aaronblankenburg/timon-box/doc/assembly/fig/overview.jpg

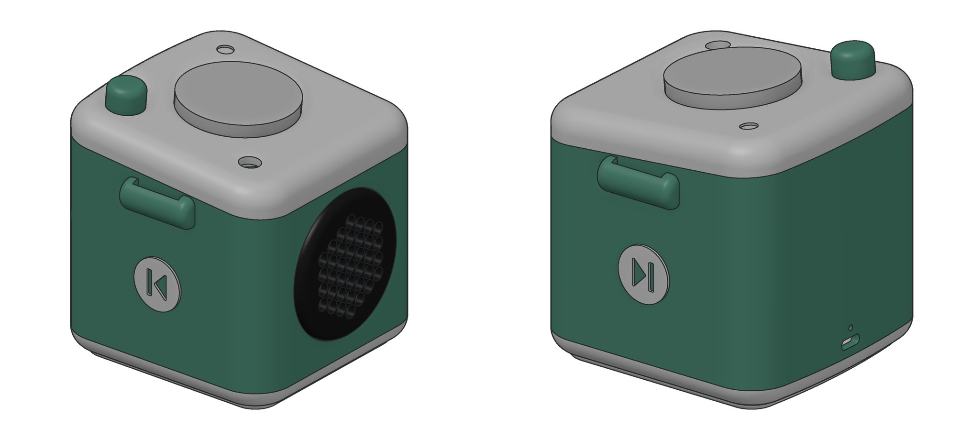
doc/assembly/fig/overview.jpg
