aaronblankenburg/timon-box/doc/assembly/fig/overview_a.jpg

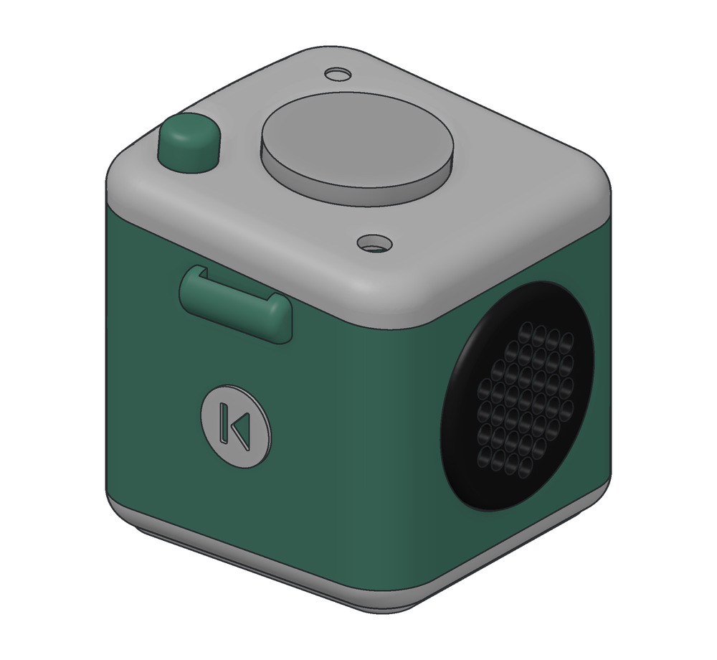
doc/assembly/fig/overview_a.jpg
