aaronblankenburg/timon-box/doc/assembly/fig/overview_b.jpg

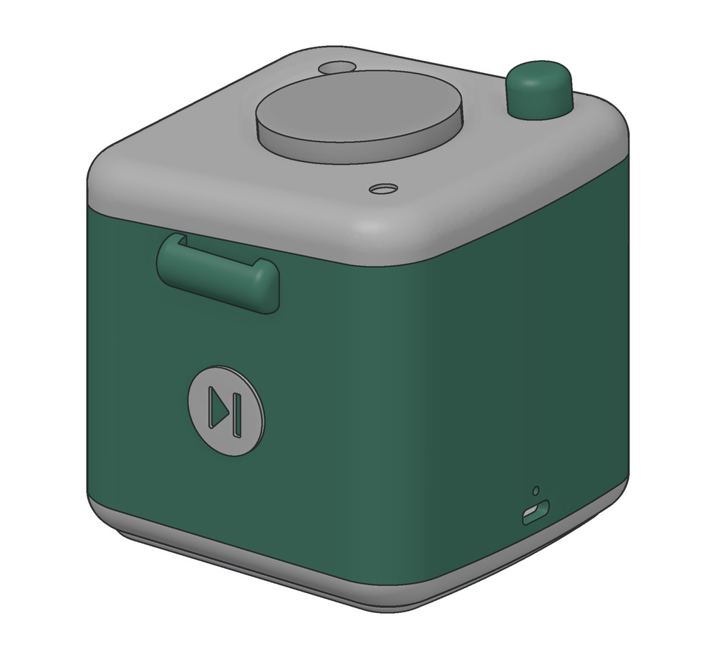
doc/assembly/fig/overview_b.jpg
