aaronblankenburg/timon-box/doc/assembly/fig/thingiverse/07_electronics.jpg

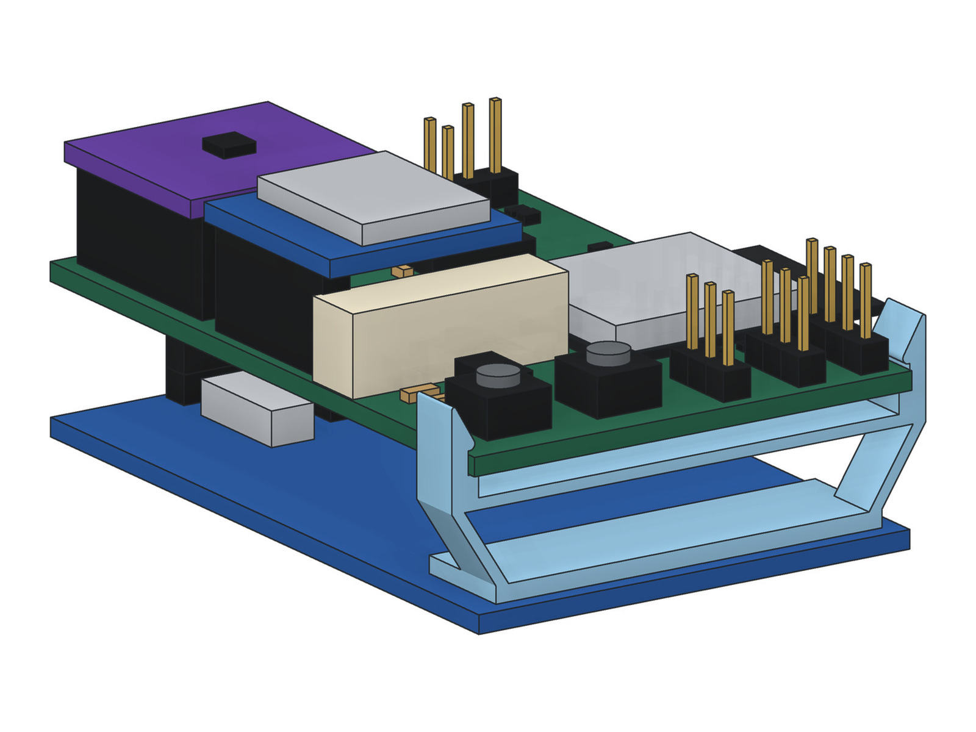
doc/assembly/fig/thingiverse/07_electronics.jpg
