aaronblankenburg/timon-box/models/pcb_spacer.step

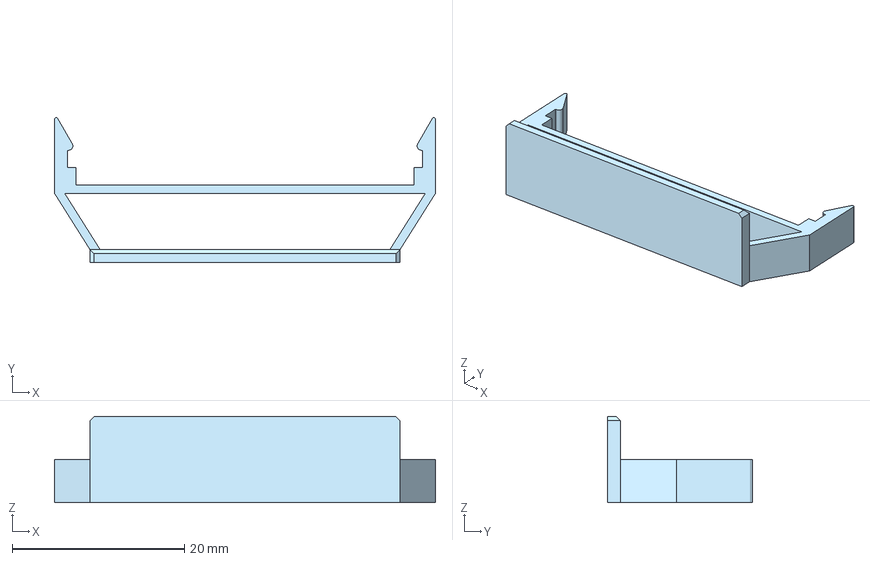
[picture p16: CAD file, 2026-10-31]
models/pcb_spacer.step
44.2 x 16.8 x 10.0 mm
