aaronblankenburg/timon-box/models/plates/timon-box_plate-3_grill-spacer.3mf

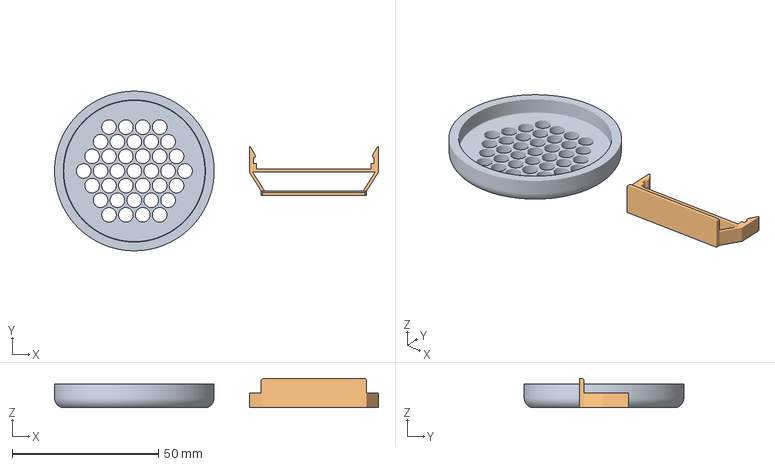
[picture p17: CAD file, 2026-11-01]
models/plates/timon-box_plate-3_grill-spacer.3mf
110.8 x 54.6 x 10.0 mm
timon-box_speaker-grill
timon-box_pcb-spacer
