aaronblankenburg/timon-box/models/stl/timon-box_back.stl

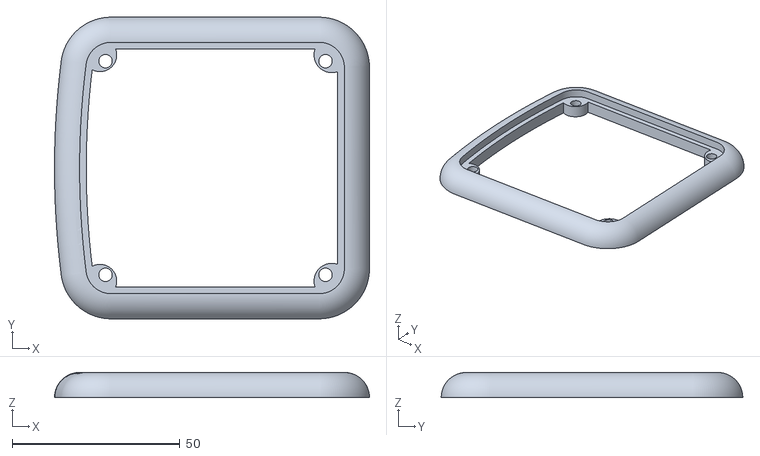
[picture p18: CAD file, 2026-11-01]
models/stl/timon-box_back.stl
94.0 x 90.0 x 7.50
