aaronblankenburg/timon-box/models/box.step

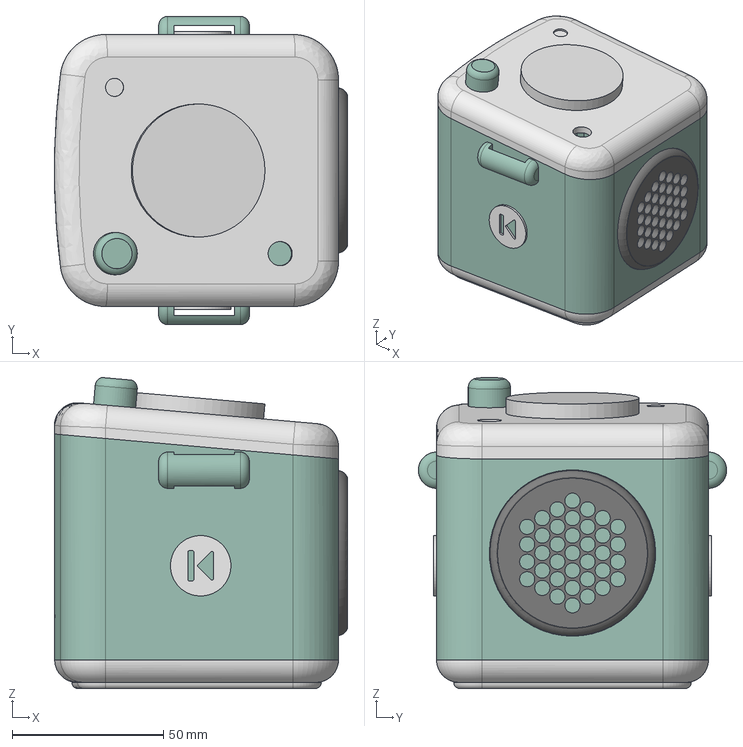
[picture p19: CAD file, 2026-10-30]
models/box.step
97.0 x 102.0 x 102.9 mm
