aaronblankenburg/timon-box/models/plates/timon-box_plate-4_bumper-tpu.3mf

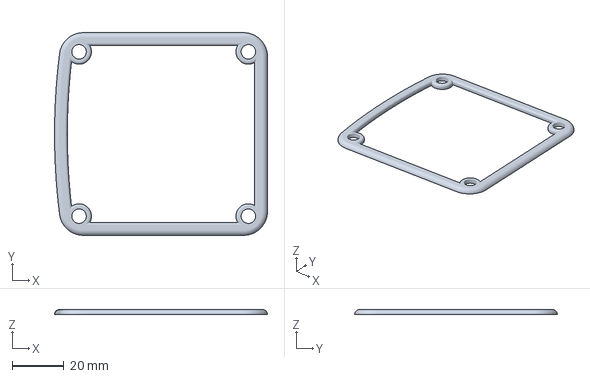
[picture p20: CAD file, 2026-11-01]
models/plates/timon-box_plate-4_bumper-tpu.3mf
82.6 x 78.6 x 2.00 mm
