aaronblankenburg/timon-box/models/plates/timon-box_bambu-studio.3mf

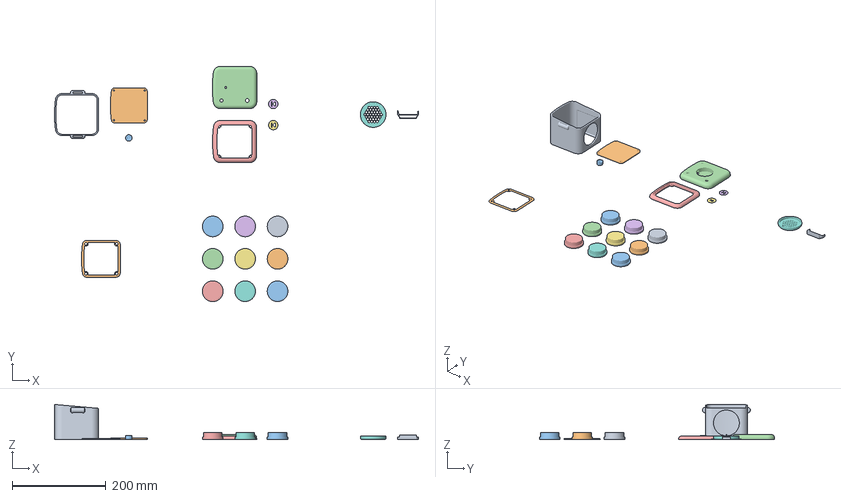
[picture p21: CAD file, 2026-11-01]
models/plates/timon-box_bambu-studio.3mf
775.1 x 500.7 x 74.7 mm
timon-box_frame_1
timon-box_door_1
timon-box_volume-knob_1
timon-box_front_1
timon-box_back_1
timon-box_prev-button_1
timon-box_next-button_1
timon-box_speaker-grill_1
timon-box_pcb-spacer_1
timon-box_bumper-tpu_1
timon-box_token_2
timon-box_token_3
timon-box_token_6
timon-box_token_5
timon-box_token_1
timon-box_token_4
timon-box_token_7
timon-box_token_8
timon-box_token_9
