aaronblankenburg/timon-box/models/stl/timon-box_door.stl

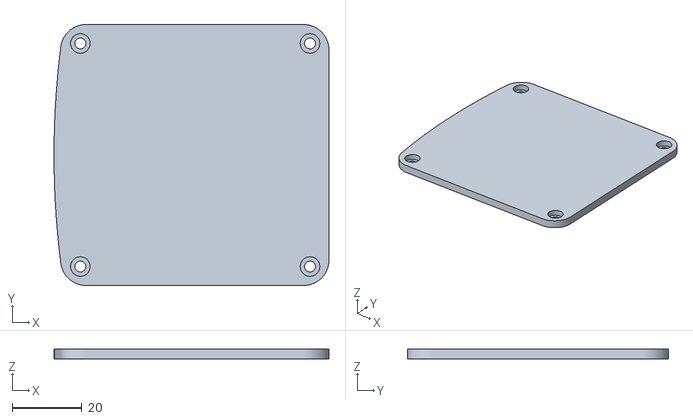
[picture p22: CAD file, 2026-11-01]
models/stl/timon-box_door.stl
78.6 x 74.6 x 2.90
