aaronblankenburg/timon-box/models/plates/timon-box_plate-2_lid-bottom-buttons.3mf

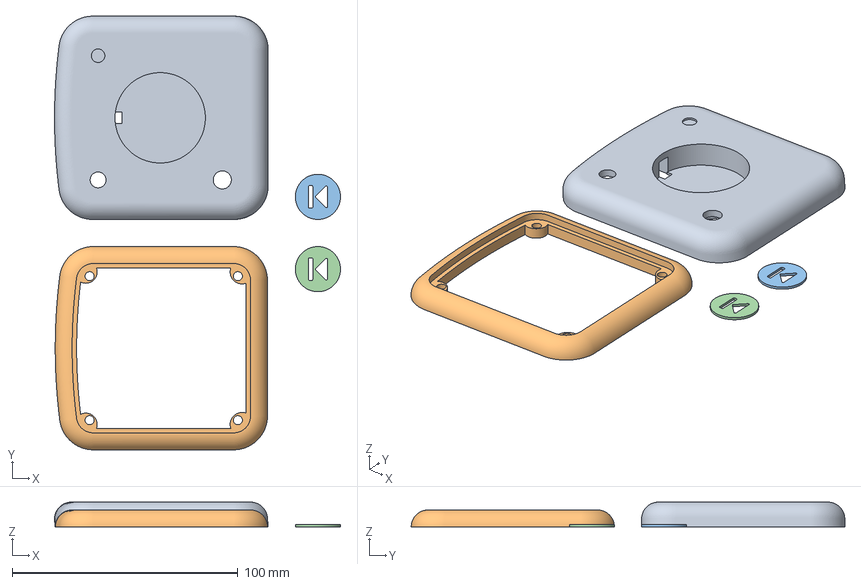
[picture p23: CAD file, 2026-11-01]
models/plates/timon-box_plate-2_lid-bottom-buttons.3mf
126.6 x 192.0 x 11.0 mm
timon-box_front
timon-box_back
timon-box_prev-button
timon-box_next-button
