aaronblankenburg/timon-box/models/stl/timon-box_next-button.stl

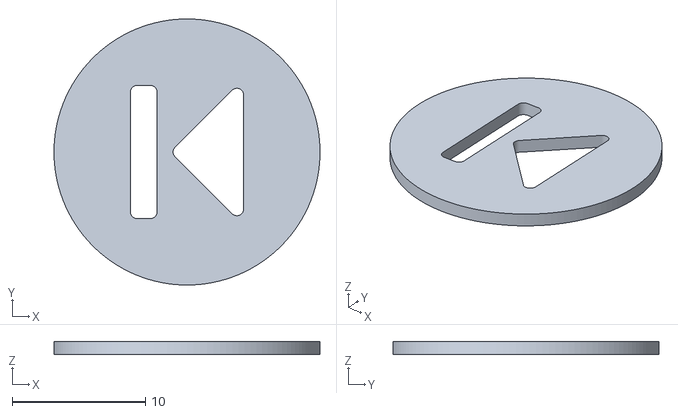
[picture p24: CAD file, 2026-11-01]
models/stl/timon-box_next-button.stl
20.0 x 20.0 x 1.00
