aaronblankenburg/timon-box/models/plates/timon-box_plate-5_9-tokens.3mf

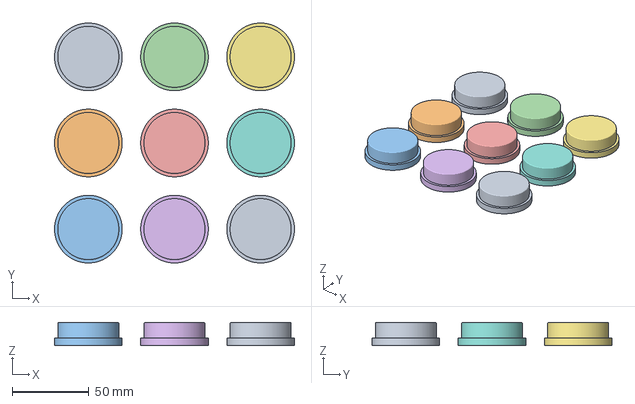
[picture p25: CAD file, 2026-11-01]
models/plates/timon-box_plate-5_9-tokens.3mf
156.0 x 156.0 x 15.0 mm
