aaronblankenburg/timon-box/models/stl/timon-box_volume-knob.stl

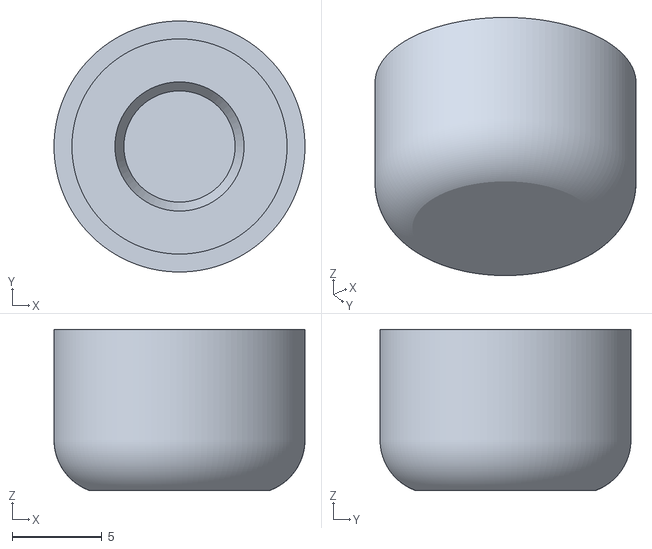
[picture p26: CAD file, 2026-11-01]
models/stl/timon-box_volume-knob.stl
14.0 x 14.0 x 9.00
