aaronblankenburg/timon-box/models/plates/timon-box_plate-1_frame-door-knob.3mf

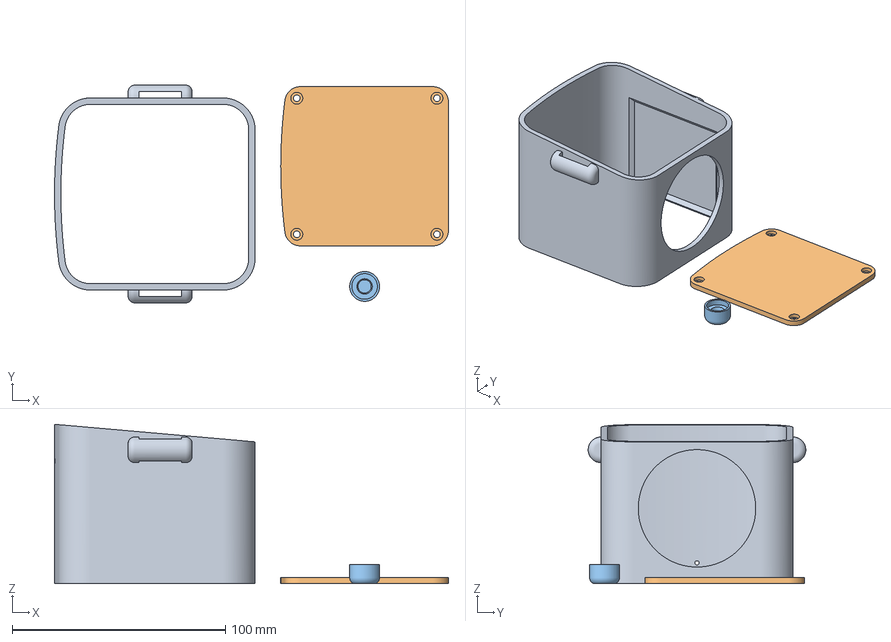
[picture p27: CAD file, 2026-11-01]
models/plates/timon-box_plate-1_frame-door-knob.3mf
184.6 x 102.0 x 74.7 mm
timon-box_frame
timon-box_door
timon-box_volume-knob
