aaronblankenburg/timon-box/models/stl/timon-box_token.stl

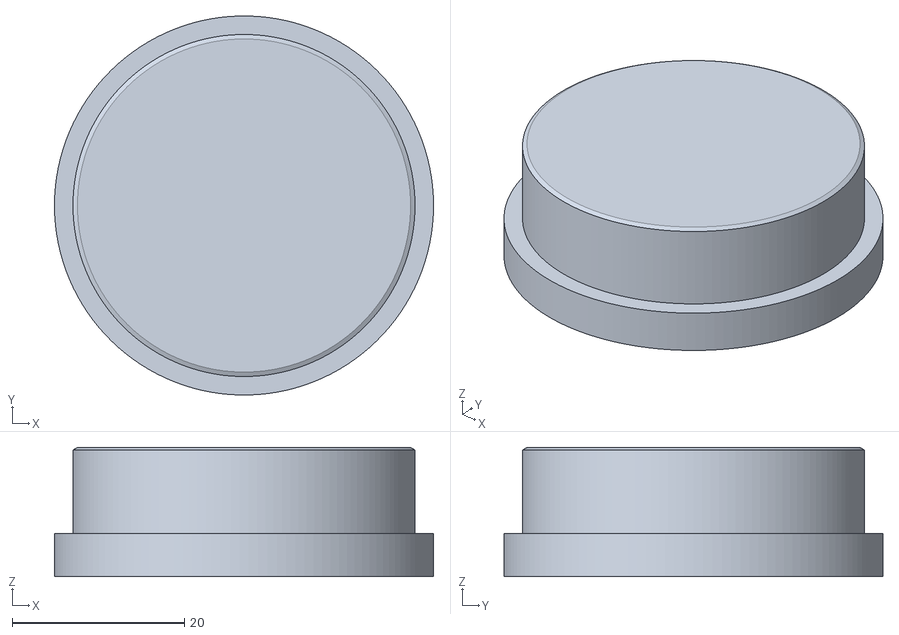
[picture p28: CAD file, 2026-11-01]
models/stl/timon-box_token.stl
44.0 x 44.0 x 15.0
