aaronblankenburg/timon-box/models/stl/timon-box_speaker-grill.stl

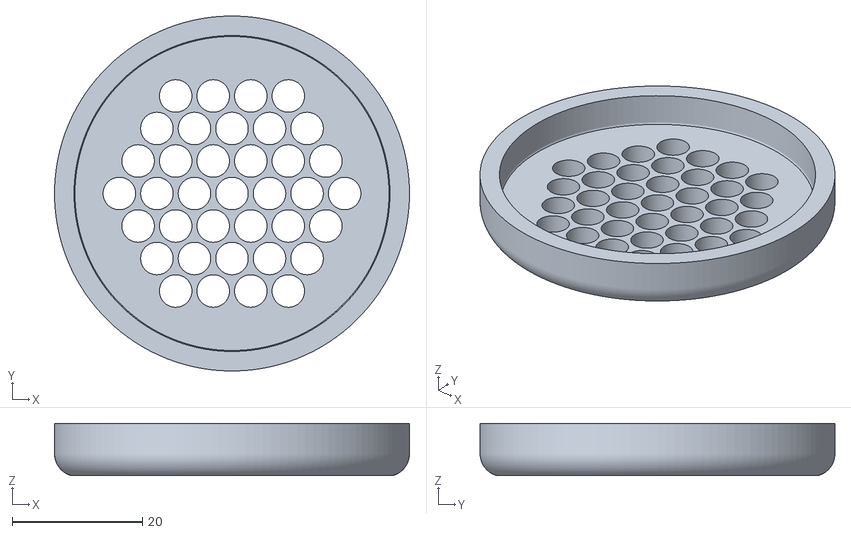
[picture p29: CAD file, 2026-11-01]
models/stl/timon-box_speaker-grill.stl
54.6 x 54.6 x 8.00
