aaronblankenburg/timon-box/models/stl/timon-box_frame.stl

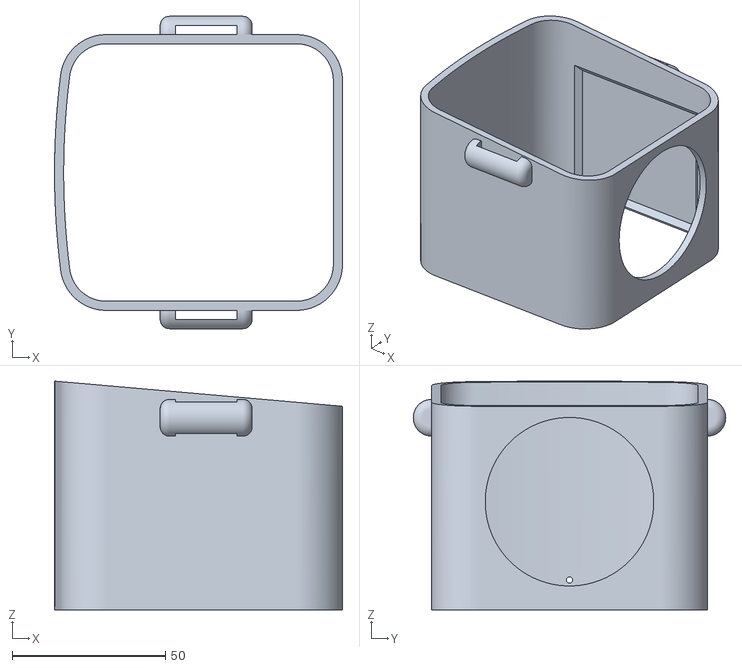
[picture p30: CAD file, 2026-11-01]
models/stl/timon-box_frame.stl
94.0 x 102.0 x 74.7
