aaronblankenburg/timon-box/models/stl/timon-box_front.stl

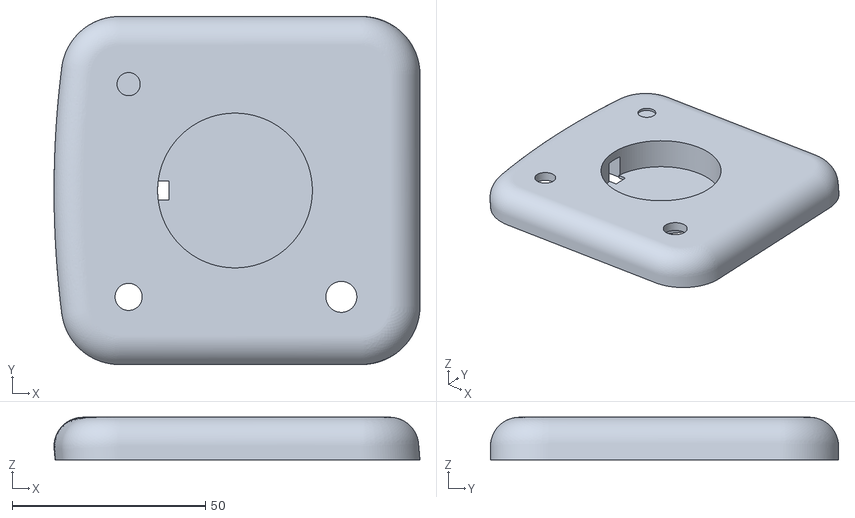
[picture p31: CAD file, 2026-11-01]
models/stl/timon-box_front.stl
94.6 x 90.0 x 11.0
