aaronblankenburg/timon-box/(list of files, cad)

Other CAD files:
models/stl/timon-box_bumper-tpu.stl
models/stl/timon-box_prev-button.stl
models/stl/timon-box_pcb-spacer.stl
