aaronblankenburg/timon-box/doc/assembly.pdf

HARDWARE-DOKU · BAUANLEITUNG

# Timon Box

## Elektronik, Druck und Zusammenbau

Platinen bestücken,
verkabeln, Gehäuse drucken und alles Schritt für Schritt zusammenbauen.


github.com/aaronblankenburg/timon-box Modell: models/box.step
Platinen: hardware/ (KiCad 8) Hintergründe: doc/hardware.md
Stand: Oktober 2026
Lizenz: CC BY-NC-SA 4.0
© 2026 Aaron Blankenburg

Inhalt

# 1 Überblick

Das Gehäuse besteht aus zehn Druckteilen. Rahmen, Boden und Deckel werden zu einer Schale verklebt. Unten bleibt eine Bodenklappe, die mit vier M3-Schrauben in Einschmelzgewinden hält. Durch sie kommt man nach dem Zusammenbau wieder an die Elektronik.

Vorn ist die Lautsprecherseite. Von vorn gesehen liegt die Taste „zurück“ links und „vor“ rechts, passend zu J2 und J3 (Kapitel 5.4). Der Deckel ist um 5° nach vorn geneigt, die Rückseite mit der USB-C-Buchse ist leicht gewölbt.

Lautstärke
Token-Mulde
RC522 darunter
LED
Lasche
für den Tragegurt

Lautsprecher
Taste „zurück“
Piezo innen

Kopfhörerbuchse
noch verschlossen

Taste „vor“
Rückseite
leicht gewölbt
Ladeanzeige
Lichtleiter zur
Lade-LED
USB-C
Laden und Flashen
Bumper (TPU)

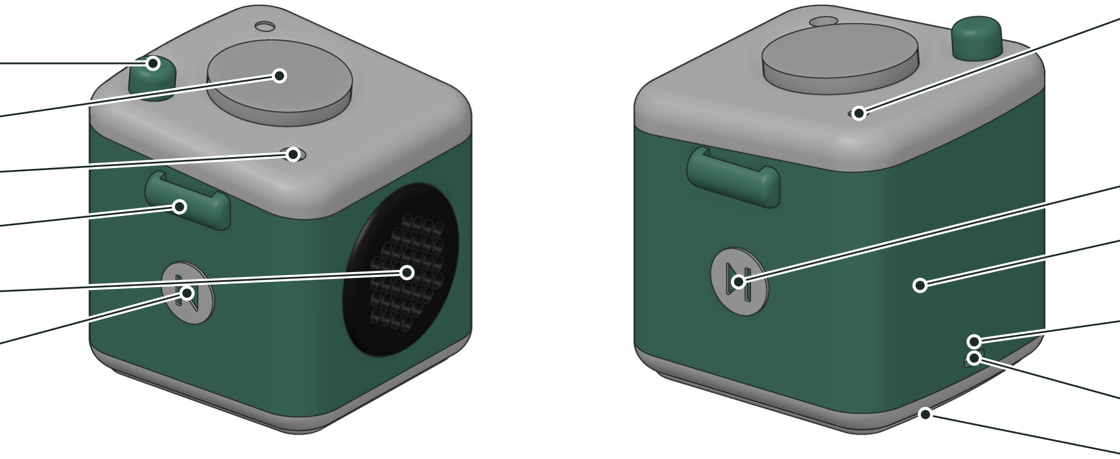
[picture p64: figure]

Abb. 1 Links von vorn, rechts von hinten.

Maß | Wert
Grundfläche | 94 × 90 mm, mit Laschen 102 mm breit
Höhe mit Bumper | hinten 94,5 mm, vorn 87 mm
Darüber | Token 5 mm, Drehknopf 9 mm über der Deckeloberfläche

## Auf einen Blick

DRUCK
PETG oder PLA, Bumper
TPU, 0,2 mm Schichthöhe

VERBINDUNGEN
Sekundenkleber,
2K-Kleber, UV-Lack,
Heißkleber, Klebeband

SCHRAUBEN
4 × M3 × 5 in
Einschmelzgewinden M3

AKKUS
2 × 18650, parallel
geschaltet

Hinweis: Firmware, Platinen, Modell und diese Anleitung liegen im Repo github.com/aaronblankenburg/timon-box. Kapitel 5 beschreibt den Aufbau der Elektronik, Kapitel 6 den Zusammenbau. Hintergründe zur Schaltung stehen in doc/hardware.md, die Pinbelegung der Firmware in doc/architecture.md, das Abstimmen der Klopfsensoren in doc/development.md.

Timon Box · Bauanleitung | Überblick
Stand Oktober 2026 · © Aaron Blankenburg · Lizenz CC BY-NC-SA 4.0 | Seite 2 von 30

# 2 Druckteile

Die Teilenamen sind die aus dem STEP-Modell models/box.step. Dort liegen alle Teile in Einbaulage. Der Abstandshalter für die Elektronik liegt als eigene Datei in models/pcb_spacer.step.

Teil | Funktion | Material | Befestigung
front | Deckel mit Token-Mulde, LED, Poti, Kopfhörerbuchse und Tasche für den Mikroschalter | PETG/PLA | Sekundenkleber auf frame
frame | Rahmen: Seitenwände mit Laschen für den Tragegurt, Lautsprecheröffnung, USB-C-Ausschnitt. An den Tasten ist die Wand innen auf 1 mm gedünnt | PETG/PLA | –
back | Boden: Rahmen um die Klappe mit vier Gewindeeinsätzen | PETG/PLA | Sekundenkleber an frame
door | Bodenklappe | PETG/PLA | 4 × M3 × 5 in back
bumper | Fuß unter der Klappe | TPU | Sekundenkleber an door
speaker grill | Lautsprechergitter, mit Stoff bezogen | PETG/PLA | eingesetzt, Sekundenkleber
prev button | Taste „zurück“, Ø 20 × 1 mm | PETG/PLA | Sekundenkleber, außen auf frame
next button | Taste „vor“, Ø 20 × 1 mm | PETG/PLA | Sekundenkleber, außen auf frame
volume | Drehknopf | PETG/PLA | auf die Poti-Achse gesteckt
token | Token mit eingedrucktem NFC-Tag, einer je Album | PETG/PLA | –
pcb_spacer | Abstandshalter zwischen Hauptplatine und RC522, eigene Datei models/pcb_spacer.step | PETG/PLA | eingeclipst

volume
Drehknopf

prev button
Taste „zurück“

door
Bodenklappe

token

front
Deckel

next button
Taste „vor“

speaker grill
Lautsprechergitter
frame
Rahmen

back
Boden

bumper
Fuß, TPU

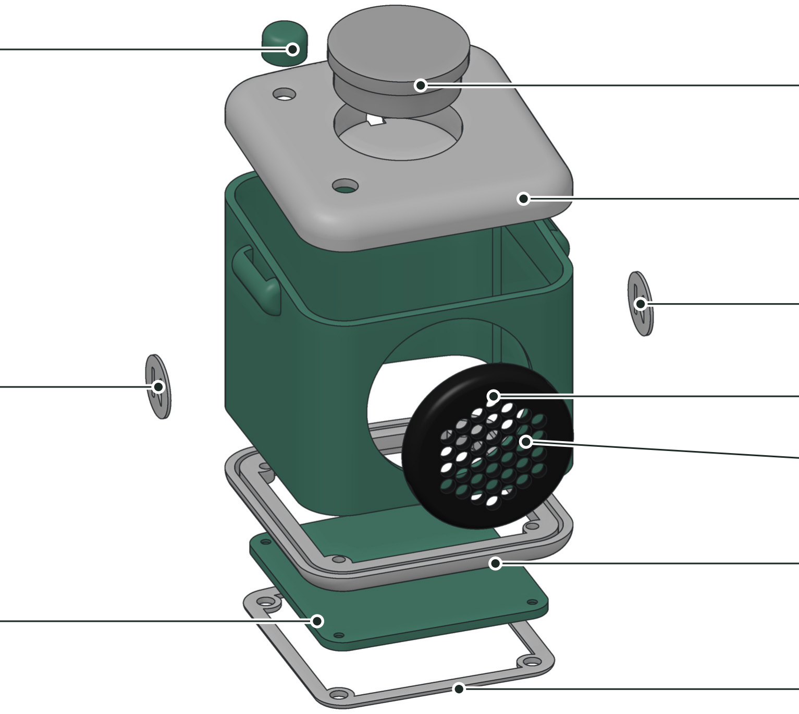
[picture p65: figure]

Abb. 2 Explosionszeichnung. Unten die Klappe mit Bumper, seitlich die Tasten, vorn das Lautsprechergitter.

Timon Box · Bauanleitung | Druckteile
Stand Oktober 2026 · © Aaron Blankenburg · Lizenz CC BY-NC-SA 4.0 | Seite 3 von 30

# 3 Drucken

Alle Teile außer dem Bumper aus PETG oder PLA, den Bumper aus TPU. PETG verträgt Wärme besser, etwa im Auto oder auf der Fensterbank.

Am schnellsten geht es mit den fertigen Druckbetten in models/plates/: eine 3MF-Datei pro Farbe, die Teile schon angeordnet, für Betten ab 220 × 220 mm. In PrusaSlicer öffnet man sie als Projekt (Datei › Projekt öffnen), dann sind Schichthöhe, Wände, Füllung, Stützen und die Pause für die Tokens schon eingestellt. Für Bambu Studio liegt dort ein Projekt mit allen fünf Betten, ebenfalls fertig eingestellt. Andere Slicer übernehmen nur die Anordnung. Einzelne Teile liegen als STL in models/stl/, benannt wie in der Tabelle und schon so gedreht, wie sie aufs Bett kommen.

Einstellungen: 0,2 mm Schichthöhe, 3 Wände, 15–20 % Füllung. Die NFC-Tasche im Token ist auf 0,2 mm Schichthöhe ausgelegt.

Teil | Aufs Druckbett | Stützen | Hinweis
frame | Unterkante | im Lautsprecherloch und unter den Laschen | Das Gitter hat nur 0,2 mm Spiel: Loch entgraten
front | Unterkante, Oberseite nach oben | innen unter der Decke, nur vom Druckbett (Baumstützen) | Taschen für Mikroschalter und Buchse freimachen
back | Seite zum Rahmen (kopfüber) | keine
door | Innenseite | keine | Senkungen zeigen nach oben
bumper | Klebeseite | keine | TPU, langsam drucken
speaker grill | Außenseite | keine
prev button, next button | Sichtseite | keine | 1 mm dünn
volume | Oberseite | keine
token | Oberseite (Bildseite) | keine | Pause vor der letzten Schicht für den NFC-Tag, siehe unten
pcb_spacer | flache Seite | keine | Eigene Datei, siehe Kapitel 5.2

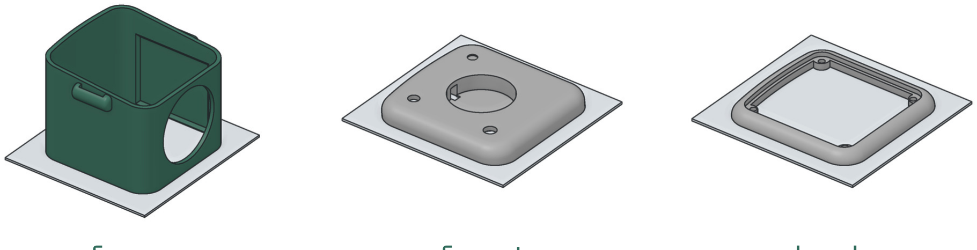
[picture p66: figure]

frame
Unterkante

front
Unterkante

back
kopfüber

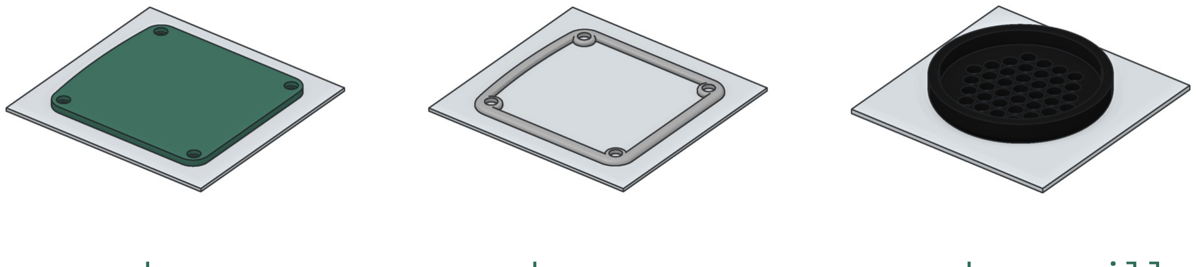
[picture p67: figure]

door
Innenseite

bumper
Klebeseite, TPU

speaker grill
Außenseite

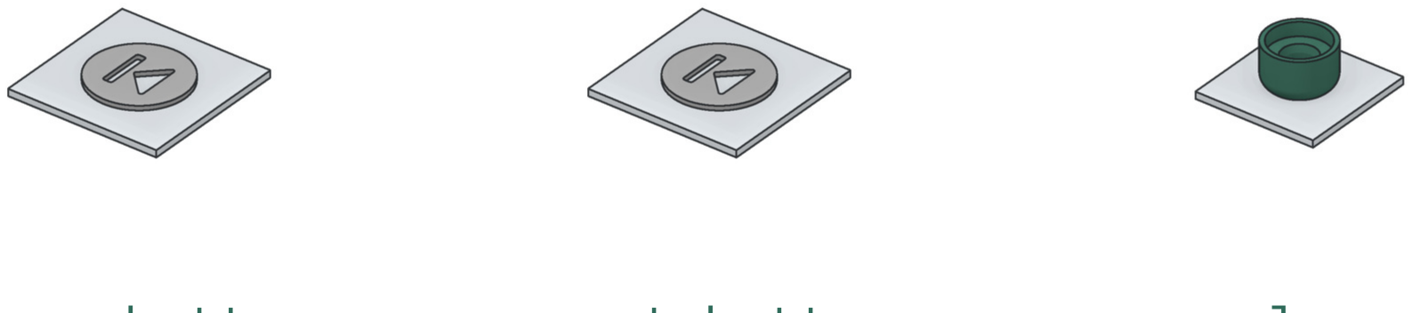
[picture p68: figure]

prev button
Sichtseite

next button
Sichtseite

volume
Oberseite

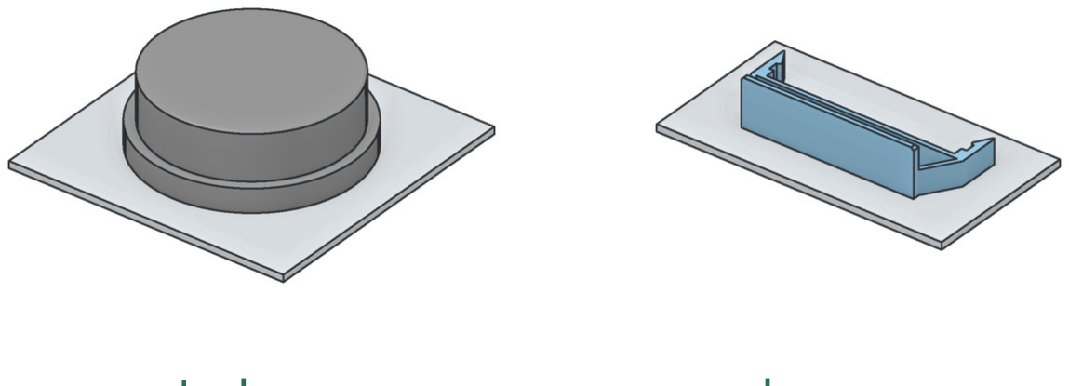
[picture p69: figure]

token
Oberseite

pcb_spacer
flache Seite

Abb. 3 Druckausrichtung, die graue Fläche ist das Druckbett.

Tipp: Den Deckel mit der Oberseite nach oben drucken. Andersherum lägen die gerundeten Kanten (R 7,5) direkt auf dem Bett und würden unsauber. So bleiben Oberseite und Rundungen glatt, die Stützen sitzen innen, wo man sie nicht sieht. Die Bohrung der Kopfhörerbuchse ist oben mit einer 0,2-mm-Schicht verschlossen und bleibt zu, solange keine Buchse eingebaut ist.

Timon Box · Bauanleitung | Drucken
Stand Oktober 2026 · © Aaron Blankenburg · Lizenz CC BY-NC-SA 4.0 | Seite 4 von 30

## Token mit NFC-Tag

Der Token ist 15 mm hoch und innen hohl. 0,2 mm über der Unterseite liegt eine Tasche (Ø 26 × 0,4 mm) für einen runden NFC-Klebetag: 25 mm, NTAG, höchstens 0,4 mm dick.

Körper Ø 39,7 mm
passt in die Mulde Ø 40

Rand
liegt im Gehäuse auf
dem Deckel
Oberseite Ø 44 mm
liegt auf dem Bett

Fase
NFC-Tasche Ø 26 ×
0,4 mm
0,2 mm unter der
Unterseite
Hohlraum

Druckbett

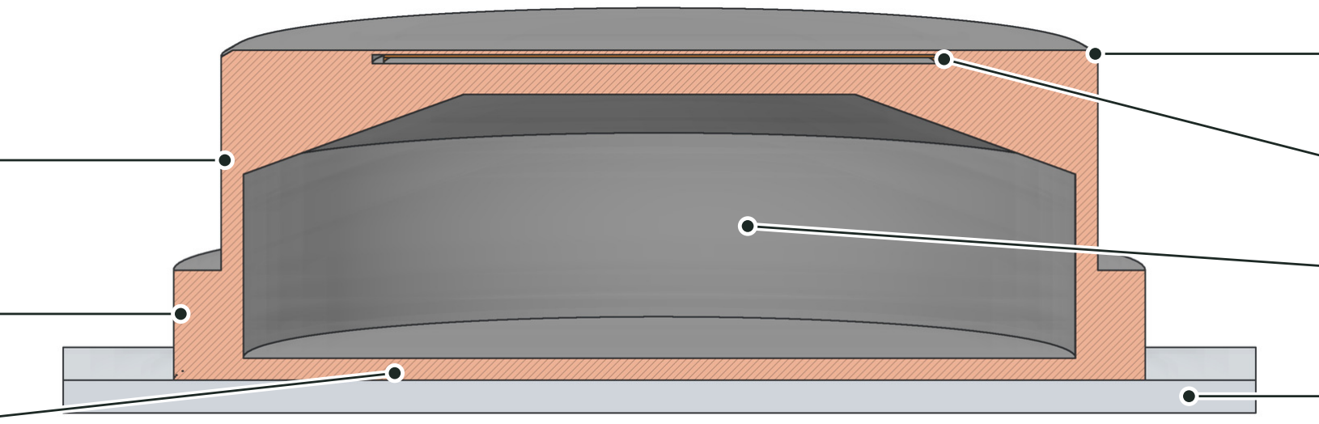
[picture p70: figure]

Abb. 4 Token im Schnitt, so wie er gedruckt wird.

- Den Token mit der Oberseite (Ø 44 mm) aufs Bett legen. Die Bildfläche wird so glatt, und der breite Rand haftet gut.
- Im Slicer eine Pause vor der letzten Schicht einfügen, bei 0,2 mm Schichthöhe vor Z = 15,0 mm. Dann ist die NFC-Tasche oben offen.
- In der Pause den NFC-Tag mit der Klebeseite nach unten in die Tasche legen und andrücken. Weiterdrucken, die letzte Schicht schließt die Tasche. Der Tag liegt dann 0,2 mm unter der Unterseite, direkt über dem RC522.
- Warnt der Slicer vor langen Brücken, ist das die Decke über dem Hohlraum im Token. Damit ist zu rechnen.
- Das Bild aus dem Token-Bogen (tools/token-sheet.html) grob ausschneiden, zum Beispiel mit doppelseitigem Klebeband auf die Oberseite (Ø 44 mm) kleben und ringsum an der Kante abschneiden.

Druckbett

Z 0–14,4 Token, Oberseite auf dem Bett

NFC-Tag | Z 14,4–14,6 Tasche Z 14,6–14,8 Tasche

Z 14,8–15,0 letzte Schicht, schließt die Tasche

Pause: Tag einlegen

Hinweis: Sondertokens für Bluetooth und Management werden genauso gedruckt. Ihre UIDs kommen in die platformio.ini, siehe Kapitel 5.5.

Timon Box · Bauanleitung | Drucken
Stand Oktober 2026 · © Aaron Blankenburg · Lizenz CC BY-NC-SA 4.0 | Seite 5 von 30

# 4 Material und Werkzeug

## Zukaufteile fürs Gehäuse

Teil | Anzahl | Anmerkung
Gewindeeinsatz M3 | 4 | Für Bohrung Ø 4,0 mm, 4 mm lang. Bis 5,7 mm geht, ragt dann innen 1,2 mm heraus

Zylinderkopfschraube M3 × 5, ISO

4762 | 4 | Kopf Ø 5,5 mm versinkt in der Senkung Ø 5,6 mm und im Bumper. Nicht länger als 5 mm: In zwei Ecken steht direkt über dem Einsatz ein Akku
18650-Zelle | 2 | Einfache Zellen ohne Schutzschaltung (65 mm) mit Lötfahnen, gleicher Typ und gleiche Spannung. Parallel geschaltet
Stoff | 1 Stück, 8 × 8 cm | Dünn und dehnbar, zum Beispiel eine Socke
NFC-Klebetag, rund, 25 mm | je Token | NTAG, höchstens 0,4 mm dick
Rolladengurt, ca. 15 mm breit | ca. 30 cm | Tragegurt durch die Laschen, aus dem Baumarkt
Kabelbinder, schmal | 1 | Um Hauptplatine, Abstandshalter und RC522
Transparentes Filament, 1,75 mm | ein paar cm | Lichtleiter von der Lade-LED nach außen, darf gebogen verlaufen

## Kleber und Kleinkram

Material | wofür
Sekundenkleber | Gehäuseschale, Tasten, Lautsprechergitter, Bumper
2-Komponenten-Kleber (Epoxid) | Lautsprecher, Ladeschaltung, Step-up
UV-Lack mit UV-Lampe | LED, USB-C-Buchse, Mikroschalter
Heißkleber | Akkus
Dünnes doppelseitiges Klebeband | Piezos, RC522, Bilder auf den Token
Kapton-Band, Schrumpfschlauch | Akkukontakte und Lötstellen isolieren
Nadel und reißfestes Garn oder Nähmaschine | Tragegurt
Schleifpapier, Grundierung, Lack | optional, für die Oberfläche

## Elektronik im Gehäuse

Die vollständige Teileliste steht in Kapitel 5.1. Diese Teile müssen zum Gehäuse passen:

Teil | Ort | Passt, wenn …
Lautsprecher, 3 W | innen am Gitter | Ø 50–57 mm liegt mit dem Rand auf dem Ring (Ø 48,6–54,6 mm); kleinere sitzen im Ring direkt am Gitter
Piezo-Scheibe, ca. 35 mm | innen an den Seitenwänden | gedünnte Fläche 56 × 50 mm
PL9823, 8 mm | Deckel vorn links | Bohrung Ø 8 mm
Poti 10 kΩ | Deckel hinten links | Gewinde M7 (Bohrung Ø 7 mm), Achse 6 mm rund. Gewindehülse und Mutter müssen in die 3 mm tiefe Aussparung im Knopf passen
RC522 | unter der Token-Mulde | Muldenboden 1 mm
Mikroschalter | Tasche neben der Mulde | Hebel reicht durch den Schlitz in die Mulde
USB-C-Platine | Rückwand unten | Ausschnitt 9,2 × 3,5 mm
Timon Box · Bauanleitung | Material und Werkzeug
Stand Oktober 2026 · © Aaron Blankenburg · Lizenz CC BY-NC-SA 4.0 | Seite 6 von 30

Teil | Ort | Passt, wenn …
Power Latch mit TP4056 | Wandinnenseite, nahe der USB-C-Buchse | Lichtleiter vom Loch Ø 2 mm bis an die Lade-LED
Step-up 5 V | freie Stelle an der Wandinnenseite

nicht auf den gedünnten Tastenflächen

Kopfhörerbuchse 3,5 mm | Deckel hinten rechts, optional | Bohrung Ø 6 mm, Tasche 12 × 7 × 2 mm

## Werkzeug

Lötkolben (für die Einsätze eine Einschmelzspitze oder eine alte Spitze), Innensechskant 2,5 mm, UV-Lampe, Heißklebepistole, Multimeter, Säge oder Seitenschneider für die Poti-Achse, Cutter, Schleifpapier. Für die Elektronik dazu: Lötkolben mit feiner Spitze, Lötzinn, Flussmittel, Entlötlitze, Pinzette, Abisolierzange und ein USB-C-Kabel zum Flashen.

# 5 Elektronik

Die Elektronik besteht aus zwei Platinen und ein paar lose verdrahteten Teilen. Die Bestückungspläne sind direkt aus den KiCad-Dateien unter hardware/ gezeichnet, die Schaltpläne stehen im Anhang.

- Hauptplatine (40,9 × 60,5 mm): ESP32, USB-seriell-Wandler CH340C, 3,3-V-Regler und drei Module auf Buchsenleisten: I²S-Verstärker MAX98357A und SD-Karte oben, RFID-Leser RC522 unten.
- Power Latch V2 (31,3 × 18,3 mm): Lademodul TP4056, Umschaltung zwischen USB und Akku und die Selbsthaltung. Ein Mikroschalter schaltet die Box ein, wenn ein Token aufgelegt wird. Danach hält der ESP32 die Box selbst an. Anders lässt sie sich nicht einschalten, auch nicht über USB.
- Lose verdrahtet: 18650-Zellen, USB-C-Buchse, Boost-Wandler auf 5 V, zwei 2N7000, Mikroschalter, zwei Piezos, Poti, LED und Lautsprecher.
Ein 7-poliges Kabel verbindet die Hauptplatine mit der Stromseite. Über dieses Kabel laufen auch die USB-Datenleitungen. Die USB-C-Buchse am Gehäuse lädt also den Akku und dient zugleich zum Flashen.

## 5.1 Teileliste

Teil | Anzahl | Anmerkung
ESP32-WROOM-32, -32D oder -32E | 1 | Ohne PSRAM. Ein WROVER geht nicht, dort belegt der PSRAM GPIO 16
und 17, die SD-Karte braucht sie
MAX98357A-Modul | 1 | I²S-Verstärker. 7 Pins: LRC, BCLK, DIN, GAIN, SD, GND, VIN
microSD-Modul für 3,3 V | 1 | 6 Pins: 3V3, CS, MOSI, CLK, MISO, GND. Die Platine wird gekürzt (Schritt
E5)
RC522-Modul | 1 | RFID mit 13,56 MHz. 8 Pins, sitzt unter der Hauptplatine

TP4056-Lademodul mit
Schutzschaltung
1 | Wird auf die Rückseite der Power Latch gelötet
Boost-Modul mit festen 5 V | 1 | Manche Module stellt man erst mit Lötbrücken auf 5 V
18650-Zelle | 1–2 | Einfache Li-Ion-Zellen, 65 mm lang. Im gedruckten Gehäuse zwei, parallel. Die Schutzschaltung sitzt auf dem TP4056-Modul
USB-C-Buchse auf kleiner Platine | 1 | Mit 5,1 kΩ an CC1 und CC2, sonst liefern USB-C-Netzteile keine 5 V. D+ und D− müssen herausgeführt sein
2N7000 (TO-92) | 2 | Umbau an der Power Latch (Schritt E8)
Mikroschalter 12,8 × 5,8 mm | 1 | Wechsler mit C, NO und NC. Der Token drückt ihn
Piezo-Scheibe, etwa 35 mm | 2 | Klopfsensoren für Vor und Zurück
Poti 10 kΩ linear | 1 | Lautstärke
Timon Box · Bauanleitung | Elektronik
Stand Oktober 2026 · © Aaron Blankenburg · Lizenz CC BY-NC-SA 4.0 | Seite 7 von 30

Teil | Anzahl | Anmerkung
PL9823, 8 mm | 1 | Bedrahtete RGB-LED mit eingebautem Controller, Farbreihenfolge RGB
Lautsprecher, 3 W | 1 | Klein, 4 oder 8 Ω
JST-XH-Buchse 7-polig, stehend, mit Stecker | 1 | 2,5 mm Raster, für das Kabel zur Stromseite
Buchsen- und Stiftleisten, 2,54 mm | 7-polig für den Verstärker, 6-polig für die SD-Karte, 8-polig für das RC522
microSD-Karte | 1 | FAT32
NFC-Klebetags, rund, 25 mm | je Token | 13,56 MHz, NXP NTAG mit 7-Byte-UID. Sie werden beim Druck in den
Token eingelegt (Kapitel 3)

## 5.2 Hauptplatine

Bauteil | Wert | Bauform | Aufgabe
U1 | ESP32-WROOM-32(D/E) | Modul
U2 | AMS1117-3.3 | SOT-223 | 3,3 V aus den 5 V vom Kabel
U3 | CH340C | SOIC-16 | USB-seriell, ohne Quarz
Q1, Q2 | 2N7002 | SOT-23 | Auto-Reset: DTR und RTS steuern EN und IO0
D1, D2 | BZT52C3V3 | SOD-323 | Zenerdioden, begrenzen die Piezo-Spannung auf 3,3 V
R1, R2 | 100 kΩ | 0805 | Last parallel zu den Piezos
R3 | 10 kΩ | 0805 | Pull-up an EN
R4, R5 | 10 kΩ | 0805 | Pull-ups für I²C (Reserve)
C1, C8 | 100 nF | 0805 | Abblockkondensatoren CH340C und ESP32
C2 | 1 µF | 0805 | Mit R3 die Startverzögerung an EN
C3 | 10 µF | 0805 | Eingang AMS1117
C4, C7 | 22 µF | 1206 | 3,3 V
C5, C6 | – | 0805 | Nicht bestücken
SW1, SW2 | Taster 6 × 6 mm | PTS645 | RST und BOOT
J4 | JST XH, 7-polig, stehend | | Kabel zur Stromseite, siehe Schritt E3
J1, J5 | 3-polig | | Poti und LED, Stiftleiste oder Kabel direkt
J2, J3 | 2-polig | | Piezos, Stiftleiste oder Kabel direkt
J6 | 4-polig | | I²C, Reserve für Erweiterungen. Bleibt frei
MAX1 | Buchsenleiste 7-polig | | MAX98357A-Modul
U4 | Buchsenleiste 6-polig | | SD-Modul
P1 | Buchsenleiste 8-polig, Rückseite | | RC522-Modul
Timon Box · Bauanleitung | Elektronik
Stand Oktober 2026 · © Aaron Blankenburg · Lizenz CC BY-NC-SA 4.0 | Seite 8 von 30

## Timon-Box 1.0

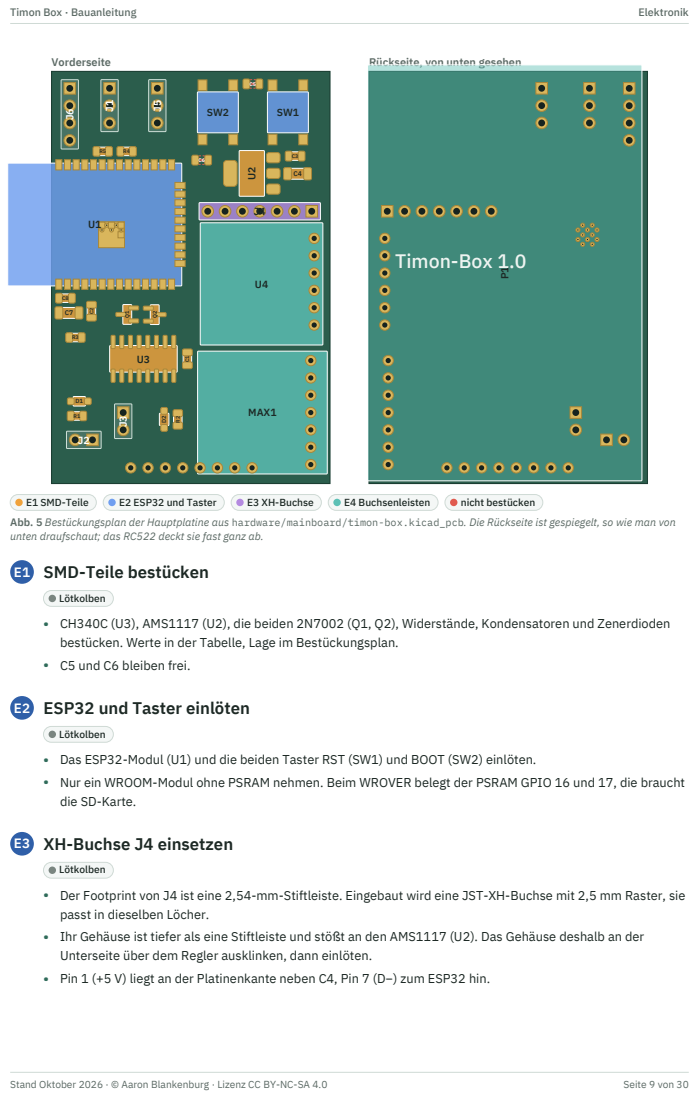
[picture p71: page 9]

Abb. 5 Bestückungsplan der Hauptplatine aus hardware/mainboard/timon-box.kicad_pcb. Die Rückseite ist gespiegelt, so wie man von
unten draufschaut; das RC522 deckt sie fast ganz ab.

Lötkolben
• CH340C (U3), AMS1117 (U2), die beiden 2N7002 (Q1, Q2), Widerstände, Kondensatoren und Zenerdioden
bestücken. Werte in der Tabelle, Lage im Bestückungsplan.
• C5 und C6 bleiben frei.

• Das ESP32-Modul (U1) und die beiden Taster RST (SW1) und BOOT (SW2) einlöten.
• Nur ein WROOM-Modul ohne PSRAM nehmen. Beim WROVER belegt der PSRAM GPIO 16 und 17, die braucht
die SD-Karte.

• Der Footprint von J4 ist eine 2,54-mm-Stiftleiste. Eingebaut wird eine JST-XH-Buchse mit 2,5 mm Raster, sie
passt in dieselben Löcher.
• Ihr Gehäuse ist tiefer als eine Stiftleiste und stößt an den AMS1117 (U2). Das Gehäuse deshalb an der
Unterseite über dem Regler ausklinken, dann einlöten.
• Pin 1 (+5 V) liegt an der Platinenkante neben C4, Pin 7 (D−) zum ESP32 hin.

### E4 Buchsenleisten einlöten

Lötkolben

- Oben die Buchsenleisten für den Verstärker (MAX1, 7-polig) und das SD-Modul (U4, 6-polig) einlöten, unten die für das RC522 (P1, 8-polig).

### E5 SD-Modul kürzen

- Die Platine des SD-Moduls ragt über die XH-Buchse. Die Kante zur Buchse hin absägen oder abschleifen, bis das Modul neben der Buchse steckt (Foto unten).

### E6 Module einstecken

Lötkolben

- Verstärker und SD-Modul oben einstecken.
- Am RC522 die Stiftleiste so einlöten, dass es unter der Hauptplatine sitzt.
- Genau gegenüber der Stiftleiste sichert der gedruckte Abstandshalter (pcb_spacer) die frei hängende Hauptplatine, damit sie nicht nur an der Stiftleiste hängt. Sie rastet mit ihren Längskanten zwischen seinen Armen ein, sein Fuß steht auf dem RC522. Im Gehäuse kommt noch ein Kabelbinder darum (Kapitel 6, Schritt 11).
- Im Gehäuse klebt das RC522 mit der flachen Rückseite unter der Token-Mulde (Kapitel 6, Schritt 9).

Hinweis: Am MAX98357A liegt GAIN auf GND, das sind 12 dB. SD bleibt offen. Die Firmware schickt ohnehin mono, der Kanal ist also egal.

Arme mit Rastnasen
halten die Hauptplatine
Hauptplatine

pcb_spacer
Abstandshalter

RC522

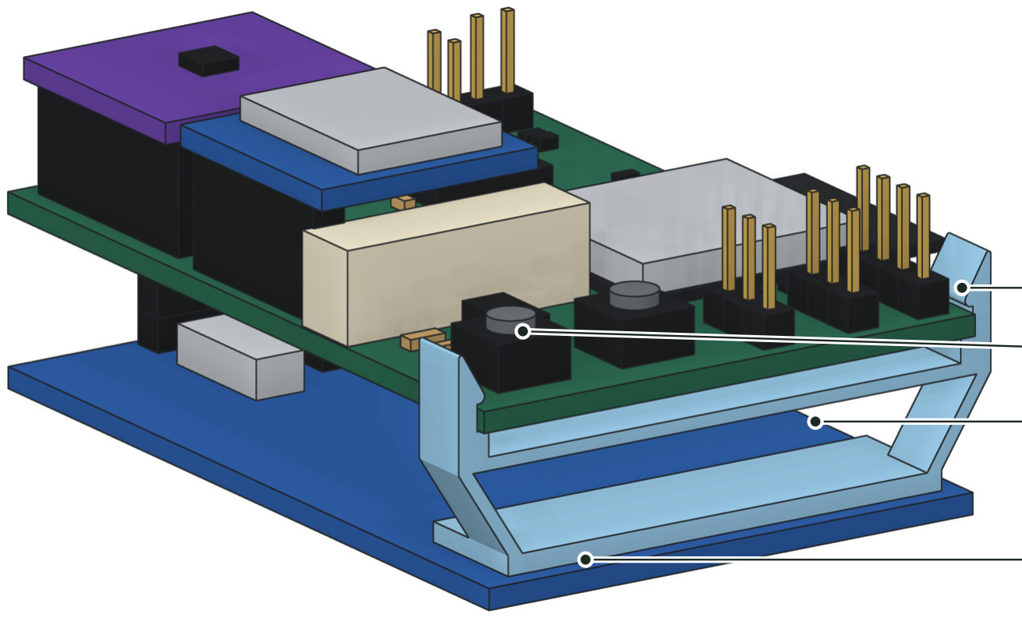
[picture p72: figure]

Abb. 6 Der Abstandshalter genau gegenüber der Stiftleiste, zwischen Hauptplatine und RC522. Die Stiftleiste sitzt am anderen Ende, hinten im Bild.

Timon Box · Bauanleitung | Elektronik
Stand Oktober 2026 · © Aaron Blankenburg · Lizenz CC BY-NC-SA 4.0 | Seite 10 von 30


Von oben: Verstärker (lila), SD-Modul, darunter die XH-Buchse J4, rechts der ESP32.


Von unten: das RC522.


Das gekürzte SD-Modul (oben eingekreist) und die ausgeklinkte XH-Buchse über dem AMS1117 (unten eingekreist).


Von der Seite: Verstärker und SD-Modul auf Buchsenleisten, das RC522 unter der Hauptplatine.

Timon Box · Bauanleitung | Elektronik
Stand Oktober 2026 · © Aaron Blankenburg · Lizenz CC BY-NC-SA 4.0 | Seite 11 von 30

## 5.3 Stromseite

Bauteil | Wert | Bauform | Aufgabe
Q1 | AO4606 | SOIC-8 | N- und P-Kanal in einem Gehäuse: P schaltet Vcc, N hält ihn
Q2 | BSS138 | SOT-23 | TrigOut, Open Drain zum ESP32
Q3 | BSS138 | SOT-23 | Einschaltimpuls
Q4 | AO3401A | SOT-23 | Akku-Zweig der Umschaltung USB/Akku
D1 | BAT85 | SOD-323 | Klemmt den Einschaltimpuls nach unten
D2 | BAT85 | DO-35, bedrahtet | USB-Zweig der Umschaltung
R1, R4–R7 | 10 kΩ | 0805 | R4/R5: Spannungsteiler für Sense
R2 | 1 MΩ | 0805 | Pull-down an Hold
R3 | 100 kΩ | 0805 | Entlädt C1
C1 | 10 µF | 0805 | Einschaltimpuls
C2 | 1 µF | 0805 | Gate des P-Kanals
J4 | TP4056-Modul | | Auf der Rückseite aufgelötet
J1 | – | | Hier werden die sieben Kabel direkt eingelötet

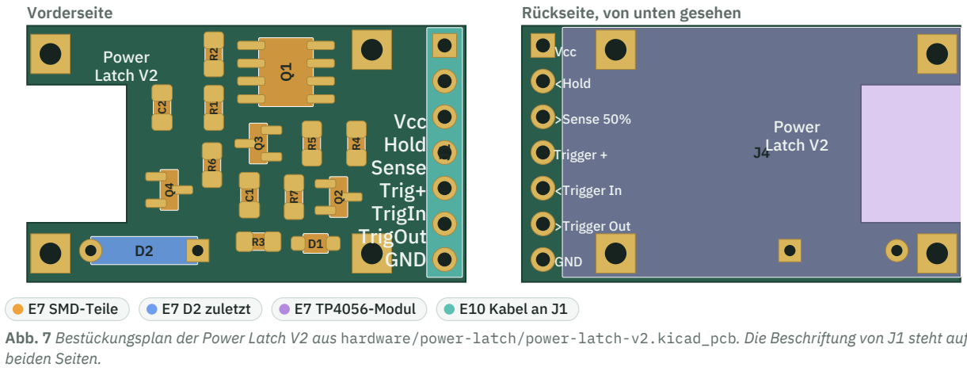
[picture p73: figure]
Vorderseite; GND; TrigOut; TrigIn; Trig+; Sense; Hold; Vcc; Latch V2; Power; Rückseite, von unten gesehen; >Sense 50%; <Hold; <Trigger In; Trigger +; >Trigger Out; E7 SMD-Teile; E7 D2 zuletzt; E7 TP4056-Modul; E10 Kabel an J1; beiden Seiten.

Abb. 7 Bestückungsplan der Power Latch V2 aus hardware/power-latch/power-latch-v2.kicad_pcb. Die Beschriftung von J1 steht auf

So schaltet die Power Latch

- USB oder Akku: Die 5 V vom USB kommen über D2 zur Last, der Akku über Q4. Steckt USB, sperrt Q4. Die Box läuft dann vom USB, und das TP4056 lädt den Akku.
- Einschalten: Ein Token drückt den Mikroschalter, der verbindet Trig+ mit TrigIn. Über C1 schaltet Q3 für etwa eine Sekunde durch, genug, damit der ESP32 startet und HOLD setzt.
- Halten: Liegt Hold hoch, hält der N-Kanal von Q1 die Box an. Sonst zieht R2 Hold auf GND.
- Token-Meldung: Solange der Schalter geschlossen ist, zieht Q2 TrigOut auf GND. Der ESP32 liest das an GPIO 32.
- Akkuspannung: R4 und R5 teilen Vcc durch 2 und geben das auf Sense. Der ESP32 misst es an GPIO 39.

### E7 Power Latch bestücken

Lötkolben

- Die SMD-Teile bestücken, die bedrahtete Diode D2 zuletzt.
- Dann das TP4056-Modul auf die Rückseite auflöten (J4). Seine vier Eckpads IN+, IN−, OUT+ und OUT− sitzen direkt auf dem Footprint.
Timon Box · Bauanleitung | Elektronik
Stand Oktober 2026 · © Aaron Blankenburg · Lizenz CC BY-NC-SA 4.0 | Seite 12 von 30

### E8 Zwei 2N7000 nachrüsten

Lötkolben

- Hold der Latch hängt nicht direkt am ESP32. Zwei 2N7000 liegen parallel: Drain an Vcc, Source an Hold.
- Gate des einen („ESP“) an HOLD vom ESP32, Kabel Pin 3 (blau). Gate des anderen („USB“) an D− der USB-C-Buchse.
- Die beiden bilden ein logisches Oder: Hold liegt hoch, wenn der ESP32 HOLD setzt oder an D− Spannung liegt. Einschalten kann keiner der beiden, denn ist die Box aus, liegt an Vcc keine Spannung.

### E9 Boost-Modul prüfen

- Das Boost-Modul vor dem Anschließen allein und ohne Last messen: Es muss 5 V liefern. Manche Module stellt man erst mit Lötbrücken auf 5 V.

### E10 Stromseite verdrahten

Lötkolben

- USB-C-Buchse, Mikroschalter, Boost-Modul, die beiden 2N7000 und die sieben Adern des XH-Kabels nach den Tabellen in 5.4 anlöten. Die Kabel lang genug für den Einbau lassen.
- Der NC-Kontakt des Mikroschalters bleibt frei. Die Akkus kommen erst beim Einbau dazu (Kapitel 6, Schritt 11).


Power Latch V2 mit dem TP4056-Modul auf der Rückseite, rechts die USB-C-Buchse, unten die 18650-Zelle.


Einer der beiden 2N7000 auf den Pads Hold und Vcc der Latch.


Stromseite mit Mikroschalter und Kabel zur Hauptplatine.

Timon Box · Bauanleitung | Elektronik
Stand Oktober 2026 · © Aaron Blankenburg · Lizenz CC BY-NC-SA 4.0 | Seite 13 von 30

## 5.4 Verkabelung

Jede Zeile nennt beide Enden. Das vollständige Verdrahtungsdiagramm der Stromseite steht im Anhang.

Kabel zwischen Hauptplatine und Stromseite

Auf der Hauptplatine steckt das Kabel in J4, auf der Stromseite gehen die Adern einzeln an verschiedene Teile. Pin 1 (+5 V) liegt an der Platinenkante neben C4, Pin 7 (D−) zum ESP32 hin.

Pin J4 | Signal | Ader | ESP32 | Stromseite
1 | +5V | rot | – | Boost OUT+
2 | GND | schwarz | – | Boost OUT−
3 | HOLD | blau | GPIO 33 | Gate des 2N7000 „ESP“
4 | SENSE | gelb | GPIO 39 | Latch J1 Pin 3, Sense 50%
5 | SW_TOKEN | orange | GPIO 32 | Latch J1 Pin 6, Trigger Out
6 | D+ | grün | CH340C | USB-C D+
7 | D− | weiß | CH340C | USB-C D− und Gate des 2N7000 „USB“

Power Latch, Anschluss J1

Pin | Beschriftung | an
1 | Vcc | Boost IN+ und Drain beider 2N7000
2 | Hold | Source beider 2N7000
3 | Sense 50% | Kabel Pin 4 (gelb)
4 | Trigger + | Mikroschalter C
5 | Trigger In | Mikroschalter NO
6 | Trigger Out | Kabel Pin 5 (orange)
7 | GND | Boost IN−


Der NC-Kontakt des Mikroschalters bleibt frei. | Der XH-Stecker mit den Aderfarben, links Pin 1.

Akku, Laden und USB-C

von | an
USB-C VBUS, GND | TP4056 IN+, IN−. Auf der Latch sind das die Pads 5v + und GND
18650 Plus, Minus (beide Zellen parallel) | TP4056 B+, B−
TP4056 OUT+, OUT− | Latch Bat+, Bat−. Das Modul ist dort aufgelötet
USB-C D+, D− | Kabel Pin 6 und 7, D− zusätzlich an das Gate des 2N7000 „USB“

Bedienteile an der Hauptplatine

Anschluss | Pins | GPIO | an
J1 „Volume“ | +3V3, SIG, GND | 36 | Poti: Enden an +3V3 und GND, Schleifer an SIG
J2 „R Btn“ | BTN, GND | 34 | Piezo an der linken Wand, von vorn gesehen: zurück
J3 „L Btn“ | BTN, GND | 35 | Piezo an der rechten Wand: vor
J5 „NeoPixel“ | +5V, DATA, GND | 2 | PL9823: VDD, DIN, GND. DOUT bleibt frei
J6 „I2C“ | +3V3, GND, SDA, SCL | 14, 13 | Reserve, frei
MAX98357A | +, − | Lautsprecher
Timon Box · Bauanleitung | Elektronik
Stand Oktober 2026 · © Aaron Blankenburg · Lizenz CC BY-NC-SA 4.0 | Seite 14 von 30

Hinweis: Die Beschriftung von J2 und J3 auf der Platine ist seitenverkehrt, in der Firmware ebenso. Wer den Piezo von J2 an die linke Wand klebt, bekommt links zurück und rechts vor.

Tipp: Die Piezos sind rückwärts gepolt: die Messingseite (meist die schwarze Ader) an BTN, die Keramikseite (meist rot) an GND. Löst ein Piezo erst beim Loslassen aus, seine Adern tauschen. Wird die Box beim Drehen nach links lauter statt leiser, die beiden äußeren Drähte am Poti tauschen.

## 5.5 Inbetriebnahme

Firmware, Platinen und diese Anleitung liegen im Repo github.com/aaronblankenburg/timon-box. Gebaut und geflasht wird mit PlatformIO, in VS Code mit der PlatformIO-Erweiterung oder mit pio auf der Kommandozeile. Am besten einmal vor dem Einbau mit offen liegender Elektronik in Betrieb nehmen und noch einmal im Gehäuse (Kapitel 6, Schritt 12).

Werte pro Box in der platformio.ini

Alles, was sich von Box zu Box unterscheidet, steht in einer eigenen Env in der platformio.ini:

[env:meinebox]
build_flags =
${env.build_flags}
-D BOX_NAME=\"Meine-Box\"
-D BOX_COLOR=\"#2f6b5a\"
-D BLUETOOTH_TAG=\"04c6d4b26e6780\"
-D MANAGEMENT_SERVER_TAG=\"042041122a6781\" -D BATTERY_ADC_LOW=1994
-D BATTERY_MV_LOW=3685
-D BATTERY_ADC_HIGH=2390
-D BATTERY_MV_HIGH=4322
-D RKS_THRESHOLD=10000
-D LKS_THRESHOLD=10000
-D KNOCK_ON_LEVEL=100
-D KNOCK_MIN_PRESS_MS=25
-D KNOCK_MAX_GAP_US=700

Im Code stehen nur Ersatzwerte. Für eine neue Box eine bestehende Env kopieren, umbenennen und die Werte anpassen. Die Werte von Timon sind ein guter Anfang.

Zeichenketten stehen in maskierten Anführungszeichen, wie bei BOX_NAME. Nach jeder Änderung neu flashen.

Wert | Bedeutung | So findet man ihn heraus
BOX_NAME | Name im WLAN, bei Bluetooth und in der Web-UI | frei wählen
BOX_COLOR | Farbe des Symbols im Browser-Tab | frei wählen
BLUETOOTH_TAG MANAGEMENT_SERVER_TAG | UIDs der beiden Sondertokens | Token auflegen, die Konsole meldet tag: <uid> (Schritt 4)
BATTERY_ADC_LOW BATTERY_MV_LOW BATTERY_ADC_HIGH BATTERY_MV_HIGH | Zwei Messpunkte für die Akkuanzeige: ADC-Wert und Spannung in mV | battery: oder die Management-Seite zeigt den ADC-Wert, ein Multimeter die Spannung (Schritt 6)

RKS_THRESHOLD
LKS_THRESHOLD
KNOCK_…
Klopfsensoren | knockdebug:1 und knockdebug:2, siehe
doc/development.md (Schritt 5)

Serielle Konsole

USB-C-Buchse an den Rechner stecken, die Box mit einem Token einschalten und pio device monitor -b 115200 starten, oder den Serial Monitor in VS Code. Befehle mit Doppelpunkt eintippen, etwa battery:, dann Enter.

Schritt für Schritt

1 SD-Karte: FAT32. Ins Wurzelverzeichnis gehören tap.mp3 (Klick beim Klopfen) und alert.mp3 (Warnton bei schwachem Akku), beide aus sdcard/. Den Aufbau der Karte beschreibt architecture.md, Abschnitt 4.

Timon Box · Bauanleitung | Elektronik
Stand Oktober 2026 · © Aaron Blankenburg · Lizenz CC BY-NC-SA 4.0 | Seite 15 von 30

2 Eigene Env: In der platformio.ini eine bestehende Env wie [env:timon] kopieren und umbenennen, BOX_NAME und BOX_COLOR anpassen. Die übrigen Werte folgen in den nächsten Schritten.
3 Flashen: Die Box mit dem Mikroschalter einschalten, über USB geht sie nicht an. Dann die USB-C-Buchse an den
Rechner stecken und ~/.platformio/penv/bin/pio run -e <box> -t upload --upload-port /dev/ttyUSBn
ausführen.
4 Sondertokens: Ein Token für den Bluetooth-Modus und einer für den Management-Modus. Jeden auflegen, die Konsole meldet tag: <uid>. Die UIDs als BLUETOOTH_TAG und MANAGEMENT_SERVER_TAG in die Env eintragen und neu flashen. Jede andere UID ist ein Album.
5 Klopfsensoren abstimmen: knockdebug:1 zeigt pro Sekunde Pegel und Flächen, knockdebug:2 zusätzlich den Verlauf des nächsten Drucks. Die Schwellen in der Env so setzen, dass ein Druck sicher auslöst und laute Musik nicht (doc/development.md). Neu flashen.
6 Akkuanzeige kalibrieren: ESP32-ADCs streuen. Die Box rechnet den ADC-Wert über zwei Messpunkte in Millivolt um. Jeder Punkt ist ein ADC-Wert und die Spannung, die ein Multimeter im selben Moment zwischen Vcc und GND an J1 der Latch misst. Am USB zeigt battery: den ADC-Wert, er und die Spannung kommen in BATTERY_ADC_HIGH und BATTERY_MV_HIGH. Im Akkubetrieb ohne USB, am besten mit halb leerem Akku, den Management-Token auflegen: Die Management-Seite zeigt unter „Battery“ den ADC-Wert, er und die Spannung kommen in BATTERY_ADC_LOW und BATTERY_MV_LOW. Neu flashen. battery: zeigt danach Spannung und Prozent, die Spannung sollte zum Multimeter passen.

Hinweis: Steckt USB, misst die Box die USB-Spannung statt des Akkus, die Akkuanzeige steht dann auf voll. Am USB-Netzteil bleibt die Box außerdem an, auch wenn die Firmware HOLD abschaltet.

Timon Box · Bauanleitung | Elektronik
Stand Oktober 2026 · © Aaron Blankenburg · Lizenz CC BY-NC-SA 4.0 | Seite 16 von 30

# 6 Zusammenbau

Erst werden die Teile vorbereitet, dann Rahmen und Boden verklebt und alles eingebaut, was an den Wänden sitzt. Der Deckel wird separat bestückt und erst zum Schluss aufgeklebt. Bis dahin kommt man von oben an alles, danach nur noch durch die Bodenklappe.

Farben in den Schritten: | Sekundenkleber | 2K-Kleber | UV-Lack | Heißkleber | Doppelseitiges Klebeband

## 6.1 Vorbereiten

Gewindeeinsatz M3
4 Stück

Bohrung Ø 4,0 mm
4,5 mm tief, durchgehend

Auflage der Klappe


Abb. 8 back von unten, die Einsätze kommen von der Seite der Klappe.

### 1 Teile vorbereiten

Schleifen und Lack (optional)

- Stützen entfernen, Löcher entgraten. Gitter, Token und Klappe probehalber einsetzen: Das Gitter muss ohne Kraft in die Öffnung passen.
- Wer lackieren will, schleift und lackiert back, frame, front und die Tasten jetzt. Die Klebeflächen dabei abkleben und blank lassen, Sekundenkleber hält auf blankem Kunststoff besser als auf Lack.

### 2 Gewindeeinsätze einschmelzen

Lötkolben

- Die vier M3-Einsätze von unten in die Bohrungen in back setzen, also von der Seite, an der später die Klappe anliegt.
- Mit dem Lötkolben gerade einschmelzen, bis sie bündig mit der Auflagefläche sind. Den Lötkolben etwa auf Drucktemperatur des Materials stellen.
Timon Box · Bauanleitung | Zusammenbau
Stand Oktober 2026 · © Aaron Blankenburg · Lizenz CC BY-NC-SA 4.0 | Seite 17 von 30

## 6.2 Unterteil

prev button
links

front
erst in Schritt 12
Klebekante oben
für den Deckel
next button
rechts

frame

Klebefläche back

back
Einsätze nach unten


Abb. 9 Klebeflächen orange. Die Tasten kleben außen auf der Seitenwand.

### 3 Tasten aufkleben

Sekundenkleber

- prev button auf die linke, next button auf die rechte Seitenwand kleben, von vorn gesehen. Beide sitzen mittig unter der Lasche, die Mitte 31 mm über der Unterkante des Rahmens.
- Das Symbol waagerecht ausrichten. Kleber sparsam auftragen, er darf nicht aus den Aussparungen des Symbols quellen.

### 4 Boden an den Rahmen kleben

Sekundenkleber

- back mit den Einsätzen nach unten an die Unterkante von frame setzen. Die gewölbte Seite gehört nach hinten, zur USB-C-Buchse.
- Auf einer ebenen Fläche verkleben und die Kanten bündig ausrichten. Den Deckel noch nicht aufkleben.
Timon Box · Bauanleitung | Zusammenbau
Stand Oktober 2026 · © Aaron Blankenburg · Lizenz CC BY-NC-SA 4.0 | Seite 18 von 30

## 6.3 Wände

Piezo
Messingseite zur Wand
Lautsprecher
2K-Kleber auf dem Ring
Wand 1 mm
Klebeband

Gitter mit Stoff
Sekundenkleber

USB-C-Platine
UV-Lack


Abb. 10 Rahmen im Schnitt: was innen an den Wänden sitzt.

### 5 Lautsprechergitter mit Stoff beziehen

Sekundenkleber

- Ein Stück dünnen Stoff, etwa eine Socke, straff über die Außenseite des Gitters ziehen.
- Das Gitter von außen in die Öffnung drücken. Der Stoff wird im Spalt zwischen Rand (Ø 54,6 mm) und Öffnung (Ø 55 mm) eingeklemmt.
- Von innen mit Sekundenkleber fixieren und den überstehenden Stoff innen abschneiden.

Tipp: Kleber nur innen auftragen. Sekundenkleber zieht in Stoff ein, wird hart und hinterlässt helle Flecken.

### 6 Lautsprecher einkleben

2K-Kleber

- Die Kabel vorher anlöten, lang genug bis zur Hauptplatine unter dem Deckel.
- Den Lautsprecher von innen mit 2K-Kleber auf das Gitter kleben. Mit 50–57 mm Durchmesser liegt er mit seinem Rand auf dem Ring an der Innenseite des Gitters, ein kleinerer sitzt im Ring direkt am Gitter.
- Kleber nur auf den Rand, nicht auf die Membran. Aushärten lassen.

### 7 Piezos ankleben

Doppelseitiges Klebeband

- Je eine Piezo-Scheibe mit dünnem doppelseitigem Klebeband von innen auf die gedünnte Wand hinter prev button und next button kleben, mittig hinter der Taste, Messingseite zur Wand.
- Die Kabel beschriften: links ist „zurück“ (J2), rechts „vor“ (J3), siehe Kapitel 5.4.

Tipp: Dünnes, festes Klebeband überträgt den Druck besser als dickes Schaumklebeband. Die Schwellen werden in Schritt 12 abgestimmt.

Timon Box · Bauanleitung | Zusammenbau
Stand Oktober 2026 · © Aaron Blankenburg · Lizenz CC BY-NC-SA 4.0 | Seite 19 von 30

### 8 USB-C-Buchse einkleben

UV-Lack

- Die Kabel vorher anlöten: VBUS und GND zum TP4056, D+ und D− zum Kabel zur Hauptplatine (Kapitel 5.4).
- Die Platine von innen in den Ausschnitt unten in der Rückwand setzen, die Buchse bündig mit der Außenseite.
- Ein USB-C-Kabel einstecken, damit die Buchse gerade sitzt. Dann mit UV-Lack von innen fixieren und aushärten. Kein Lack in die Buchse.

## 6.4 Deckel

Poti Ø 7 mm
Mutter von außen

Mikroschalter
Hebel durch den Schlitz
UV-Lack

Kopfhörerbuchse
Tasche 12 × 7 mm
Bohrung bleibt zu

LED Ø 8 mm
UV-Lack

Klebekante
zum Rahmen

RC522 hier aufkleben
Muldenboden 1 mm

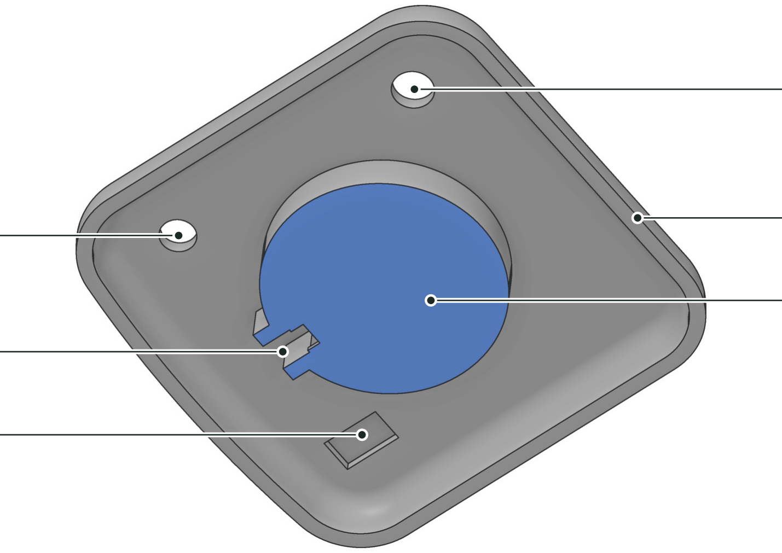
[picture p74: figure]

Abb. 11 front von innen. Blau: Fläche für das RC522.

### 9 Deckel bestücken

UV-Lack Doppelseitiges Klebeband

- LED: Die PL9823 von innen bis zum Kragen in die 8-mm-Bohrung vorn links stecken und mit UV-Lack fixieren.
- Poti: Von innen durch die 7-mm-Bohrung hinten links stecken, außen Scheibe und Mutter. Den Verdrehschutz-Nocken am Poti abbrechen, falls vorhanden; der Deckel hat dafür kein Loch. Die Achse so kürzen, dass sie 8,5 mm über die Deckeloberfläche ragt, dann sitzt der Knopf mit 0,5 mm Luft. Den Knopf volume aufstecken.
- Mikroschalter: In die Tasche an der Rückseite der Token-Mulde setzen, sodass der Hebel durch den Schlitz in die Mulde ragt. Prüfen, dass ein aufgelegter Token ihn hörbar drückt, dann mit UV-Lack fixieren und aushärten. Lack nur ans Gehäuse des Schalters, nicht an Hebel und Stößel.
- RC522: Mit dünnem doppelseitigem Klebeband von innen unter die Token-Mulde kleben, flache Rückseite nach oben, Antenne mittig unter der Mulde. Die Stiftleiste zeigt nach unten, dort steckt später die Hauptplatine.
- Kopfhörerbuchse: Bleibt vorerst leer, die Bohrung hinten rechts bleibt verschlossen. Für eine spätere Buchse ist innen eine Tasche; dann die 0,2-mm-Schicht mit 6 mm aufbohren.
Timon Box · Bauanleitung | Zusammenbau
Stand Oktober 2026 · © Aaron Blankenburg · Lizenz CC BY-NC-SA 4.0 | Seite 20 von 30

Stiftleiste
für die Hauptplatine
Poti
Mutter von außen

Mikroschalter
UV-Lack

LED
UV-Lack

RC522
flache Rückseite an der
Mulde


Abb. 12 Deckel nach Schritt 9. Die Hauptplatine kommt in Schritt 11 auf die Stiftleiste des RC522.

## 6.5 Elektronik und Akkus

AUSSEN INNEN

Ladeanzeige
Filament außen bündig

USB-C

Rückwand, 3 mm

2K-Kleber
hält auch, wenn es warm wird

TP4056 auf der Power Latch Modulseite zur Wand

Lade-LED

Filament 1,75 mm
darf gebogen verlaufen

Abb. 13 Schnitt durch die Rückwand an der USB-C-Buchse: Das Filament führt das Licht der Lade-LED nach außen und darf gebogen verlaufen.

### 10 Ladeschaltung und Step-up einkleben

2K-Kleber

- Die Ladeschaltung, also die Power Latch mit dem TP4056-Modul auf der Rückseite, mit 2K-Kleber innen an die Wand kleben, in die Nähe der USB-C-Buchse. Heißkleber reicht hier nicht: Der Laderegler wird beim Laden sehr warm, und der Heißkleber kann sich dann lösen.
- Schnell härtenden 2K-Kleber nehmen und die Platine halten, bis er anzieht. Kein Kleber auf die Lade-LED.
- Ein Stück transparentes Filament (1,75 mm) von außen durch das 2-mm-Loch über der USB-C-Buchse stecken und innen bis an die Lade-LED führen. Es darf länger sein und in einem sanften Bogen verlaufen, so ist man bei der Lage der Ladeschaltung frei. Außen bündig abschneiden. Hält es nicht von selbst, mit einem Tropfen UV-Lack sichern.
- Den Step-up-Konverter ebenfalls mit 2K-Kleber an eine freie Stelle der Wandinnenseite kleben, nicht auf die gedünnten Tastenflächen. Auch er wird unter Last warm.

Tipp: Beim Laden leuchtet das Filament neben der USB-C-Buchse in der Farbe der LED: je nach Modul rot beim Laden, blau oder grün, wenn der Akku voll ist.

Timon Box · Bauanleitung | Zusammenbau
Stand Oktober 2026 · © Aaron Blankenburg · Lizenz CC BY-NC-SA 4.0 | Seite 21 von 30

Plus, rot
zu B+ am TP4056
Kapton über der
Lötstelle

Tastenwand
kein Kleber

18650 vorn links
stehend, Pluspol oben

Step-up
2K-Kleber

Ladeschaltung
2K-Kleber

USB-C

18650 hinten rechts
diagonal gegenüber

Minus, schwarz
zu B− am TP4056


Abb. 14 Akkus stehend in zwei diagonal gegenüberliegenden Ecken, hier vorn links und hinten rechts. An der Rückwand Ladeschaltung und Step-up. Rahmen aufgeschnitten, Deckel noch nicht aufgeklebt.

### 11 Elektronik verdrahten und Akkus einkleben

Elektronik aus Kapitel 5 Heißkleber

- Die Hauptplatine von unten auf die Stiftleiste des RC522 stecken und am freien Ende den Abstandshalter einclipsen (Kapitel 5.2, Schritt E6).
- Zur Sicherheit einen Kabelbinder um Hauptplatine, Abstandshalter und RC522 legen, am Ende gegenüber der Stiftleiste. Dort ist zwischen RC522 und Deckel Platz, denn die Token-Mulde trägt das RC522 nur in der Mitte.
- Alles nach den Tabellen in Kapitel 5.4 verdrahten: Kabel zu J4, Lautsprecher an den MAX98357A, Piezos an J2 und J3, Poti an J1, LED an J5, Mikroschalter mit C an Trigger + und NO an Trigger In der Latch.
- Die beiden 18650-Zellen stehend in zwei diagonal gegenüberliegende Ecken setzen, Pluspol oben, zum Beispiel vorn links und hinten rechts. Hinten links sitzt direkt darüber das Poti.
- Die Zellen stehen auf dem Boden direkt über den Gewindeeinsätzen und reichen bis knapp unter den Deckel. Einfache Zellen ohne Schutzschaltung (65 mm) passen, die Schutzschaltung sitzt auf dem TP4056-Modul.
- Mit Heißkleber in den Spalten zwischen Zelle und Ecke fixieren. Kein Kleber auf die gedünnten Wandflächen der Tasten, er dämpft sonst die Piezos.
- Parallel schalten, Plus an Plus und Minus an Minus, und an B+ und B− des TP4056 anschließen. Alle Lötstellen mit Kapton-Band oder Schrumpfschlauch isolieren.

Achtung: Vor dem Zusammenschalten beide Zellen auf gleiche Spannung bringen (höchstens etwa 0,1 V Unterschied), sonst fließt ein hoher Ausgleichsstrom. Nur gleiche Zellen verwenden, Zellen mit Lötfahnen nehmen und nicht direkt an die Zelle löten. Nichts Blankes darf Schrauben, Einsätze oder andere Bauteile berühren.

Timon Box · Bauanleitung | Zusammenbau
Stand Oktober 2026 · © Aaron Blankenburg · Lizenz CC BY-NC-SA 4.0 | Seite 22 von 30

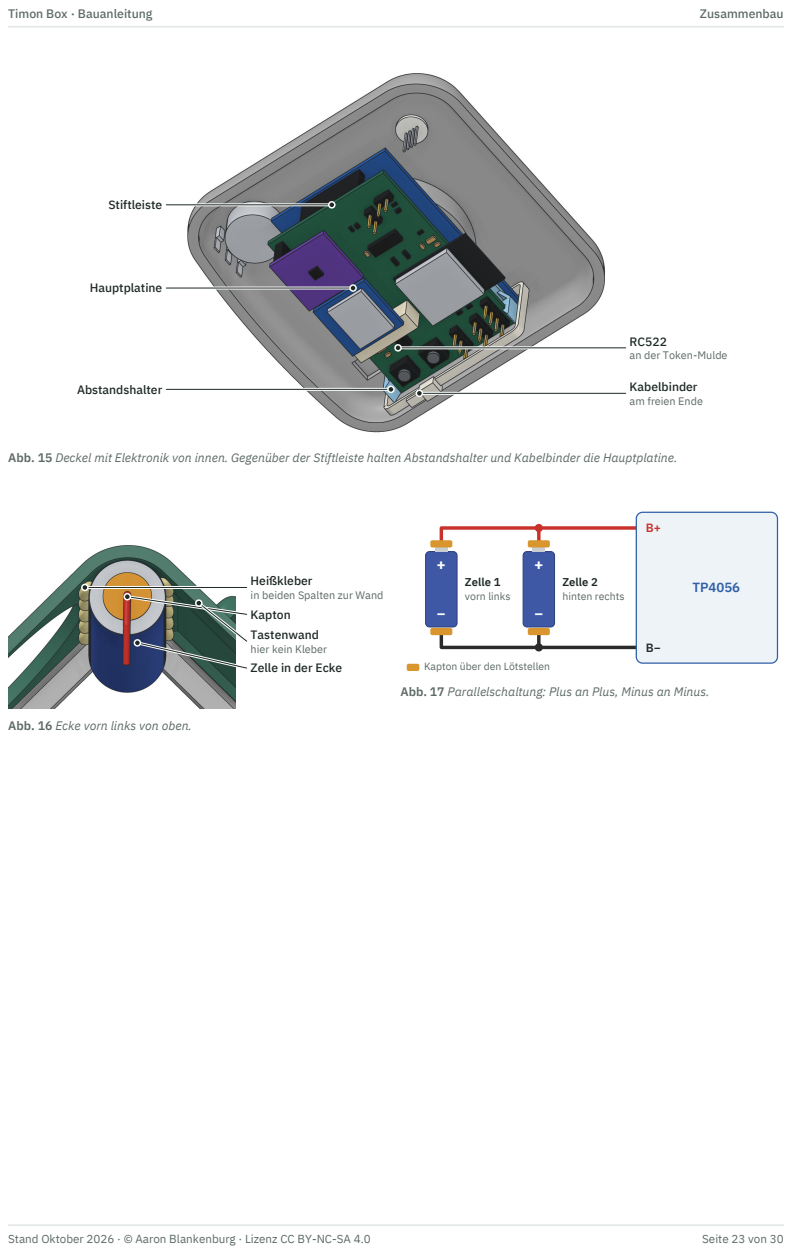
[picture p75: page 23]
Stiftleiste; Hauptplatine; Abstandshalter; Zelle 1 vorn links; Zelle 2 hinten rechts; Timon Box · Bauanleitung; Zusammenbau; Stand Oktober 2026 · © Aaron Blankenburg · Lizenz CC BY-NC-SA 4.0; Seite 23 von 30

an der Token-Mulde

Kabelbinder
am freien Ende

Abb. 15 Deckel mit Elektronik von innen. Gegenüber der Stiftleiste halten Abstandshalter und Kabelbinder die Hauptplatine.

Heißkleber
in beiden Spalten zur Wand
Kapton
Tastenwand
hier kein Kleber
Zelle in der Ecke

Kapton über den Lötstellen

Abb. 17 Parallelschaltung: Plus an Plus, Minus an Minus.

Abb. 16 Ecke vorn links von oben.

## 6.6 Abschluss

Verstärker und SD-Modul
RC522
unter der Token-Mulde

Step-up

Hauptplatine
steckt auf dem RC522

7-poliges Kabel
nach innen legen

Ladeschaltung

Akkus


Abb. 18 Vor dem Aufkleben: Der Deckel trägt RC522, Hauptplatine mit Modulen, LED, Poti und Mikroschalter. Das 7-polige Kabel verbindet ihn mit der Stromseite.

### 12 Testen, dann Deckel aufkleben

Sekundenkleber

- Vor dem Verkleben in Betrieb nehmen, wie in Kapitel 5.5 beschrieben: Token auflegen, Box startet, flashen, Lautstärke, LED und Akkuanzeige prüfen.
- Die Klopfsensoren mit knockdebug:1 und knockdebug:2 abstimmen (doc/development.md). Die Schwellen stehen pro Box in der platformio.ini, eine neue Box bekommt dort eine eigene Env.
- Die Kabel nach innen legen, auf der Klebekante darf nichts liegen. Den Deckel mit Sekundenkleber auf den Rahmen kleben, die gewölbte Seite nach hinten. Danach die Klopfsensoren kurz gegenprüfen.
Timon Box · Bauanleitung | Zusammenbau
Stand Oktober 2026 · © Aaron Blankenburg · Lizenz CC BY-NC-SA 4.0 | Seite 24 von 30

4 × M3 × 5
ISO 4762
bumper (TPU)
Klebefläche zur Klappe

back
mit Einschmelzgewinden

door
Bodenklappe


Abb. 19 Bodenklappe mit Bumper und Schrauben. Orange: Klebefläche.

### 13 Bodenklappe anschrauben

Sekundenkleber

- Den Bumper mit Sekundenkleber unter die Klappe kleben. Zum Ausrichten zwei Schrauben durch Bumper und Klappe stecken.
- Die Klappe mit vier Schrauben M3 × 5 anschrauben. Die Köpfe versinken im Bumper. Durch die Klappe kommt man wieder an die Elektronik.

Achtung: Keine längeren Schrauben als M3 × 5 verwenden. In zwei Ecken steht direkt über dem Einsatz ein Akku.

Timon Box · Bauanleitung | Zusammenbau
Stand Oktober 2026 · © Aaron Blankenburg · Lizenz CC BY-NC-SA 4.0 | Seite 25 von 30

Ende umgeschlagen
und vernäht
Lasche
Öffnung 20 × 3 mm

Rolladengurt
ca. 15 mm breit, ca. 30 cm


Abb. 20 Zum Tragen: ein Stück Rolladengurt durch beide Laschen.

### 14 Tragegurt anbringen

Nadel und Faden

- Etwa 30 cm Rolladengurt aus dem Baumarkt nehmen, ca. 15 mm breit.
- Je ein Ende durch eine Lasche führen, umschlagen und festnähen, zum Beispiel mit einem Kästchen mit Kreuz.
- Dann lässt sich die Box am Gurt tragen.

Tipp: Die Schnittkanten kurz mit dem Feuerzeug anschmelzen, dann franst der Gurt nicht aus.

Timon Box · Bauanleitung | Zusammenbau
Stand Oktober 2026 · © Aaron Blankenburg · Lizenz CC BY-NC-SA 4.0 | Seite 26 von 30

# 7 Maße und Schnittstellen

Alle Werte aus dem STEP-Modell, in Millimetern. Pfade beziehen sich auf das Repo github.com/aaronblankenburg/timon-box.

Stelle | Maß
Außen | 94 × 90 mm, mit Laschen 102 mm breit; Höhe mit Bumper hinten 94,5 mm, vorn 87 mm
Deckel | 5° nach vorn geneigt, 3 mm Deckplatte, 8 mm Rand
Wände | 3 mm, an den Tasten auf einer Fläche von 56 × 50 mm auf 1 mm gedünnt
Laschen | Öffnung 20 × 3 mm, für Gurte bis knapp 20 mm Breite
Token-Mulde | Ø 40 mm, 10 mm tief, Boden 1 mm
Token | Körper Ø 39,7 mm, Rand Ø 44 mm, 15 mm hoch; NFC-Tasche Ø 26 × 0,4 mm, 0,2 mm über der
Unterseite
LED | Bohrung Ø 8 mm
Poti und Knopf | Bohrung Ø 7 mm; Knopf Ø 14 × 9 mm, Achsloch Ø 6,2 mm (8 mm tief ab Unterkante), Aussparung Ø 12
× 3 mm
Kopfhörerbuchse | Bohrung Ø 6 mm, oben mit 0,2 mm verschlossen; Tasche 12 × 7 × 2 mm
USB-C | Ausschnitt 9,2 × 3,5 mm, Ecken R 1,5; Mitte 5 mm darüber ein Loch Ø 2 mm für den Lichtleiter
Lautsprecher | Öffnung Ø 55 mm; Gitter mit Rand Ø 54,6 mm, Auflagering Ø 48,6–54,6 mm, steht 3 mm vor
Tasten | Ø 20 × 1 mm, Mitte 31 mm über der Unterkante des Rahmens
Gewindeeinsätze | 4 Bohrungen Ø 4,0 mm, 4,5 mm tief, durchgehend
Klappe | 2,9 mm dick, Senkung Ø 5,6 × 2 mm, Durchgang Ø 3,1 mm
Bumper | 2 mm, TPU
Abstandshalter | 44,2 × 16,8 × 10 mm; zwischen den Armen 41,2 mm breit, Rastnasen auf 39,9 mm
Platinenstapel | etwa 11 mm zwischen Hauptplatine und RC522: Buchsenleiste 8,5 mm und Kunststoff der Stiftleiste
2,5 mm

## Dateien

Pfad | Inhalt
models/box.step | CAD-Modell, alle zehn Teile in Einbaulage
models/pcb_spacer.step | Abstandshalter zwischen Hauptplatine und RC522
models/plates/ | Fertige Druckbetten als 3MF, eins pro Farbe, und ein Bambu-Studio-Projekt mit allen
models/stl/ | Jedes Druckteil als STL, in Druckausrichtung
hardware/ | KiCad-Projekte, Schaltpläne und Gerber der Platinen, Verdrahtung der Stromseite
(WireViz)
doc/hardware.md | Elektronik: Teileliste, Platinen, Verkabelung, Inbetriebnahme
README.md | Überblick und Schnellstart
doc/usage.md | Bedienung
doc/development.md | Klopfsensoren abstimmen, Entwicklung
tools/token-sheet.html | Token-Bilder als Fotoabzug 10 × 15 cm
doc/assembly/ | Quellen dieser Anleitung: Text, Bilder aus dem Modell, Build-Skript
Timon Box · Bauanleitung | Maße und Schnittstellen
Stand Oktober 2026 · © Aaron Blankenburg · Lizenz CC BY-NC-SA 4.0 | Seite 27 von 30

# 8 Anhang

## Schaltplan Hauptplatine

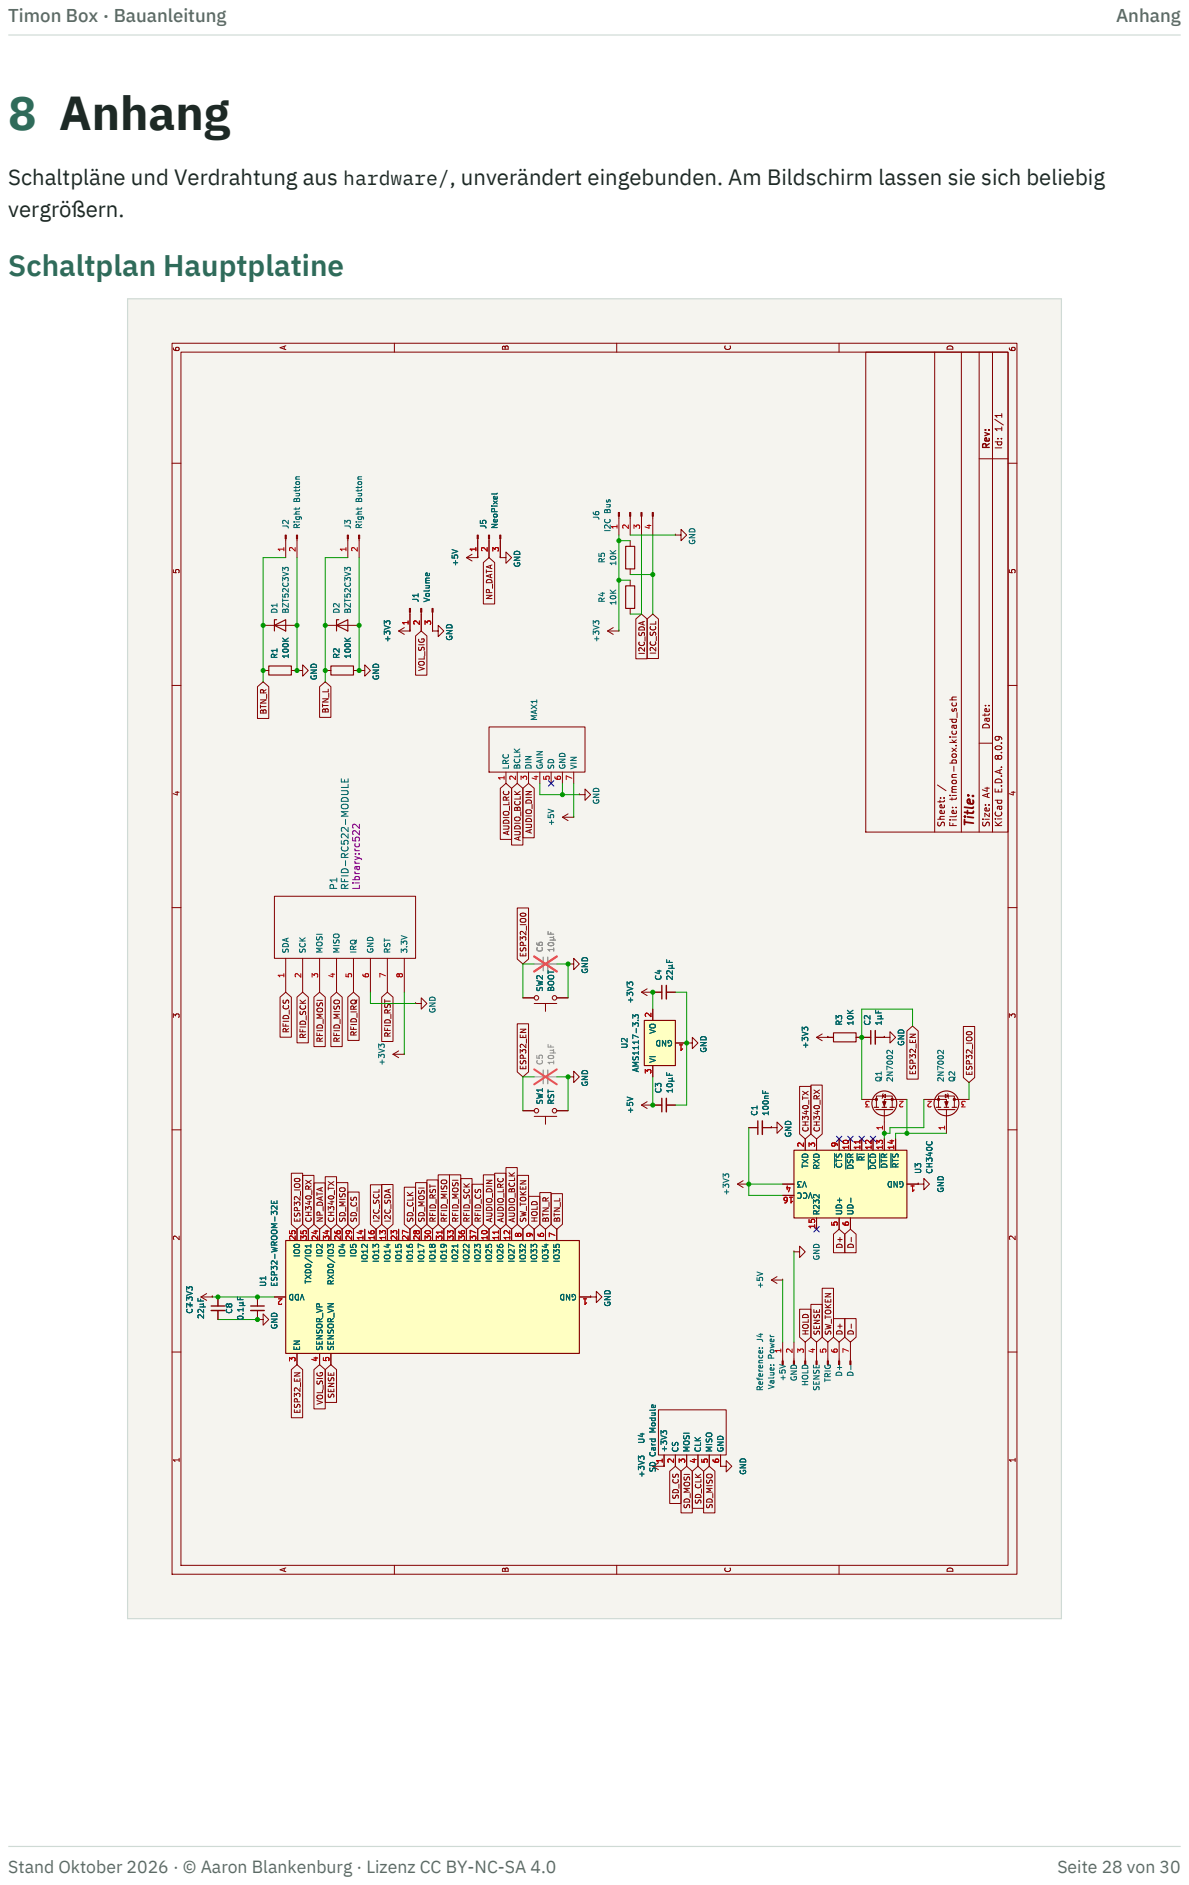
[picture p76: page 28]

Schaltpläne und Verdrahtung aus hardware/, unverändert eingebunden. Am Bildschirm lassen sie sich beliebig
vergrößern.

D Date: KiCad E.D.A. 8.0.9 Rev: Size: A4

J3Right Button D1BZT52C3V3 +3V3 +5V 1 GND 2 HOLD 3 SENSE 4 TRIG 5 D+ 6 D- 7 Reference: J4 Value: Power

SD_MOSI U4 SD Card Module +3V3 1 CS 2 MOSI 3 CLK 4 MISO 5 GND 6 +3V3 GND GND

LRC 1 BCLK 2 DIN 3 GAIN 4 SD 5 GND 6 VIN 7 MAX1 GND

SDA 1 SCK 2 MOSI 3 MISO 4

+3V3 1 CS 2 MOSI 3 CLK 4 MISO 5 GND 6 U4 SD Card Module GND GND

## Schaltplan Power Latch V2

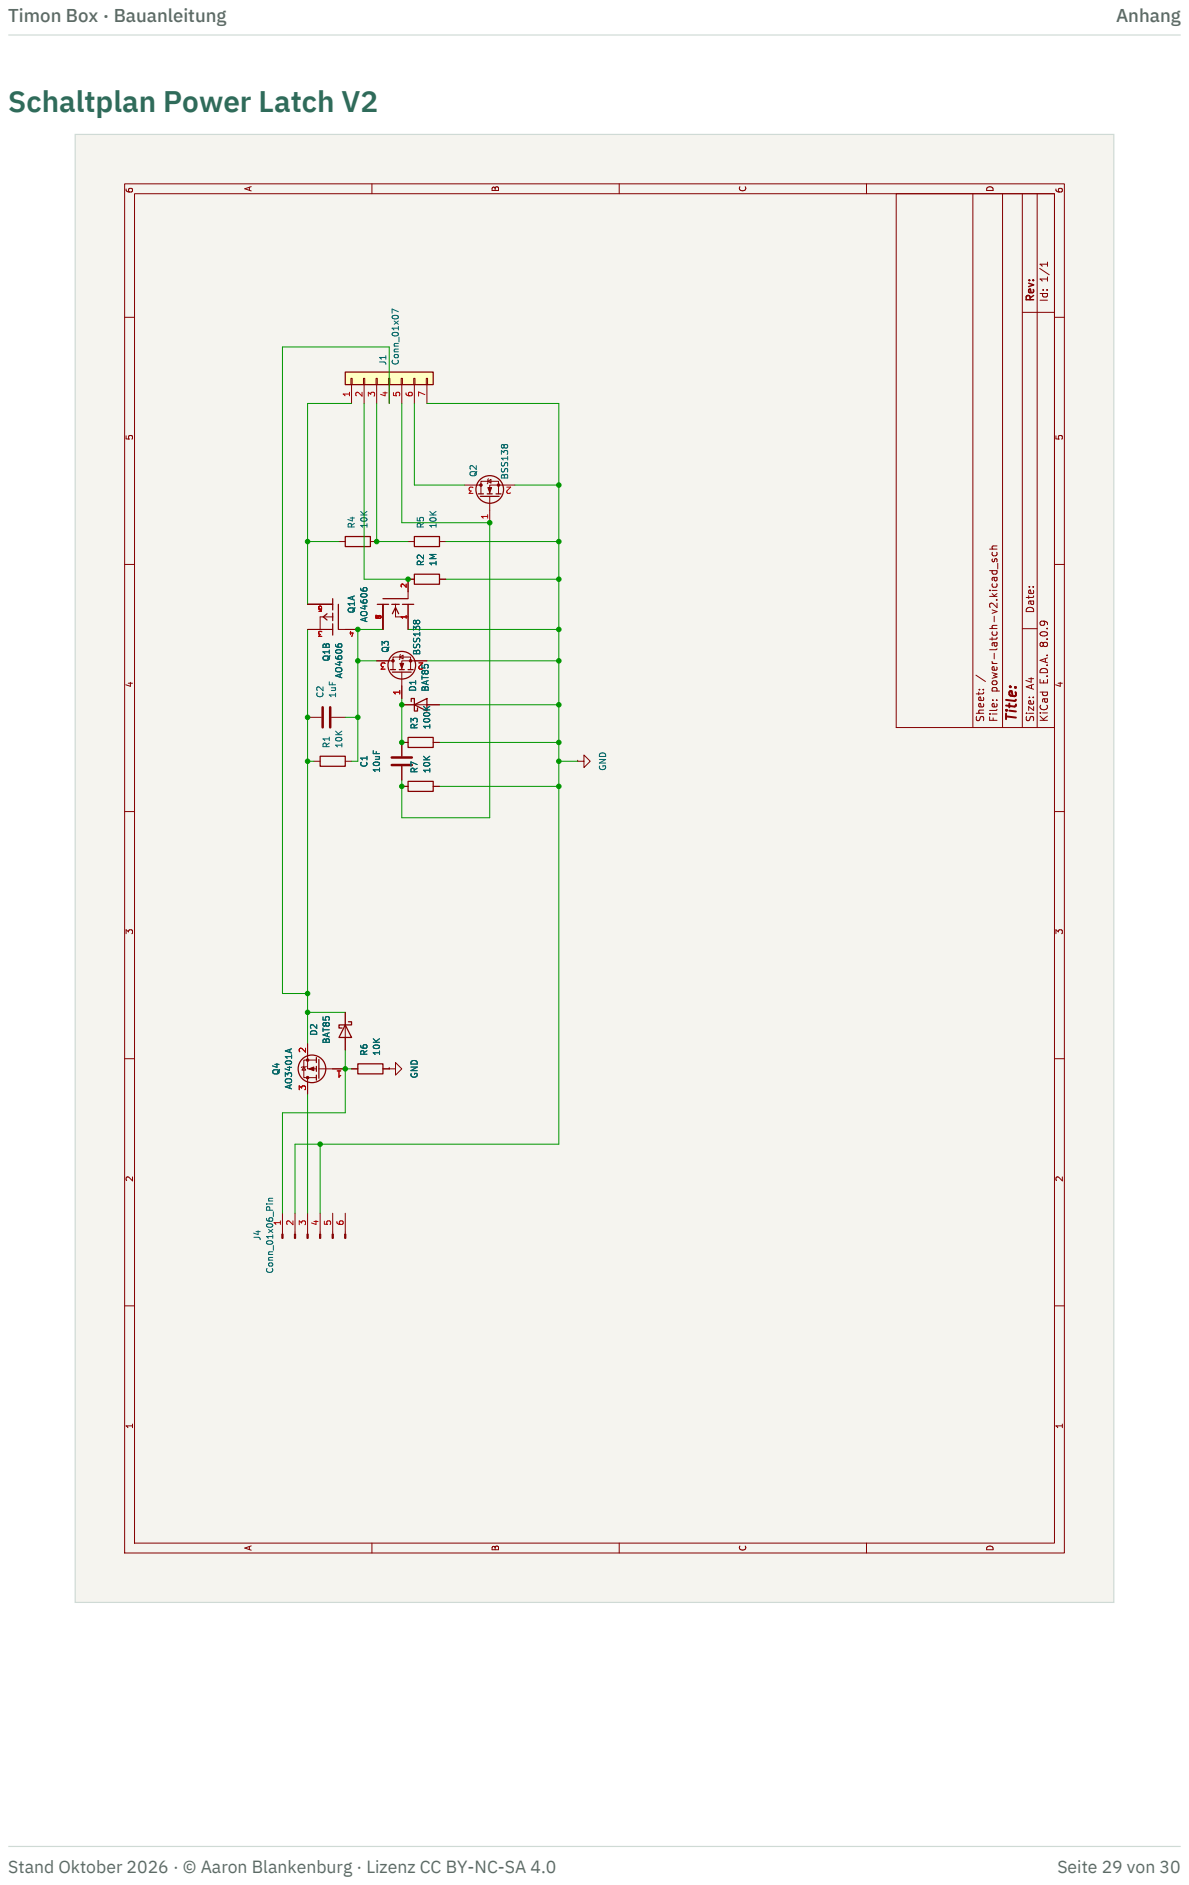
[picture p77: page 29]

D Date: KiCad E.D.A. 8.0.9 Rev: Size: A4

power-latch-v2.kicad_sch Sheet: / GND

## Verdrahtung der Stromseite

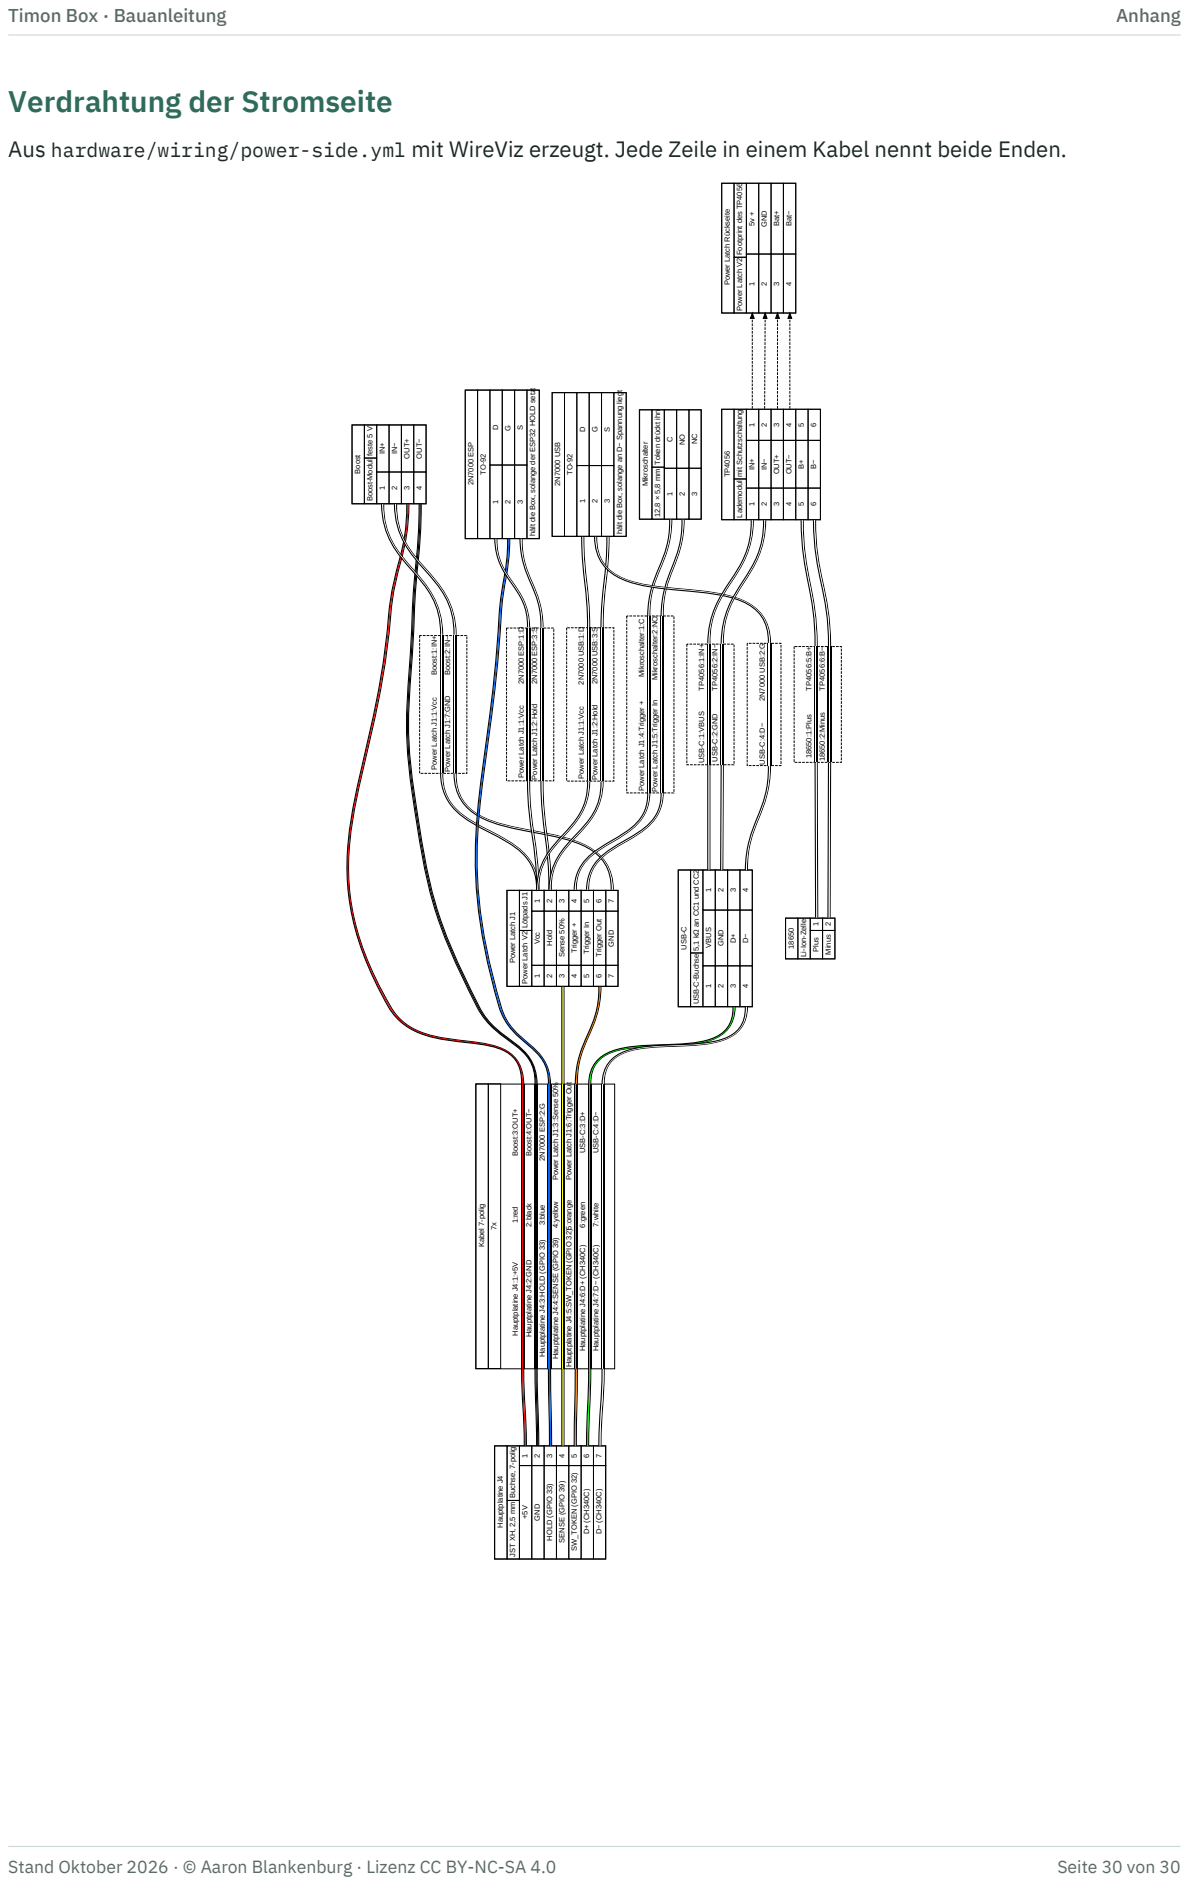
[picture p78: page 30]
Aus hardware/wiring/power-side.yml mit WireViz erzeugt. Jede Zeile in einem Kabel nennt beide Enden. Hauptplatine J4; JST XH, 2,5 mm Buchse, 7⁻polig; GND ²; HOLD ⁽GPIO ³³⁾ ³; SENSE ⁽GPIO ³⁹⁾ ⁴; SW_TOKEN ⁽GPIO ³²⁾ ⁵; D⁺ ⁽CH³⁴⁰C⁾ ⁶; D⁻ ⁽CH³⁴⁰C⁾ ⁷ Kabel 7⁻polig; Hauptplatine J4:1:+5V ¹:red Boost:3:OUT+; Hauptplatine J4:2:GND ²:black Boost:4:OUT−; Hauptplatine J4:3:HOLD ⁽GPIO ³³⁾ ³:blue 2N⁷⁰⁰⁰ ESP:2:G; Hauptplatine J4:4:SENSE ⁽GPIO ³⁹⁾ ⁴:yellow Power Latch J1:3:Sense 50%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

Power Latch V2 Footprint des TP4056

Power Latch Rückseite

hält die Box, solange der ESP32 HOLD setzt

hält die Box, solange an D− Spannung liegt

12,8 × 5,8 mm Token drückt ihn

Lademodul mit Schutzschaltung

Power Latch J1:1:Vcc 2N7000 ESP:1:D

Power Latch J1:2:Hold 2N7000 ESP:3:S

Power Latch J1:1:Vcc 2N7000 USB:1:D

Power Latch J1:2:Hold 2N7000 USB:3:S

Power Latch J1:4:Trigger + Mikroschalter:1:C

Power Latch J1:5:Trigger In Mikroschalter:2:NO

Power Latch J1:1:Vcc Boost:1:IN+

Power Latch J1:7:GND Boost:2:IN−

USB-C:1:VBUS TP4056:1:IN+

USB-C:2:GND TP4056:2:IN−

USB-C-Buchse 5,1 kΩ an CC1 und CC2

Power Latch V2 Lötpads J1

Li-Ion-Zelle
