aaronblankenburg/timon-box/doc/assembly/fig/akku_detail.jpg

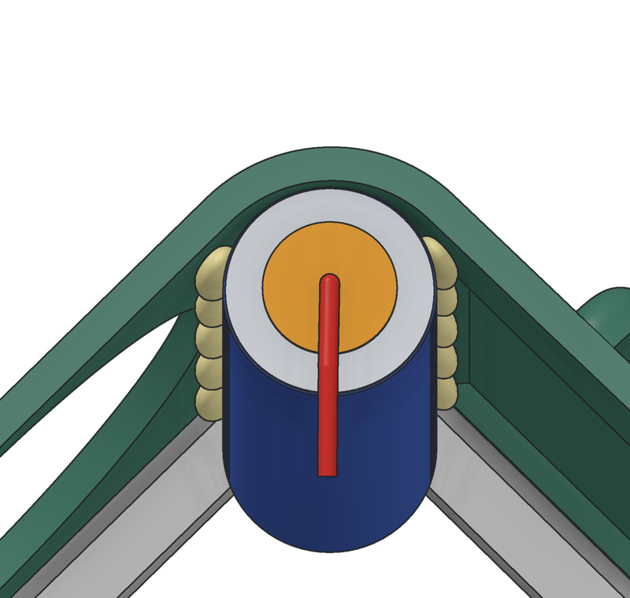
doc/assembly/fig/akku_detail.jpg
