aaronblankenburg/timon-box/doc/assembly/fig/door.jpg

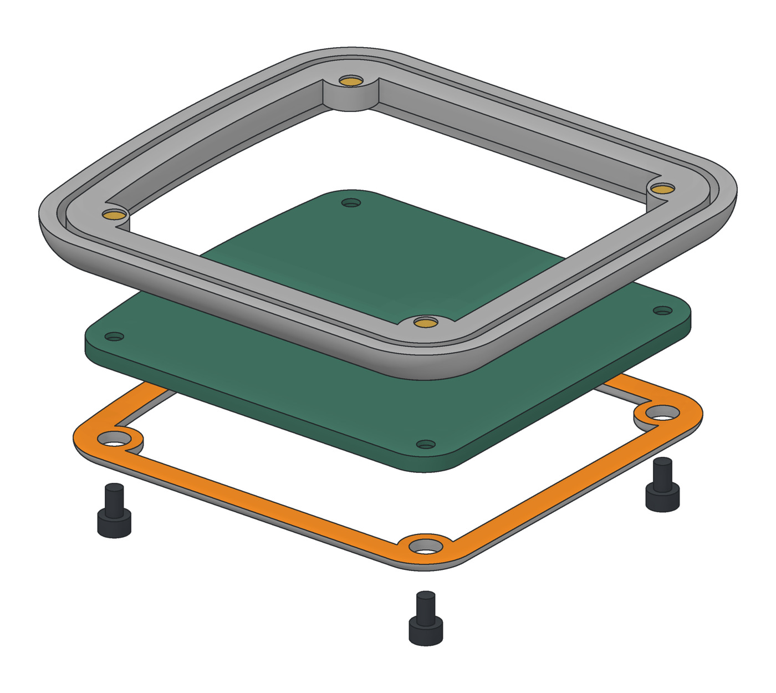
doc/assembly/fig/door.jpg
