aaronblankenburg/timon-box/doc/assembly/fig/hero.png

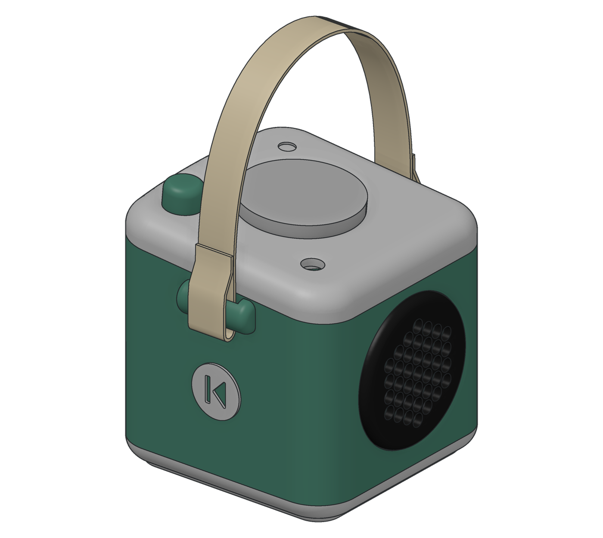
doc/assembly/fig/hero.png
