aaronblankenburg/timon-box/doc/assembly/fig/inside.jpg

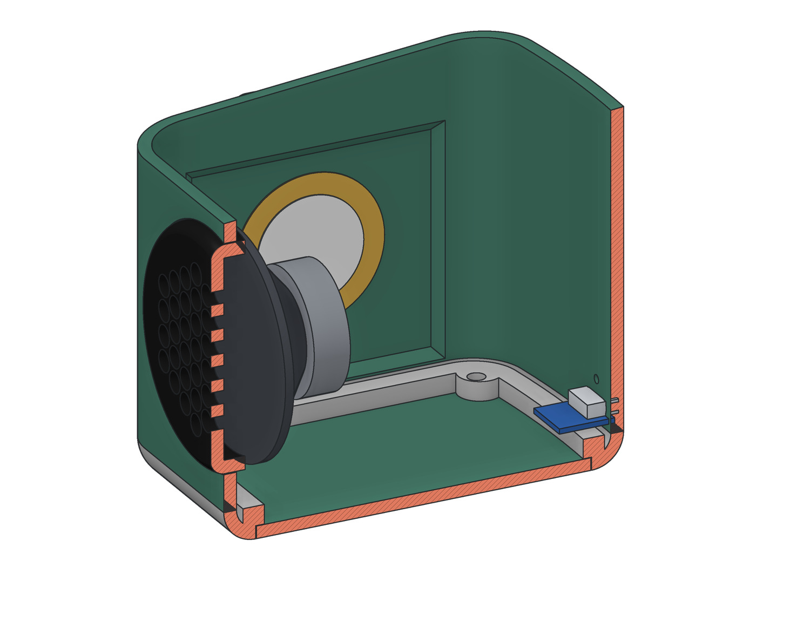
doc/assembly/fig/inside.jpg
