aaronblankenburg/timon-box/doc/assembly/fig/lid_stack.jpg

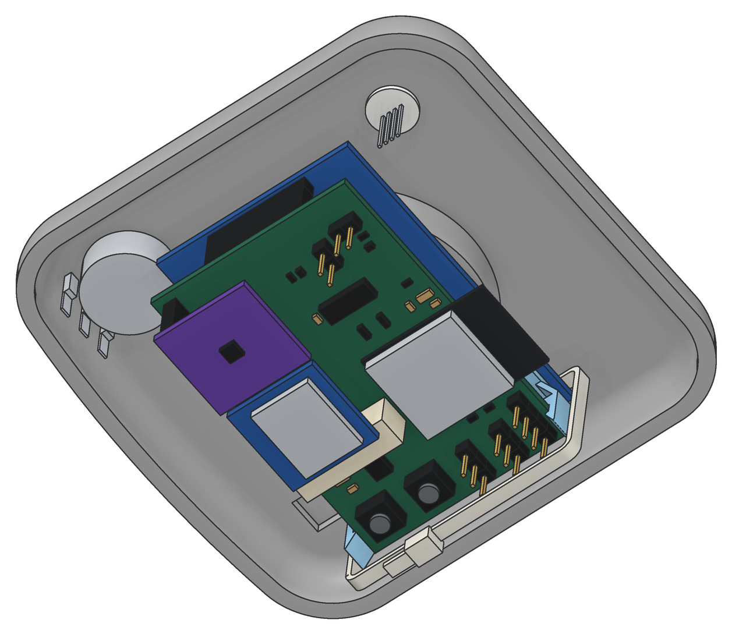
doc/assembly/fig/lid_stack.jpg
