aaronblankenburg/timon-box/doc/assembly/fig/shell.jpg

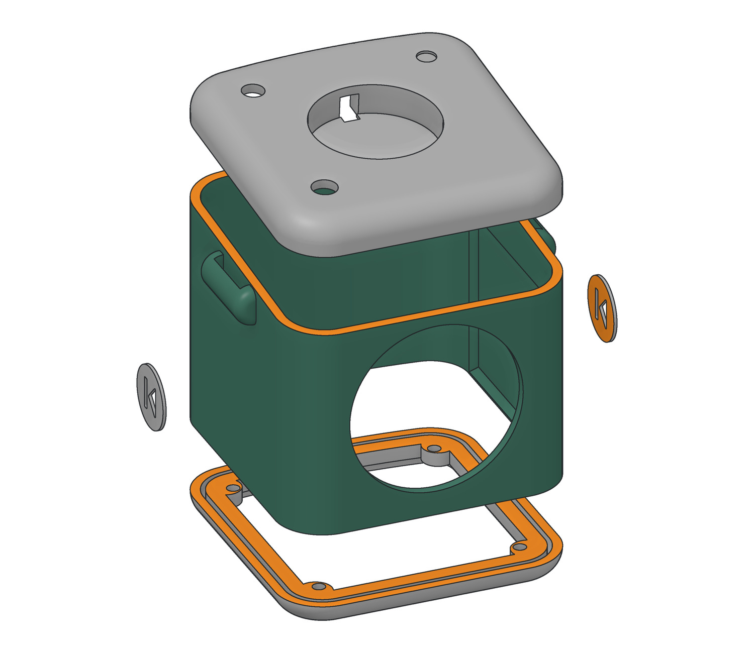
doc/assembly/fig/shell.jpg
