aaronblankenburg/timon-box/doc/assembly/fig/spacer_stack.jpg

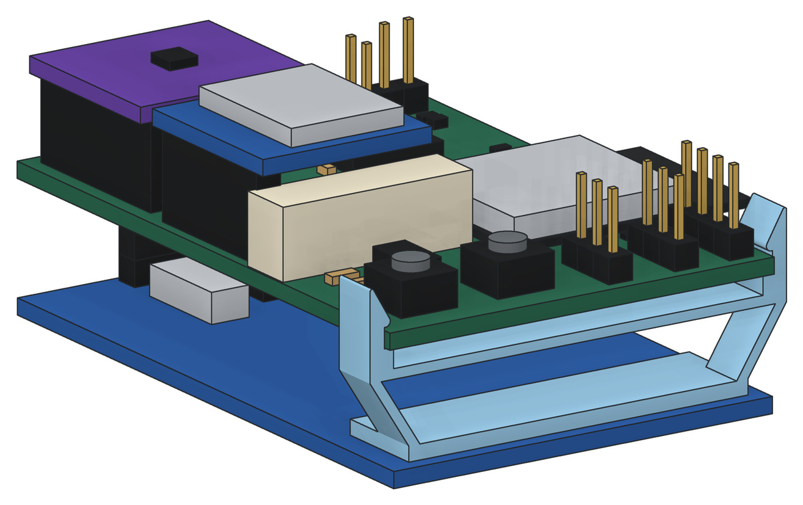
doc/assembly/fig/spacer_stack.jpg
