aaronblankenburg/timon-box/doc/assembly/fig/thingiverse/01_cover.jpg

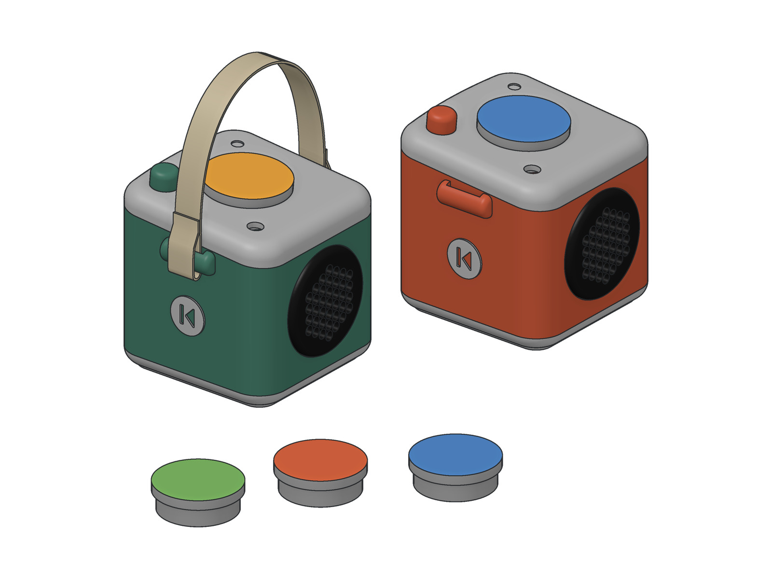
doc/assembly/fig/thingiverse/01_cover.jpg
