aaronblankenburg/timon-box/doc/assembly/fig/thingiverse/02_back.jpg

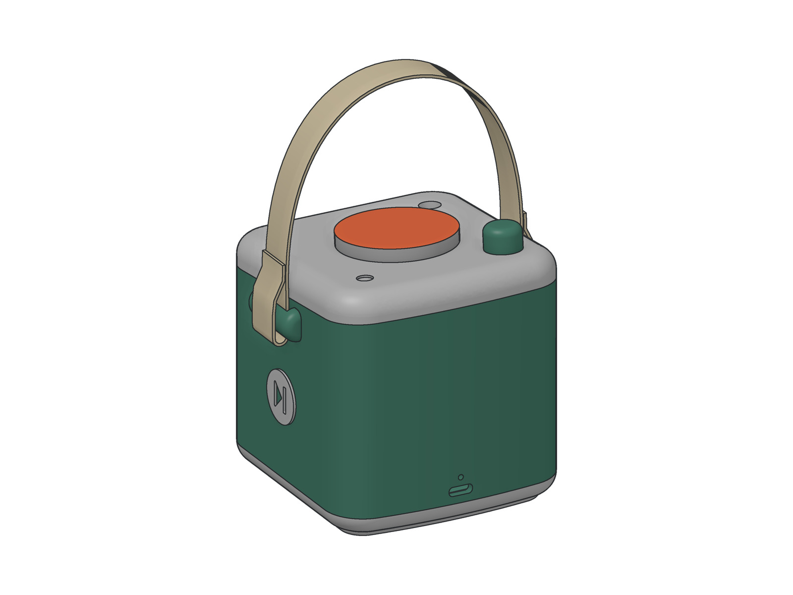
doc/assembly/fig/thingiverse/02_back.jpg
