aaronblankenburg/timon-box/doc/assembly/fig/thingiverse/03_exploded.jpg

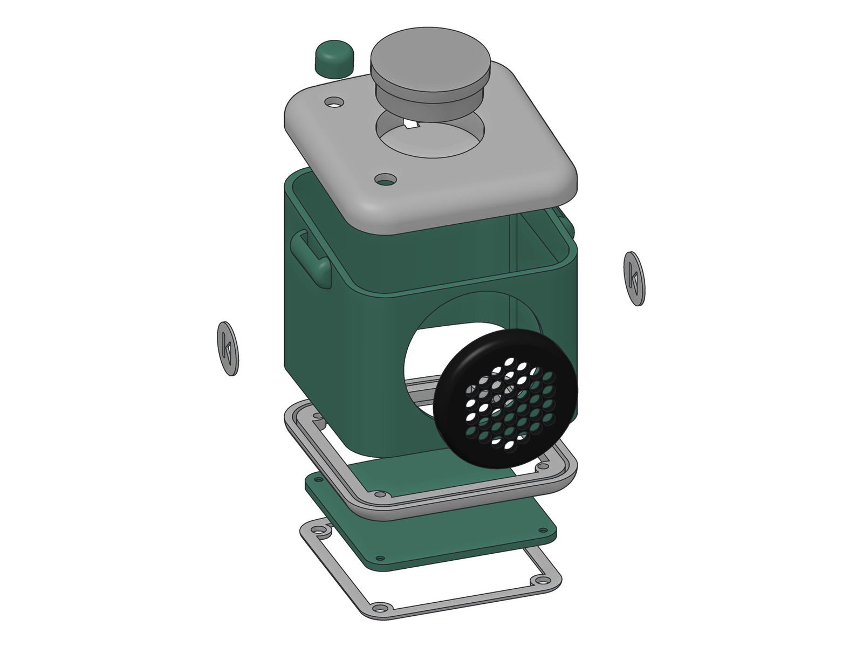
doc/assembly/fig/thingiverse/03_exploded.jpg
