aaronblankenburg/timon-box/doc/assembly/fig/thingiverse/04_plates.jpg

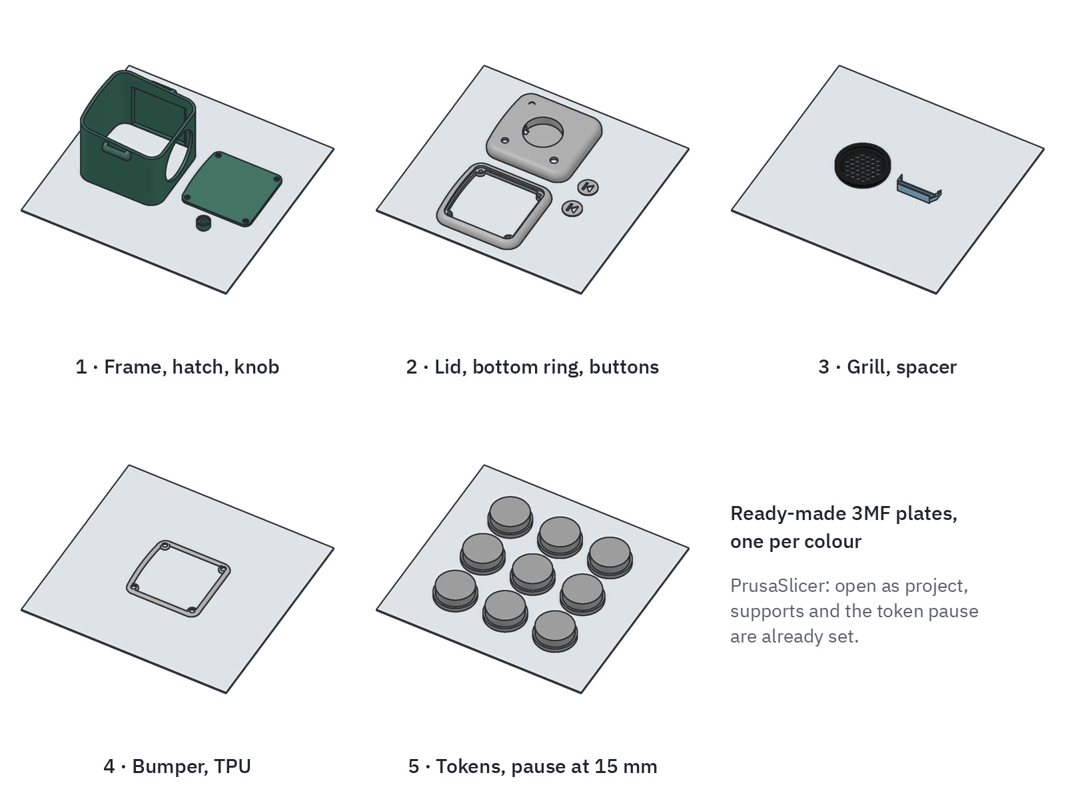
doc/assembly/fig/thingiverse/04_plates.jpg
