aaronblankenburg/timon-box/doc/assembly/fig/thingiverse/05_inside.jpg

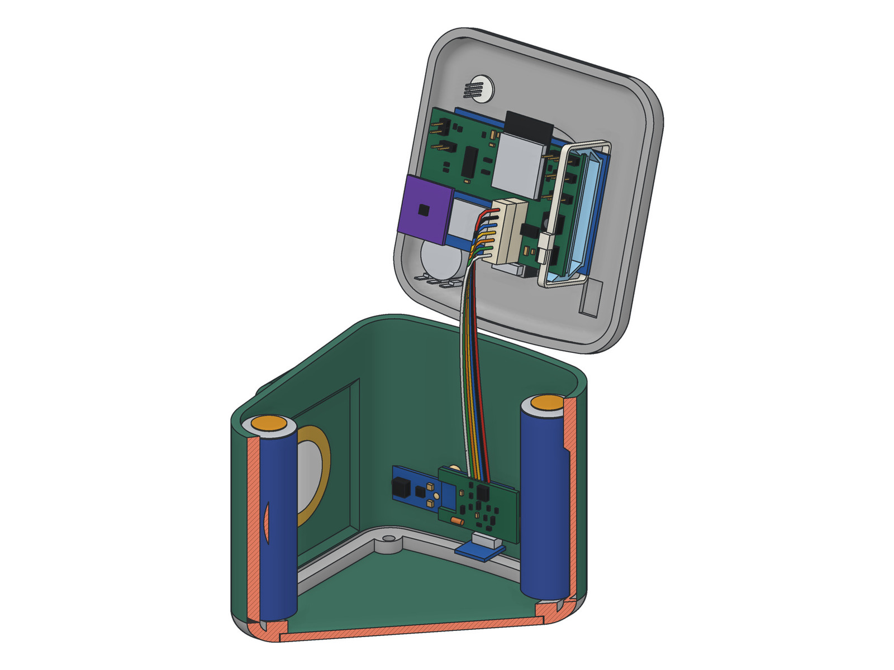
doc/assembly/fig/thingiverse/05_inside.jpg
