aaronblankenburg/timon-box/doc/assembly/fig/thingiverse/06_token.jpg

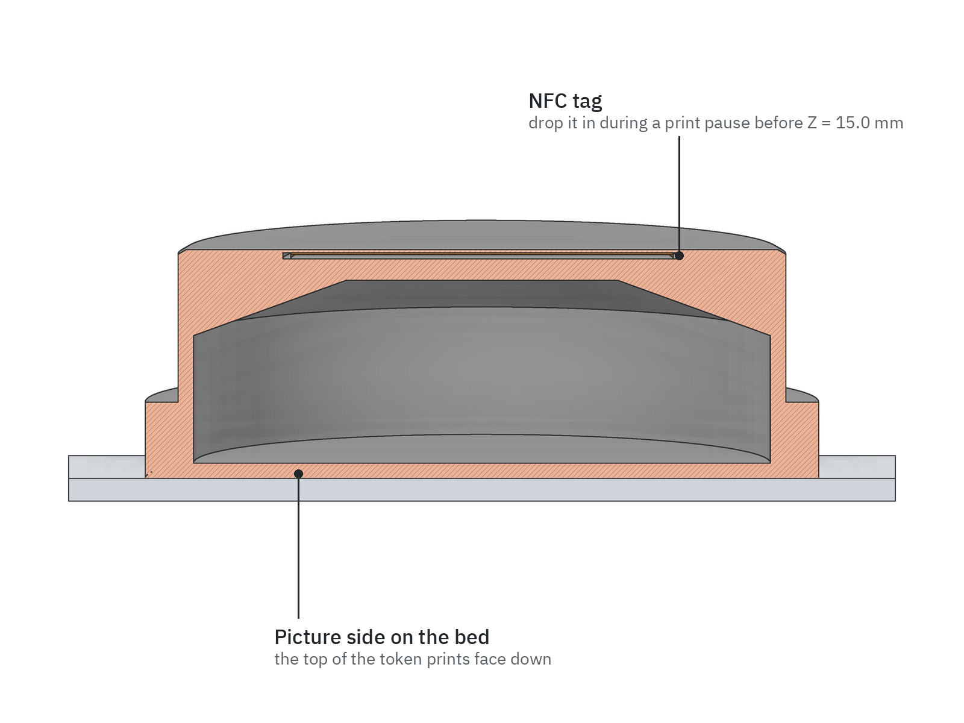
doc/assembly/fig/thingiverse/06_token.jpg
