aaronblankenburg/timon-box/doc/assembly/fig/tile_back.jpg

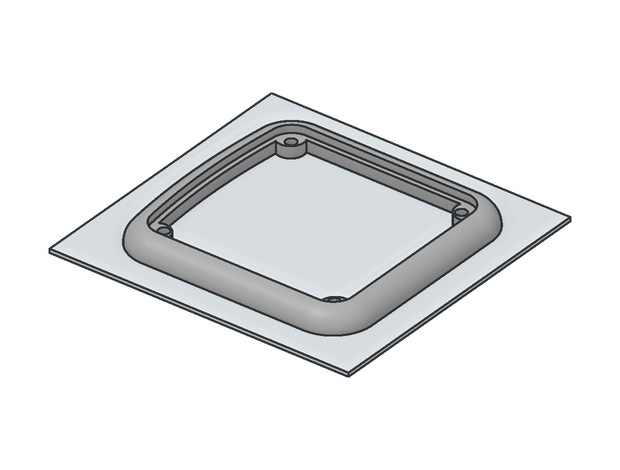
doc/assembly/fig/tile_back.jpg
