aaronblankenburg/timon-box/doc/assembly/fig/tile_door.jpg

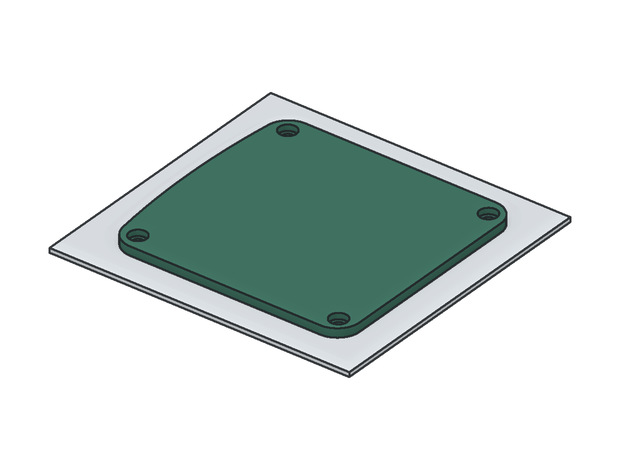
doc/assembly/fig/tile_door.jpg
