aaronblankenburg/timon-box/doc/assembly/fig/tile_frame.jpg

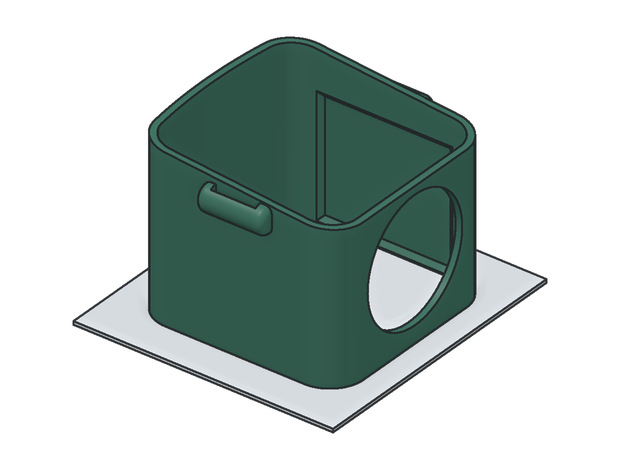
doc/assembly/fig/tile_frame.jpg
