aaronblankenburg/timon-box/doc/assembly/fig/tile_front.jpg

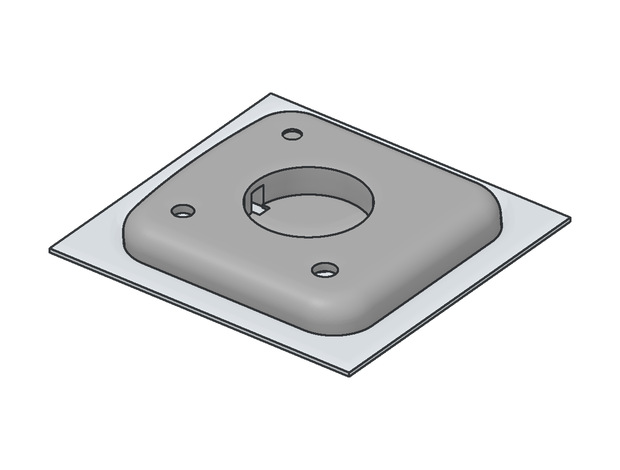
doc/assembly/fig/tile_front.jpg
