aaronblankenburg/timon-box/doc/assembly/fig/tile_next_button.jpg

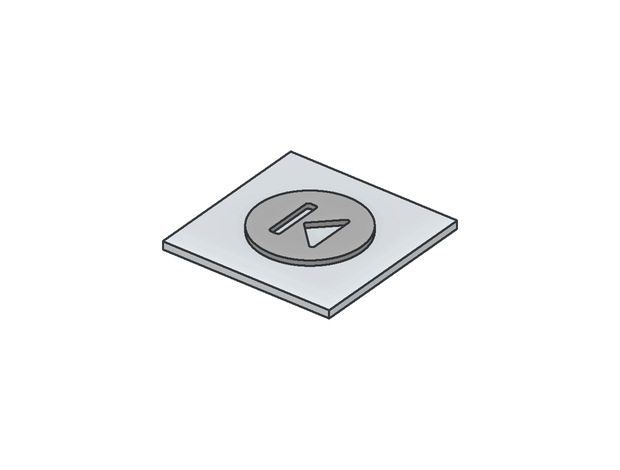
doc/assembly/fig/tile_next_button.jpg
