aaronblankenburg/timon-box/doc/assembly/fig/tile_pcb_spacer.jpg

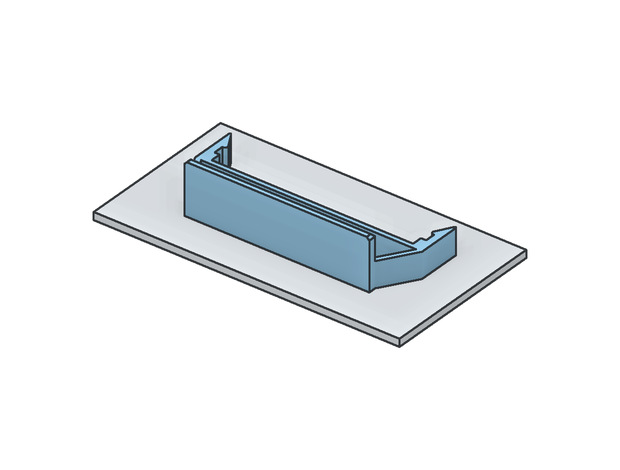
doc/assembly/fig/tile_pcb_spacer.jpg
