aaronblankenburg/timon-box/doc/assembly/fig/tile_token.jpg

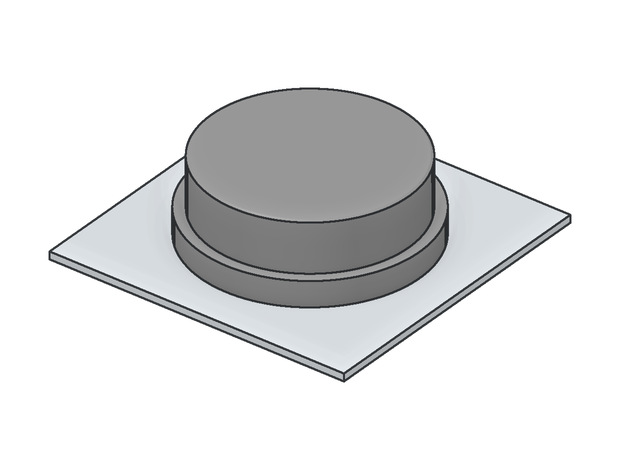
doc/assembly/fig/tile_token.jpg
