aaronblankenburg/timon-box/doc/assembly/fig/token_section.jpg

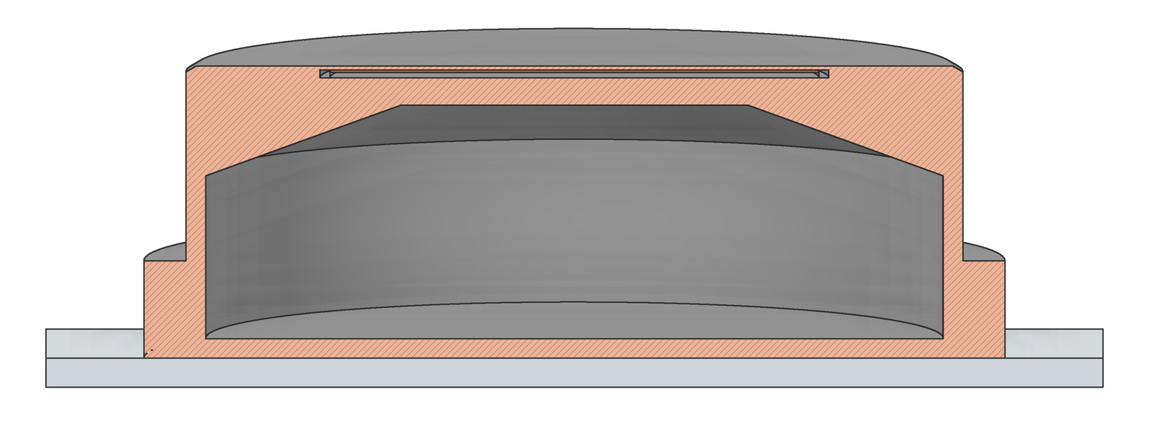
doc/assembly/fig/token_section.jpg
