aaronblankenburg/timon-box/hardware/mainboard/timon-box-schematic.pdf

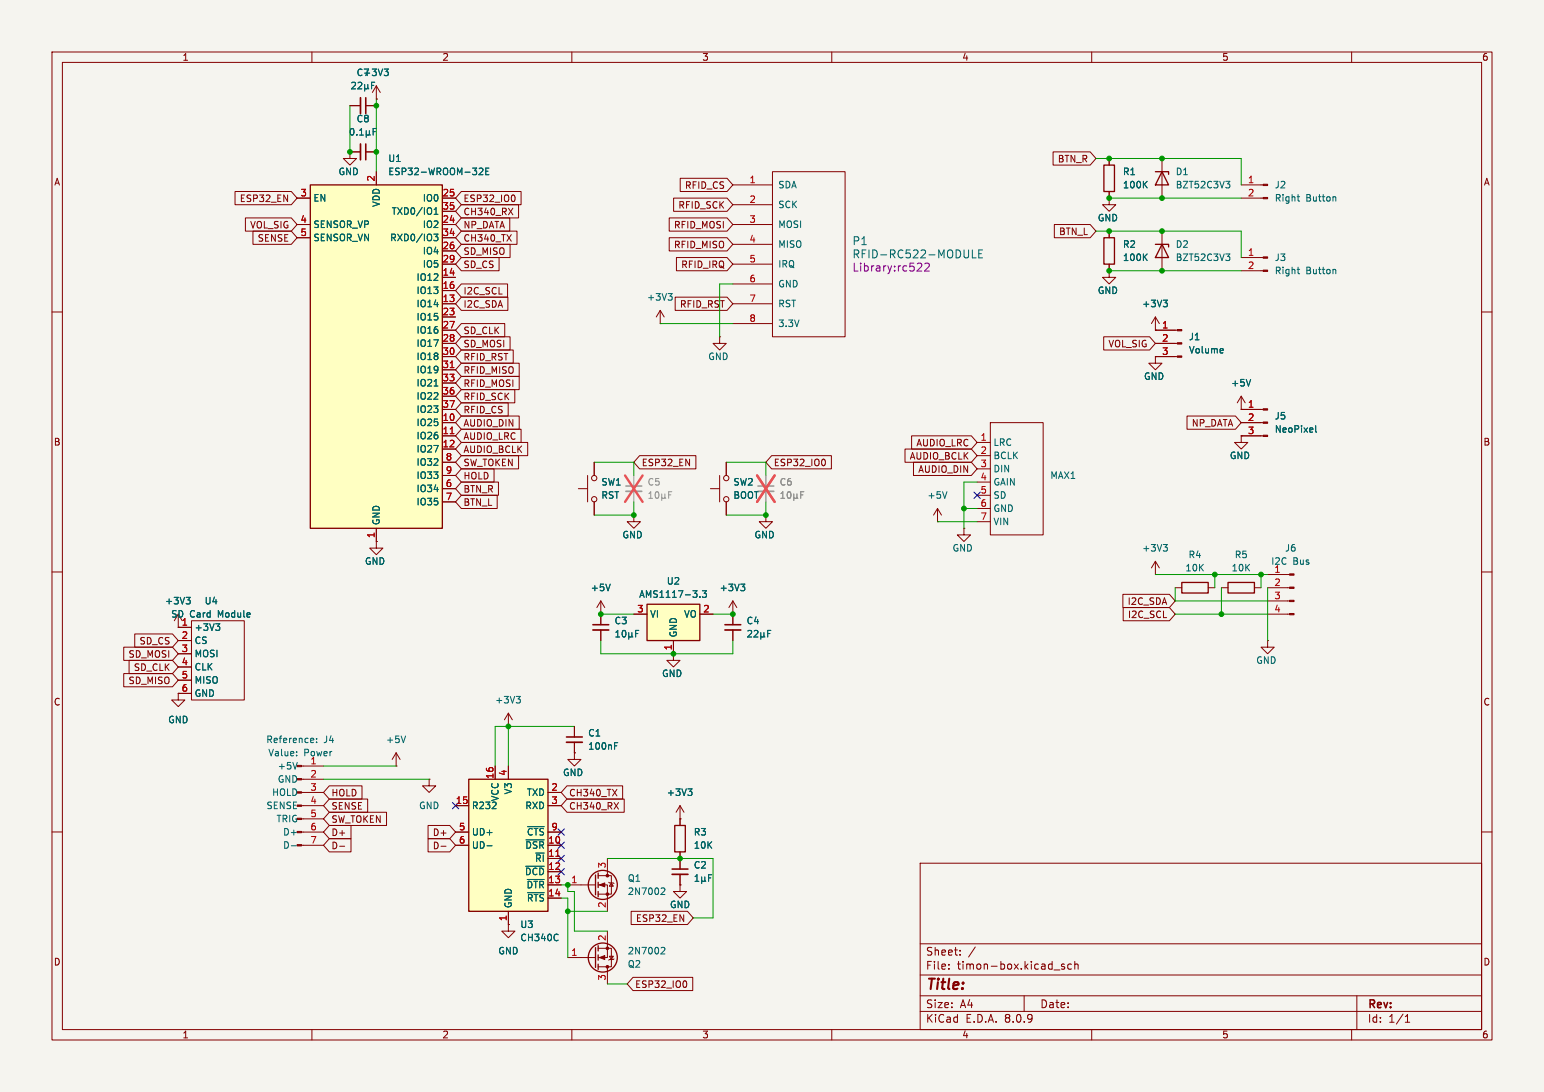
[picture p100: page 1]

4 UD+ 5 UD- 6 ~{CTS}9 GND GND

1 ~{DSR} 10 ~{RI} 11 ~{DCD} 12 ~{DTR} 13 ~{RTS} 14 R232 15 VCC 16 TXD 2 RXD 3 V3

Id: 1/1 Title: File: timon-box.kicad_sch Sheet: / R3
