aaronblankenburg/timon-box/hardware/power-latch/power-latch-v2-schematic.pdf

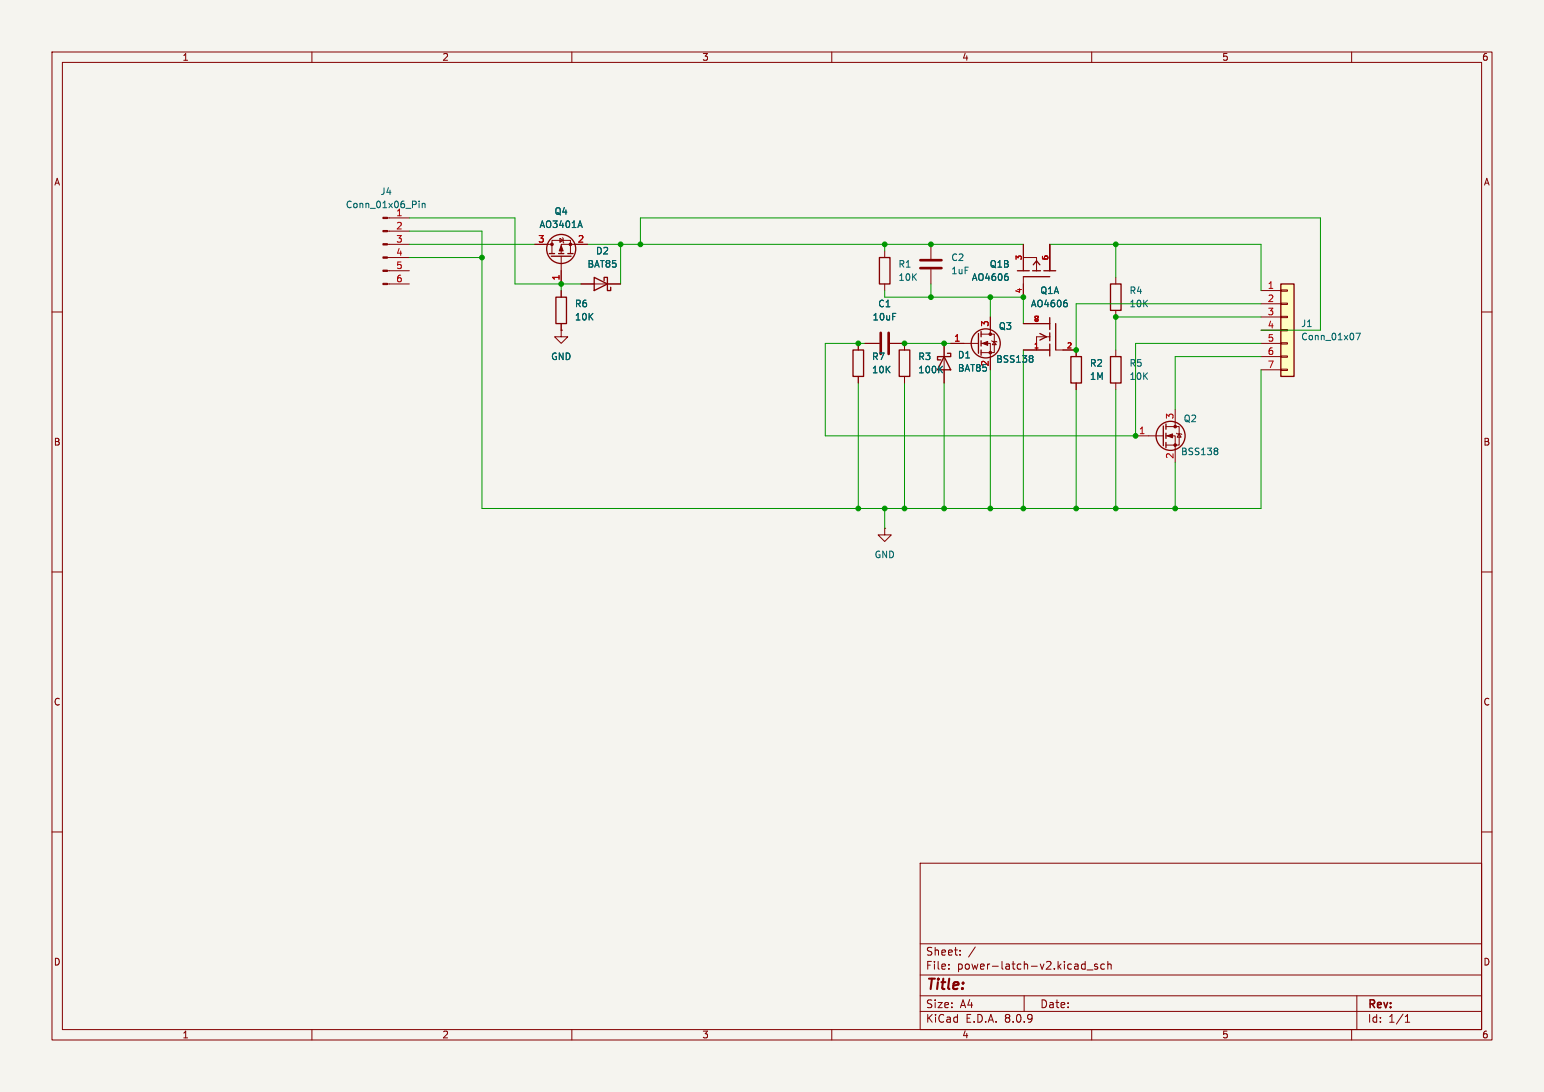
[picture p101: page 1]

Id: 1/1 Title: File: power-latch-v2.kicad_sch Sheet: / GND
