aaronblankenburg/timon-box/hardware/power-latch/power-latch-v2.kicad_pcb

## KiCad design hardware/power-latch/power-latch-v2.kicad_pcb (2026-10-25)

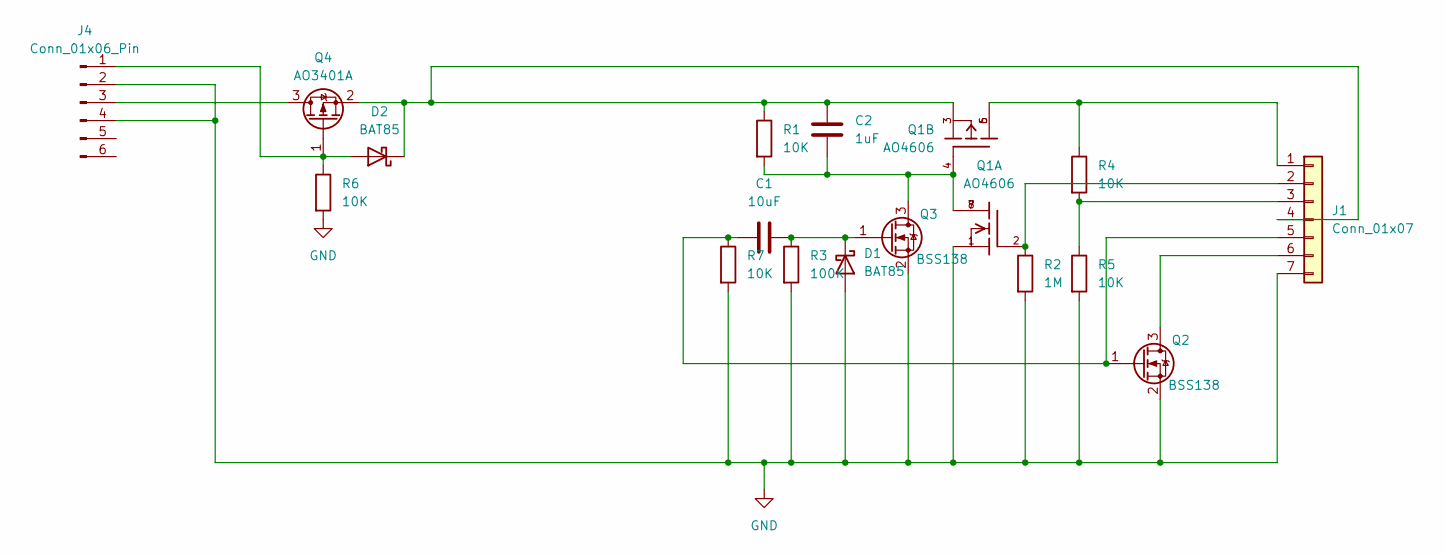
[picture p102: schematic power-latch-v2.kicad_sch]

Parts:
C1: 10uF; C_0805_2012Metric_Pad1.18x1.45mm_HandSolder
C2: 1uF; C_0805_2012Metric_Pad1.18x1.45mm_HandSolder
D1: BAT85; D_SOD-323_HandSoldering
D2: BAT85; D_DO-35_SOD27_P7.62mm_Horizontal
J1: Conn_01x07; PinHeader_1x07_P2.54mm_Vertical
J4: Conn_01x06_Pin; TP4056-18650
Q1: AO4606; SOIC-8_3.9x4.9mm_P1.27mm
Q2, Q3: BSS138; SOT-23
Q4: AO3401A; SOT-23
R1, R4, R5, R6, R7: 10K; R_0805_2012Metric_Pad1.20x1.40mm_HandSolder
R2: 1M; R_0805_2012Metric_Pad1.20x1.40mm_HandSolder
R3: 100K; R_0805_2012Metric_Pad1.20x1.40mm_HandSolder

Connections:
GND: D1.2 (A), J1.7, J4.2, J4.4, Q1.1, Q2.2 (S), Q3.2 (S), R2.2, R3.2, R5.2, R6.2, R7.2
unnamed: C1.2, D1.1 (K), Q3.1 (G), R3.1
unnamed: D2.2 (A), J4.1, Q4.1 (G), R6.1
unnamed: C2.2, D2.1 (K), J1.4, Q1.3, Q4.2 (S), R1.1
unnamed: J1.1, Q1.5, Q1.6, R4.1
unnamed: J1.2, Q1.2, R2.1
unnamed: J1.3, R4.2, R5.1
unnamed: C1.1, J1.5, Q2.1 (G), R7.1
unnamed: J1.6, Q2.3 (D)
unnamed: J4.3, Q4.3 (D)
unnamed: C2.1, Q1.4, Q1.7, Q1.8, Q3.3 (D), R1.2

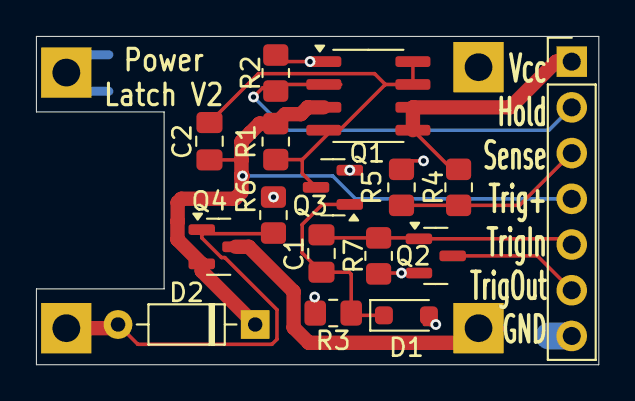
[picture p103: board power-latch-v2.kicad_pcb from above]

Board: 2 copper layers, 31.2 x 18.2 mm, 17 parts (1 on the bottom side), 11 nets.
