aaronblankenburg/timon-box/hardware/mainboard/timon-box.kicad_pcb

## KiCad design hardware/mainboard/timon-box.kicad_pcb (2026-10-25)

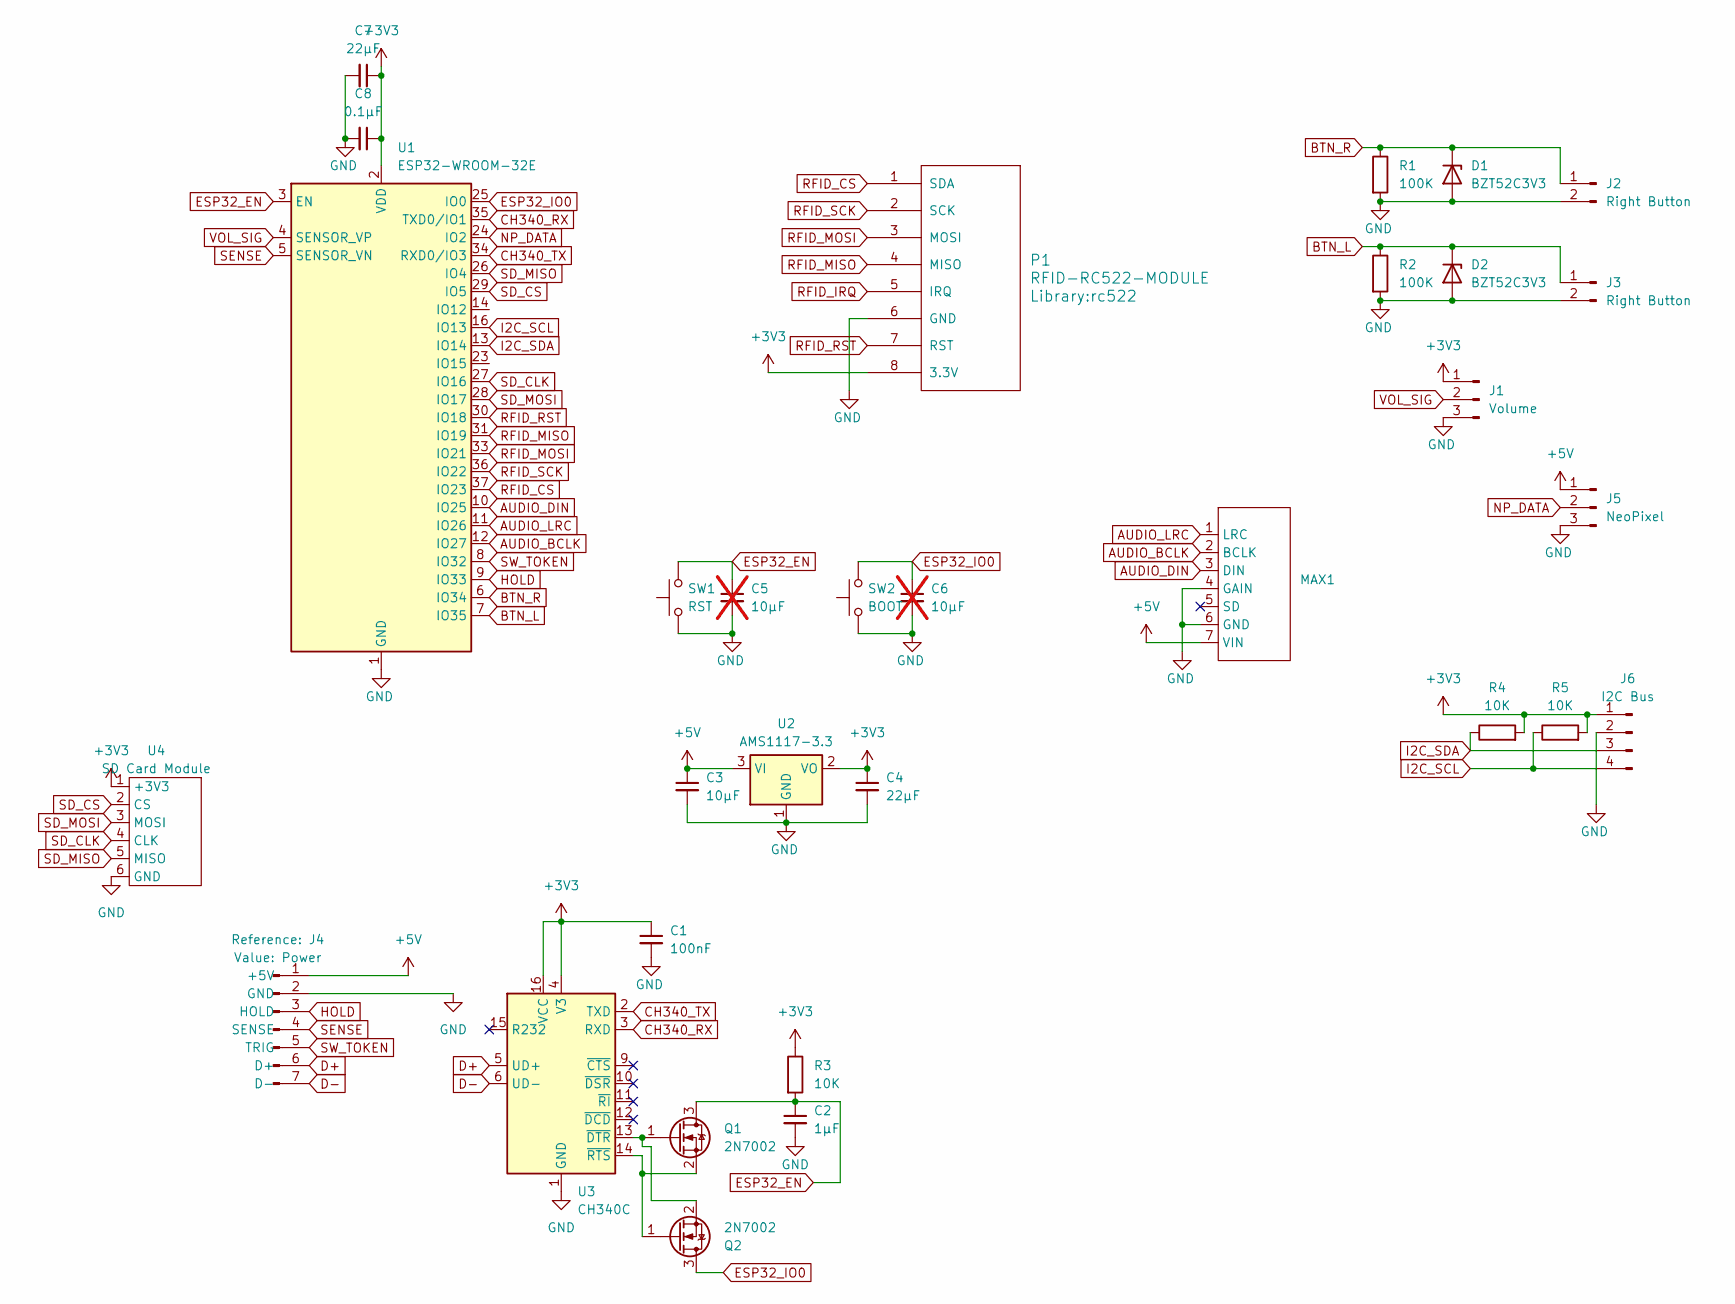
[picture p104: schematic timon-box.kicad_sch]

Parts:
C1: 100nF; C_0805_2012Metric
C2: 1µF; C_0805_2012Metric
C3: 10µF; C_0805_2012Metric
C4, C7: 22µF; C_1206_3216Metric
C5, C6: 10µF; C_0805_2012Metric; not fitted
C8: 0.1µF; C_0805_2012Metric
D1, D2: BZT52C3V3; D_SOD-323_HandSoldering
J1: Volume; PinHeader_1x03_P2.54mm_Vertical
J2, J3: Right Button; PinHeader_1x02_P2.54mm_Vertical
J4: Power; PinHeader_1x07_P2.54mm_Vertical
J5: NeoPixel; PinHeader_1x03_P2.54mm_Vertical
J6: I2C Bus; PinHeader_1x04_P2.54mm_Vertical
MAX1: max98357
P1: RFID-RC522-MODULE; rc522
Q1, Q2: 2N7002; SOT-23
R1, R2: 100K; R_0805_2012Metric
R3, R4, R5: 10K; R_0805_2012Metric
SW1: RST; SW_SPST_PTS645
SW2: BOOT; SW_SPST_PTS645
U1: ESP32-WROOM-32E; ESP32-WROOM-32D
U2: AMS1117-3.3; SOT-223-3_TabPin2
U3: CH340C; SOIC-16_3.9x9.9mm_P1.27mm
U4: SD Card Module; sdcard-module

Connections:
+3V3: C1.1, C4.1, C7.1, C8.1, J1.1, J6.1, P1.8 (3.3V), R3.1, R4.2, R5.2, U1.2 (VDD), U2.2 (VO), U3.4 (V3), U3.16 (VCC), U4.1 (+3V3)
+5V: C3.1, J4.1 (+5V), J5.1, MAX1.7 (VIN), U2.3 (VI)
AUDIO_BCLK: MAX1.2 (BCLK), U1.12 (IO27)
AUDIO_DIN: MAX1.3 (DIN), U1.10 (IO25)
AUDIO_LRC: MAX1.1 (LRC), U1.11 (IO26)
BTN_L: D2.1 (K), J3.1, R2.1, U1.7 (IO35)
BTN_R: D1.1 (K), J2.1, R1.1, U1.6 (IO34)
CH340_RX: U1.35 (TXD0/IO1), U3.3 (RXD)
CH340_TX: U1.34 (RXD0/IO3), U3.2 (TXD)
D+: J4.6 (D+), U3.5 (UD+)
D-: J4.7 (D-), U3.6 (UD-)
ESP32_EN: C2.1, C5.1, Q1.3 (D), R3.2, SW1.2, U1.3 (EN)
ESP32_IO0: C6.1, Q2.3 (D), SW2.2, U1.25 (IO0)
GND: C1.2, C2.2, C3.2, C4.2, C5.2, C6.2, C7.2, C8.2, D1.2 (A), D2.2 (A), J1.3, J2.2, J3.2, J4.2 (GND), J5.3, J6.2, MAX1.4 (GAIN), MAX1.6 (GND), P1.6 (GND), R1.2, R2.2, SW1.1, SW2.1, U1.1 (GND), U1.15 (GND), U1.38 (GND), U1.39 (GND), U2.1 (GND), U3.1 (GND), U4.6 (GND)
HOLD: J4.3 (HOLD), U1.9 (IO33)
I2C_SCL: J6.4, R5.1, U1.16 (IO13)
I2C_SDA: J6.3, R4.1, U1.13 (IO14)
NP_DATA: J5.2, U1.24 (IO2)
unnamed: Q1.1 (G), Q2.2 (S), U3.13 (~DTR)
unnamed: Q1.2 (S), Q2.1 (G), U3.14 (~RTS)
RFID_CS: P1.1 (SDA), U1.37 (IO23)
RFID_IRQ: P1.5 (IRQ)
RFID_MISO: P1.4 (MISO), U1.31 (IO19)
RFID_MOSI: P1.3 (MOSI), U1.33 (IO21)
RFID_RST: P1.7 (RST), U1.30 (IO18)
RFID_SCK: P1.2 (SCK), U1.36 (IO22)
SD_CLK: U1.27 (IO16), U4.4 (CLK)
SD_CS: U1.29 (IO5), U4.2 (CS)
SD_MISO: U1.26 (IO4), U4.5 (MISO)
SD_MOSI: U1.28 (IO17), U4.3 (MOSI)
SENSE: J4.4 (SENSE), U1.5 (SENSOR_VN)
SW_TOKEN: J4.5 (TRIG), U1.8 (IO32)
VOL_SIG: J1.2, U1.4 (SENSOR_VP)

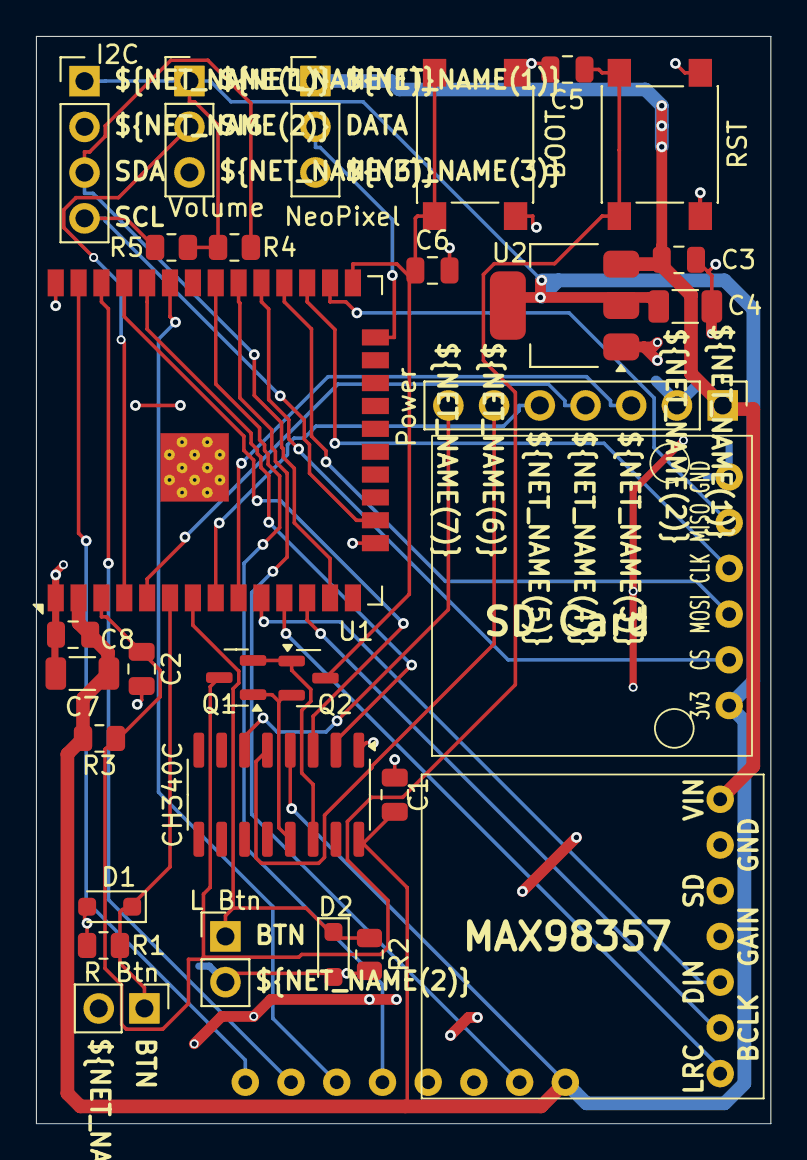
[picture p105: board timon-box.kicad_pcb from above]

Board: 2 copper layers, 40.8 x 60.4 mm, 31 parts (1 on the bottom side), 32 nets.
