aaronblankenburg/timon-box/src/LList.h

/*
	LinkedList.h - V1.1 - Generic LinkedList implementation
	Works better with FIFO, because LIFO will need to
	search the entire List to find the last one;

	For instructions, go to https://github.com/ivanseidel/LinkedList

	Created by Ivan Seidel Gomes, March, 2013.
	Released into the public domain.
*/


#ifndef LList_h
#define LList_h

#include <stddef.h>
#include <iterator>

template<class T>
struct ListNode
{
	T data;
	ListNode<T> *next;

	ListNode<T>(ListNode<T>* _next = nullptr) : next(_next) {}
	ListNode<T>(const T _v, ListNode<T>* _next = nullptr) : data(_v), next(_next) {}
};

template <typename T>
class LList{

protected:
	int _size;
	ListNode<T> *root;
	ListNode<T>	*last;

	// Helps "get" method, by saving last position
	ListNode<T> *lastNodeGot = nullptr;
	int lastIndexGot=0;		// cached node index

	ListNode<T>* getNode(int index);

	ListNode<T>* findEndOfSortedString(ListNode<T> *p, int (*cmp)(T &, T &));

public:
	LList();
	LList(int sizeIndex, T _t); //initiate list size and default value
	virtual ~LList();

	/*
		Returns current size of LinkedList
	*/
	virtual int size() const;
	/*
		Adds a T object in the specified index;
		Unlink and link the LinkedList correcly;
		Increment _size
	*/
	virtual bool add(int index, T);
	/*
		Adds a T object in the end of the LinkedList;
		Increment _size;
	*/
	virtual bool add(T);
	/*
		Adds a T object in the start of the LinkedList;
		Increment _size;
	*/
	virtual bool unshift(T);
	/*
		Set the object at index, with T;
	*/
	virtual bool set(int index, T);
	/*
		Remove object at index;
		If index is not reachable, returns false;
		else, decrement _size
	*/
	virtual T remove(int index);
	/*
		Remove last object;
	*/
	virtual T pop();
	/*
		Remove first object;
	*/
	virtual T shift();
	/*
		Get the index'th element on the list;
		Return Element if accessible,
		else, return false;
	*/
	virtual T get(int index);

	/*
		Get first element of the list;
		Return Element if accessible,
		else, return false;
	*/
	virtual T head();

	/*
		Get last element of the list;
		Return Element if accessible,
		else, return false;
	*/
	virtual T tail();


	/*
		Return true if element with specified index exist
		note: this works faster than (uncached) get(index)
	*/
	virtual bool exist(int index) const;

	/*
		Clear the entire array
	*/
	virtual void clear();

	/*
		Sort the list, given a comparison function
	*/
	virtual void sort(int (*cmp)(T &, T &));


		// add support to array brakets [] operator
	inline T& operator[](int index); 
	inline T& operator[](size_t& i) { return this->get(i); }
  	inline const T& operator[](const size_t& i) const { return this->get(i); }

	/*
		ConstIterator class
		provides immutable forward iterator for the list
	*/
	struct ConstIterator {
	    using iterator_category = std::forward_iterator_tag;
		using difference_type   = std::ptrdiff_t;
		using value_type        = T;
		using pointer           = T*;
		using reference         = T&;

		ConstIterator(ListNode<T> *ptr = nullptr) : m_ptr(ptr) {}

		const reference operator*() const { return m_ptr->data; }
		const pointer operator->() const { return &m_ptr->data; }

		// Prefix increment
		ConstIterator& operator++() { m_ptr=m_ptr->next; return *this; }

		// Postfix increment
		ConstIterator operator++(int) { Iterator tmp = *this; m_ptr=m_ptr->next; return tmp; }

		friend bool operator== (const ConstIterator& a, const ConstIterator& b) { return a.m_ptr == b.m_ptr; };
		friend bool operator!= (const ConstIterator& a, const ConstIterator& b) { return a.m_ptr != b.m_ptr; };

		protected:
			ListNode<T> *m_ptr;
	};

	/*
		Iterator class
		inherits from ConstIterator, provides mutable forward iterator for the list
	*/
	struct Iterator : public ConstIterator {
	    using iterator_category = std::forward_iterator_tag;
		using difference_type   = std::ptrdiff_t;
		using value_type        = T;
		using pointer           = T*;
		using reference         = T&;

		Iterator(ListNode<T> *ptr = nullptr) : ConstIterator(ptr) {}
		Iterator(){}

		reference operator*() { return this->m_ptr->data; }
		pointer operator->() { return &this->m_ptr->data; }
	};

	// iterator methods
	ConstIterator cbegin() const { return ConstIterator(root); }
	ConstIterator cend() const { return ConstIterator(nullptr); }   // same as last->next for non-empty list
	Iterator begin() { return Iterator(root); }
	Iterator end() { return Iterator(nullptr); }                    // same as last->next for non-empty list

};

// Initialize LinkedList with false values
template<typename T>
LList<T>::LList()
{
	root=nullptr;
	last=nullptr;
	_size=0;
}

// Clear Nodes and free Memory
template<typename T>
LList<T>::~LList()
{
	ListNode<T>* tmp;
	while(root)
	{
		tmp=root;
		root=root->next;
		delete tmp;
	}
	last = nullptr;
	_size=0;
}

/*
	Actualy "logic" coding
*/

template<typename T>
ListNode<T>* LList<T>::getNode(int index){

	int _pos = 0;
	ListNode<T>* current = root;

	// Check if the node trying to get is
	// immediatly AFTER the previous got one
	if(lastIndexGot > 0 && lastIndexGot <= index){
		_pos = lastIndexGot;
		current = lastNodeGot;
	}

	while(_pos < index && current){
		current = current->next;

		_pos++;
	}

	// Check if the object index got is the same as the required
	if(_pos == index){
		lastIndexGot = index;
		lastNodeGot = current;

		return current;
	}

	return NULL;
}

template<typename T>
int LList<T>::size() const {
	return _size;
}

template<typename T>
LList<T>::LList(int sizeIndex, T _t){
	for (int i = 0; i < sizeIndex; i++){
		add(_t);
	}
}

template<typename T>
bool LList<T>::add(int index, T _t){
	if (index<0)
		return false;

	if(index >= _size)
		return add(_t);

	if(index == 0)
		return unshift(_t);

	lastIndexGot = index;
	ListNode<T> *_prev = getNode(--index);

	_prev->next = new ListNode<T>(_t, _prev->next);
	lastNodeGot = _prev->next;

	_size++;

	return true;
}

template<typename T>
bool LList<T>::add(T _t){
	
	if(root){
		// Already have elements inserted
		last->next = new ListNode<T>(_t);
		last = last->next;
	}else{
		// First element being inserted
		root = new ListNode<T>(_t);
		last = root;
	}

	_size++;
	lastIndexGot = _size;
	lastNodeGot = last;

	return true;
}

template<typename T>
bool LList<T>::unshift(T _t){

	if(_size == 0)
		return add(_t);

	root = new ListNode<T>(_t, root);
	
	_size++;

	lastIndexGot = 0;
	lastNodeGot = root;
	
	return true;
}


template<typename T>
T& LList<T>::operator[](int index) {
	return getNode(index)->data;
}

template<typename T>
bool LList<T>::set(int index, T _t){
	// Check if index position is in bounds
	if(index < 0 || index >= _size)
		return false;

	getNode(index)->data = _t;
	return true;
}

template<typename T>
T LList<T>::pop(){
	if(_size <= 0)
		return T();
	

	if(_size > 1){
		ListNode<T> *tmp = getNode(_size - 2);
		T ret = tmp->next->data;
		delete(tmp->next);
		tmp->next = nullptr;
		last = tmp;
		lastNodeGot = tmp;
		_size--;
		lastIndexGot = _size;
		--lastIndexGot;
		return ret;
	}else{
		// Only one element left on the list
		T ret = root->data;
		delete(root);
		root = nullptr;
		last = nullptr;
		lastNodeGot = nullptr;
		lastIndexGot = 0;
		_size = 0;
		return ret;
	}
}

template<typename T>
T LList<T>::shift(){
	if(_size <= 0)
		return T();

	if(_size > 1){
		ListNode<T> *_next = root->next;
		T ret = root->data;
		delete(root);
		root = _next;
		--_size;
		lastIndexGot = 0;
		lastNodeGot = root;

		return ret;
	}else{
		// Only one left, then pop()
		return pop();
	}

}

template<typename T>
T LList<T>::remove(int index){
	if (index < 0 || index >= _size)
	{
		return T();
	}

	if(index == 0)
		return shift();
	
	if (index == _size-1)
	{
		return pop();
	}

	ListNode<T> *tmp = getNode(--index);
	ListNode<T> *toDelete = tmp->next;
	T ret = toDelete->data;
	tmp->next = tmp->next->next;
	delete(toDelete);
	_size--;
	lastIndexGot = index;
	lastNodeGot = tmp;
	return ret;
}


template<typename T>
T LList<T>::get(int index){
	ListNode<T> *tmp = getNode(index);

	return (tmp ? tmp->data : T());
}

template<typename T>
void LList<T>::clear(){
	while(size() > 0)
		shift();
}

template<typename T>
void LList<T>::sort(int (*cmp)(T &, T &)){
	if(_size < 2) return; // trivial case;

	for(;;) {	

		ListNode<T> **joinPoint = &root;

		while(*joinPoint) {
			ListNode<T> *a = *joinPoint;
			ListNode<T> *a_end = findEndOfSortedString(a, cmp);
	
			if(!a_end->next	) {
				if(joinPoint == &root) {
					last = a_end;
					lastIndexGot = 0;
					return;
				}
				else {
					break;
				}
			}

			ListNode<T> *b = a_end->next;
			ListNode<T> *b_end = findEndOfSortedString(b, cmp);

			ListNode<T> *tail = b_end->next;

			a_end->next = NULL;
			b_end->next = NULL;

			while(a && b) {
				if(cmp(a->data, b->data) <= 0) {
					*joinPoint = a;
					joinPoint = &a->next;
					a = a->next;	
				}
				else {
					*joinPoint = b;
					joinPoint = &b->next;
					b = b->next;	
				}
			}

			if(a) {
				*joinPoint = a;
				while(a->next) a = a->next;
				a->next = tail;
				joinPoint = &a->next;
			}
			else {
				*joinPoint = b;
				while(b->next) b = b->next;
				b->next = tail;
				joinPoint = &b->next;
			}
		}
	}
}

template<typename T>
ListNode<T>* LList<T>::findEndOfSortedString(ListNode<T> *p, int (*cmp)(T &, T &)) {
	while(p->next && cmp(p->data, p->next->data) <= 0) {
		p = p->next;
	}
	
	return p;
}

template<typename T>
T LList<T>::head(){
        if(_size>0)
                return root->data;

        return T();
}

template<typename T>
T LList<T>::tail(){
        if(_size>0)
                return last->data;

        return T();
}

template<typename T>
bool LList<T>::exist(int index) const {
	if (_size>0 && index >= 0 && index < _size)
		return true;

	return false;
}

#endif
