aaronblankenburg/timon-box/src/web-ui.h

#ifndef WEB_UI_H
#define WEB_UI_H

// Shared page chrome for the management web UI: stylesheet, <head>, header with
// title + appearance toggle, segmented navigation and the closing footer.
// Styling follows Apple's Human Interface Guidelines (system font, #f5f5f7 ground,
// 18px cards, pill buttons, #0071e3 accent) in a light and a dark variant.

#include <ESPAsyncWebServer.h>

#include <memory>
#include <vector>

// ---------------------------------------------------------------------------
// Response body in 1 kB blocks
//
// AsyncResponseStream keeps the whole body in one cbuf and reallocates (and
// copies) it on every write beyond the initial size, so a 12 kB page briefly
// needs 24 kB of *contiguous* heap. After a few dozen uploads the heap is
// fragmented enough that this fails, and the failed new[] aborts the box.
// Blocks of 1 kB fit anywhere; the filler hands them out as the socket drains.
// ---------------------------------------------------------------------------

class PageBuffer : public Print {
  static constexpr size_t BLOCK = 1024;
  std::vector<std::unique_ptr<char[]>> blocks;
  size_t total = 0;

 public:
  size_t write(uint8_t c) override { return write(&c, 1); }

  size_t write(const uint8_t *data, size_t len) override {
    size_t done = 0;
    while (done < len) {
      size_t off = total % BLOCK;
      if (off == 0) {
        char *block = new (std::nothrow) char[BLOCK];
        if (!block) break;  // the page comes out truncated instead of resetting the box
        blocks.emplace_back(block);
      }
      size_t n = std::min(len - done, BLOCK - off);
      memcpy(blocks.back().get() + off, data + done, n);
      done += n;
      total += n;
    }
    return done;
  }

  size_t length() const { return total; }

  // Copies up to maxLen bytes starting at index; 0 once everything is out.
  size_t read(uint8_t *dst, size_t maxLen, size_t index) const {
    if (index >= total) return 0;
    size_t n = std::min(maxLen, total - index), done = 0;
    while (done < n) {
      size_t pos = index + done, off = pos % BLOCK;
      size_t k = std::min(n - done, BLOCK - off);
      memcpy(dst + done, blocks[pos / BLOCK].get() + off, k);
      done += k;
    }
    return done;
  }
};

// Sends a PageBuffer; the response owns it until the last byte is out.
//
// One TCP segment per call on purpose. The server asks for a whole send buffer
// (5.7 kB) at a time and lwIP copies that into ~1.5 kB segments, so a full write
// needs the buffer plus four segments of heap at once. On a fragmented heap
// tcp_write() then fails, returns 0, and ESPAsyncWebServer does not notice: the
// first 5.7 kB of the page (with the HTTP head) are simply lost and the browser
// shows the rest as text. Smaller writes need one segment and get through.
void sendBuffered(AsyncWebServerRequest *request, std::shared_ptr<PageBuffer> page, const char *contentType, bool noStore = false) {
  static constexpr size_t SEGMENT = 1436;  // TCP MSS on this network
  AsyncWebServerResponse *response = request->beginResponse(contentType, page->length(), [page](uint8_t *buf, size_t maxLen, size_t index) -> size_t {
    return page->read(buf, std::min(maxLen, SEGMENT), index);
  });
  if (noStore) response->addHeader("Cache-Control", "no-store");
  request->send(response);
}

// ---------------------------------------------------------------------------
// Favicon: a token with a play sign, the box's whole idea, in the box's colour (BOX_COLOR in
// platformio.ini), so the two boxes differ in the browser's tabs. Transparent around the disc:
// no frame that shows on light or dark tab bars.
// ---------------------------------------------------------------------------

#ifndef BOX_COLOR
#define BOX_COLOR "#0071e3"
#endif

static const char FAVICON_SVG[] =
    "<svg xmlns=\"http://www.w3.org/2000/svg\" viewBox=\"0 0 32 32\"><circle cx=\"16\" cy=\"16\" r=\"15\" fill=\"" BOX_COLOR
    "\"/><path d=\"M12.6 9.3v13.4l11.1-6.7z\" fill=\"#fff\"/></svg>";

// ---------------------------------------------------------------------------
// Stylesheet (raw string literal: no printf escaping needed, sent uncopied)
// ---------------------------------------------------------------------------
static const char PAGE_CSS[] = R"CSS(:root{color-scheme:light dark;--bg:#f5f5f7;--card:#fff;--text:#1d1d1f;--text2:#6e6e73;--text3:#86868b;--accent:#0071e3;--accent-tint:rgba(0,113,227,.12);--accent-ring:rgba(0,113,227,.3);--danger:#ff3b30;--danger-tint:rgba(255,59,48,.12);--ok:#34c759;--ok-tint:rgba(52,199,89,.14);--warn:#ff9f0a;--warn-tint:rgba(255,159,10,.16);--sep:rgba(0,0,0,.08);--seg:#e8e8ed;--seg-active:#fff;--field:#fff;--row-hover:rgba(0,0,0,.03);--shadow:0 2px 12px rgba(0,0,0,.06);--shadow-seg:0 1px 3px rgba(0,0,0,.12)}
@media (prefers-color-scheme:dark){:root:not([data-theme="light"]){--bg:#000;--card:#1c1c1e;--text:#f5f5f7;--text2:#86868b;--text3:#6e6e73;--accent:#0a84ff;--accent-tint:rgba(10,132,255,.18);--accent-ring:rgba(10,132,255,.4);--danger:#ff453a;--danger-tint:rgba(255,69,58,.18);--ok:#30d158;--ok-tint:rgba(48,209,88,.18);--warn:#ffd60a;--warn-tint:rgba(255,214,10,.18);--sep:rgba(255,255,255,.12);--seg:#2c2c2e;--seg-active:#636366;--field:#2c2c2e;--row-hover:rgba(255,255,255,.04);--shadow:0 2px 12px rgba(0,0,0,.4);--shadow-seg:0 1px 3px rgba(0,0,0,.5)}}
:root[data-theme="dark"]{--bg:#000;--card:#1c1c1e;--text:#f5f5f7;--text2:#86868b;--text3:#6e6e73;--accent:#0a84ff;--accent-tint:rgba(10,132,255,.18);--accent-ring:rgba(10,132,255,.4);--danger:#ff453a;--danger-tint:rgba(255,69,58,.18);--ok:#30d158;--ok-tint:rgba(48,209,88,.18);--warn:#ffd60a;--warn-tint:rgba(255,214,10,.18);--sep:rgba(255,255,255,.12);--seg:#2c2c2e;--seg-active:#636366;--field:#2c2c2e;--row-hover:rgba(255,255,255,.04);--shadow:0 2px 12px rgba(0,0,0,.4);--shadow-seg:0 1px 3px rgba(0,0,0,.5)}
*,*::before,*::after{box-sizing:border-box}
[hidden]{display:none!important}
html{-webkit-text-size-adjust:100%}
body{margin:0;background:var(--bg);color:var(--text);font:17px/1.45 -apple-system,BlinkMacSystemFont,"SF Pro Text","Helvetica Neue",Helvetica,Arial,sans-serif;-webkit-font-smoothing:antialiased;overflow-x:hidden}
main{max-width:640px;margin:0 auto;padding:28px 16px 48px;display:flex;flex-direction:column;gap:20px}
header{display:flex;flex-direction:column;gap:4px;padding:8px 4px 0}
.title-row{display:flex;align-items:center;justify-content:space-between;gap:12px}
.theme-ctl{display:flex;align-items:center;gap:8px}
.theme-btn{background:var(--seg);color:var(--text)}
.theme-btn .ic-moon{display:none}
:root[data-theme="dark"] .theme-btn .ic-sun{display:none}
:root[data-theme="dark"] .theme-btn .ic-moon{display:block}
@media (prefers-color-scheme:dark){:root:not([data-theme="light"]) .theme-btn .ic-sun{display:none}:root:not([data-theme="light"]) .theme-btn .ic-moon{display:block}}
h1{margin:0;font-size:34px;line-height:1.1;font-weight:700;letter-spacing:-.02em}
.sub{margin:0;color:var(--text2);font-size:15px;overflow-wrap:anywhere}
.sub code{font:inherit;font-variant-numeric:tabular-nums}
h2{margin:0;font-size:22px;line-height:1.2;font-weight:600;letter-spacing:-.01em}
p{margin:0}
form{margin:0}
.muted{color:var(--text2)}
.small{font-size:15px}
.mono{font-variant-numeric:tabular-nums}
.seg{display:grid;grid-auto-flow:column;grid-auto-columns:1fr;gap:2px;padding:2px;background:var(--seg);border-radius:10px}
.seg a{display:flex;align-items:center;justify-content:center;height:34px;border-radius:8px;text-decoration:none;color:var(--text);font-size:15px;font-weight:500;transition:background .2s,box-shadow .2s}
.seg a[aria-current="page"]{background:var(--seg-active);box-shadow:var(--shadow-seg);font-weight:600}
.seg a:focus-visible{outline:none;box-shadow:0 0 0 3px var(--accent-ring)}
.card{background:var(--card);border-radius:18px;box-shadow:var(--shadow);padding:20px;display:flex;flex-direction:column;gap:16px}
.card.flush{padding:0;overflow:hidden}
.card.flush .card-head,.card.flush .lead{padding-left:20px;padding-right:20px}
.card.flush .card-head{padding-top:20px}
.card.flush .lead{padding-bottom:6px}
.card-head{display:flex;align-items:baseline;justify-content:space-between;gap:12px;flex-wrap:wrap}
section{display:flex;flex-direction:column;gap:16px}
.btn{appearance:none;border:0;cursor:pointer;font:inherit;font-size:17px;font-weight:500;line-height:1;padding:11px 20px;border-radius:980px;background:var(--accent);color:#fff;text-decoration:none;display:inline-flex;align-items:center;justify-content:center;transition:transform .12s,opacity .2s;white-space:nowrap}
.btn:active{transform:scale(.97)}
.btn:disabled,.btn[aria-disabled="true"]{opacity:.45;cursor:default;transform:none;pointer-events:none}
.btn.secondary{background:var(--accent-tint);color:var(--accent)}
.btn.destructive{background:var(--danger-tint);color:var(--danger)}
.btn.small{font-size:15px;padding:8px 16px}
.btn:focus-visible{outline:none;box-shadow:0 0 0 4px var(--accent-ring)}
.icon-btn{appearance:none;border:0;cursor:pointer;width:36px;height:36px;border-radius:50%;display:inline-flex;align-items:center;justify-content:center;background:var(--accent-tint);color:var(--accent);transition:transform .12s;flex:none;padding:0}
.icon-btn:active{transform:scale(.92)}
.icon-btn.destructive{background:var(--danger-tint);color:var(--danger)}
.icon-btn.playing{background:var(--accent);color:#fff}
.icon-btn:focus-visible{outline:none;box-shadow:0 0 0 4px var(--accent-ring)}
.ic{display:block;width:16px;height:16px;background:currentColor;-webkit-mask:var(--m) center/contain no-repeat;mask:var(--m) center/contain no-repeat}
.theme-btn .ic{width:18px;height:18px}
.ic-play{--m:url("data:image/svg+xml,<svg xmlns='http://www.w3.org/2000/svg' viewBox='0 0 16 16'><path d='M4 2.5v11l9-5.5z'/></svg>")}
.ic-trash{--m:url("data:image/svg+xml,<svg xmlns='http://www.w3.org/2000/svg' viewBox='0 0 16 16' fill='none' stroke='black' stroke-width='1.8' stroke-linecap='round'><path d='M2.5 4h11M6 4V2.5h4V4M4 4l.7 9.5h6.6L12 4M6.5 7v4M9.5 7v4'/></svg>")}
.ic-sun{--m:url("data:image/svg+xml,<svg xmlns='http://www.w3.org/2000/svg' viewBox='0 0 16 16' fill='none' stroke='black' stroke-width='1.6' stroke-linecap='round'><circle cx='8' cy='8' r='3.2'/><path d='M8 1.5v1.6M8 12.9v1.6M1.5 8h1.6M12.9 8h1.6M3.4 3.4l1.1 1.1M11.5 11.5l1.1 1.1M3.4 12.6l1.1-1.1M11.5 4.5l1.1-1.1'/></svg>")}
.ic-moon{--m:url("data:image/svg+xml,<svg xmlns='http://www.w3.org/2000/svg' viewBox='0 0 16 16'><path d='M9.6 1.8a6.3 6.3 0 1 0 4.6 8.7A5.2 5.2 0 0 1 9.6 1.8z'/></svg>")}
.ic-check{--m:url("data:image/svg+xml,<svg xmlns='http://www.w3.org/2000/svg' viewBox='0 0 18 18' fill='none' stroke='black' stroke-width='2' stroke-linecap='round' stroke-linejoin='round'><path d='M3.5 9.5l3.5 3.5 7.5-8'/></svg>")}
.ic-lock{--m:url("data:image/svg+xml,<svg xmlns='http://www.w3.org/2000/svg' viewBox='0 0 18 18' fill='none' stroke='black' stroke-width='1.6'><rect x='4' y='8' width='10' height='7' rx='1.5'/><path d='M6.5 8V6a2.5 2.5 0 015 0v2'/></svg>")}
.actions{display:flex;gap:10px;flex-wrap:wrap;align-items:center}
.actions.between{justify-content:space-between}
.field{display:flex;flex-direction:column;gap:6px}
.field label{font-size:13px;font-weight:600;letter-spacing:.04em;text-transform:uppercase;color:var(--text2)}
.input{width:100%;font:inherit;font-size:17px;padding:12px 14px;border-radius:12px;border:1px solid var(--sep);background:var(--field);color:var(--text);outline:none;transition:box-shadow .15s,border-color .15s}
.input:focus{border-color:var(--accent);box-shadow:0 0 0 4px var(--accent-ring)}
.input::placeholder{color:var(--text3)}
.hint{font-size:13px;color:var(--text2)}
.row-inline{display:flex;gap:10px;align-items:stretch}
.row-inline .input{flex:1;min-width:0}
.pill{display:inline-flex;align-items:center;gap:6px;padding:4px 10px;border-radius:980px;font-size:13px;font-weight:600;line-height:1.3;font-variant-numeric:tabular-nums;white-space:nowrap}
.pill.ok{background:var(--ok-tint);color:var(--ok)}
.pill.warn{background:var(--warn-tint);color:var(--warn)}
.pill.danger{background:var(--danger-tint);color:var(--danger)}
.pill.accent{background:var(--accent-tint);color:var(--accent)}
.pill.neutral{background:var(--seg);color:var(--text2)}
.dot{width:8px;height:8px;border-radius:50%;background:currentColor}
.kv{display:grid;grid-template-columns:auto 1fr;gap:10px 20px;align-items:center;font-size:15px;margin:0}
.kv dt{margin:0;color:var(--text2)}
.kv dd{margin:0;text-align:right;overflow-wrap:anywhere;font-variant-numeric:tabular-nums}
.list{list-style:none;margin:0;padding:0}
.list li{display:flex;align-items:center;gap:14px;min-height:56px;padding:8px 20px;border-bottom:1px solid var(--sep)}
.list li:last-child{border-bottom:0}
.list li:hover{background:var(--row-hover)}
.list form{display:flex}
.name{flex:1;min-width:0;font-size:17px;overflow-wrap:anywhere;line-height:1.3}
.name .ext{color:var(--text3);font-size:13px;margin-left:4px}
.name .meta{display:block;font-size:13px;color:var(--text2)}
.empty{padding:28px 20px;text-align:center;color:var(--text2);font-size:15px}
.pager{display:flex;align-items:center;justify-content:space-between;gap:12px;padding:14px 20px;border-top:1px solid var(--sep);font-size:15px;color:var(--text2)}
.progress{position:relative;height:6px;border-radius:980px;background:var(--seg);overflow:hidden}
.progress>i{position:absolute;top:0;bottom:0;left:0;width:0;background:var(--accent);border-radius:980px;transition:width .3s}
.dropzone{display:flex;flex-direction:column;align-items:center;justify-content:center;gap:6px;padding:26px 16px;border:1.5px dashed var(--sep);border-radius:14px;background:var(--bg);text-align:center;color:var(--text2);font-size:15px;cursor:pointer;transition:border-color .15s,background .15s}
.dropzone strong{color:var(--text);font-weight:600}
.dropzone.over{border-color:var(--accent);border-style:solid;background:var(--accent-tint);color:var(--accent)}
.dropzone.over strong{color:var(--accent)}
.ulist{list-style:none;margin:0;padding:0;border:1px solid var(--sep);border-radius:14px;overflow-x:hidden;overflow-y:auto;max-height:260px}
.ulist li{display:flex;align-items:center;gap:10px;padding:8px 12px;border-bottom:1px solid var(--sep);font-size:15px}
.ulist li:last-child{border-bottom:0}
.ulist .fn{flex:1;min-width:0;overflow-wrap:anywhere}
.ulist .fp{color:var(--text2);font-size:13px;font-variant-numeric:tabular-nums;white-space:nowrap}
.ulist .fz{color:var(--text3);font-size:13px;font-variant-numeric:tabular-nums;white-space:nowrap;min-width:4.5em;text-align:right}
.st{width:18px;height:18px;flex:none;border-radius:50%;border:1.5px solid var(--sep);display:flex;align-items:center;justify-content:center}
.st.up{border:2px solid var(--accent-ring);border-top-color:var(--accent);animation:spin .8s linear infinite}
.st.sv{border:2px solid var(--ok-tint);border-top-color:var(--ok);animation:spin .8s linear infinite}
.st.ok{border:0;background:var(--ok-tint);color:var(--ok)}
.st.err{border:0;background:var(--danger-tint);color:var(--danger)}
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
