aaronblankenburg/timon-box/(commit log)

2025-01-06 save ram by using printf and destruct audio and playlist before server start
2025-01-10 fix filename sanitizing, renaming and add buttons for song selection
    [management-server.h]
2025-06-19 improve battery reading via lowpass filter and add neo pixel for state visualization
2025-06-22 reduce rfid antenna gain to read tags more reliably
2025-07-28 fix low battery audio warning and led
    [main.ino, management-server.h]
2025-07-29 fix wrong red led after each song
    [main.ino]
2025-08-06 pull up POWER_SUPPLY_PIN as early as possible
2025-08-08 use pull up on power supply pin
2025-10-16 add low pass filter for knock sensor to filter hf noise from speaker
    [knock.cpp]
2025-10-16 reduce thresholds for right and left sensor
2025-10-16 reduce circle diameter of token to 44.5mm
2025-10-17 optimize knock low pass filter
2026-09-06 improve knock sensor
2026-09-06 style web UI like an Apple product
    Replace the classless CSS framework with a hand-written stylesheet
    following Apple's HIG (system font, #f5f5f7 ground, 18px cards, pill
    buttons, #0071e3 accent) in light and dark variants. The appearance
    follows the system setting; a toggle in the header stores an override
    in a cookie that the server reads to stamp the theme before rendering.
    Pages now share a common chrome (web-ui.h): proper <head> with
    viewport, title from BOX_NAME instead of the hard-coded "Timon-Box",
    segmented Files | Upload navigation. The file list is an iOS-style
    grouped list with play/trash icon buttons and a delete confirmation;
    the upload page shows status, upload progress text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
    [management-server.h, web-ui.h]
2026-09-06 add optional Wi-Fi station mode with mDNS and setup page
    In management mode the box now joins a saved home network as a station
    and announces itself via mDNS as <box-name>.local (timon-box.local,
    julius-box.local). Credentials are entered on the new Wi-Fi page and
    stored in NVS, nothing lives in the code. Without saved credentials, or
    when the network is not reachable within 15 s, the box falls back to
    the old behaviour: an open hotspot named BOX_NAME with captive portal.
    The management server starts as soon as the management token is placed
    and offers only the Wi-Fi tab; placing an album token adds Files and
    Upload for that album, swapping tokens switches albums, and the box
    powers off aft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
    [main.ino, management-server.h, playerI2S.h, web-ui.h, wifi-setup.h]
2026-09-06 power off immediately when the album token is removed in management mode
    Removing the album token again means "done": the box shuts down and
    restarts right away, as it did before the management server rework.
    The 60 s grace period now only covers the gap between removing the
    management token and placing the album token. Re-inserting the
    management token no longer deselects the album, so that path is gone.
    [main.ino, management-server.h]
2026-09-06 fix hidden attribute being overridden by display rules
    Elements with class btn or notice set display explicitly, which beats
    the browser's [hidden]{display:none}. All buttons of the upload dialog
    and the "Auto" theme button were therefore always visible. Add an
    explicit [hidden] rule to the stylesheet.
    [web-ui.h]
2026-09-06 retry Wi-Fi scans and pre-scan when the hotspot starts
    The first scan after enabling the station interface fails regularly
    because the Arduino core does not wait for the interface to start, and
    its scanComplete() reports failure after a fixed 6 s. A failed attempt
    is now retried up to three times before the page sees a failure, the
    hotspot triggers a scan right after coming up, and the failure text no
    longer claims a scan failed when the user has not asked for one.
    [wifi-setup.h]
2026-09-06 hand the browser over to <box>.local after connecting from the portal
    After a successful connection test from the hotspot the box reports the
    result, waits 5 s and then shuts the hotspot down, so the client rejoins
    its home network. The setup page probes /wifi-status on <box>.local
    (CORS-enabled) and redirects there as soon as it answers, also when the
    hotspot disappears under the page. The IP address is offered as a
    fallback link for clients that cannot resolve .local.
    [wifi-setup.h]
2026-09-06 show free SD card space on the status card
    Replaces the free-heap row with "x free of y" for the SD card, in MB or
    GB. Read under the file mutex so it cannot collide with an upload.
    [management-server.h]
2026-09-06 rework upload: drag & drop, byte-accurate progress, modal dialog
    The dropzone accepts dropped files (MP3 only, others are counted as
    skipped) and highlights while dragging. Uploads use XMLHttpRequest so
    the progress bar follows bytes on the wire, with rate and remaining
    time after a few seconds, a "saving" state while the box renames the
    file, and a per-file list with status icons. Failed files can be
    retried on their own; the selection is checked against the free SD
    space before starting.
    The upload itself runs in a <dialog> with a blurred backdrop so it is
    obvious that leaving the page cancels it: Escape is ignored while
    busy, the browser warns on unload, and the only action during the
    up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
    [management-server.h, web-ui.h]
2026-09-06 show a hint while only the management token is placed
    Without an album token the pages show a notice asking to swap in the
    token of the album to edit. The notice polls the new /album endpoint
    and jumps to the file list as soon as an album is recognised.
    [management-server.h, web-ui.h]
2026-09-06 document the firmware state machine
    doc/state-machine.html renders the main state machine (playback,
    Bluetooth, management mode with its network sub-states), the token
    rules of the management mode and a table of all timeouts as Mermaid
    diagrams in the LED colours. Linked from the README.
2026-09-06 keep the upload dialog open after a successful upload
    The dialog no longer jumps to the file list on its own; the user
    chooses between Show files and Close.
    [management-server.h]
2026-09-06 keep the token id out of the folder name field
    The album folder is "<name>_<tag>", or just "<tag>" for a token that
    never got a name. The Rename Folder field showed the full id in the
    latter case and the bare name in the former. The web server now knows
    the selected token's id, always strips it for display (an unnamed album
    shows an empty field with a placeholder) and always appends it when
    renaming, instead of guessing a 14-character suffix.
2026-09-06 speed up uploads: raw body, buffered SD writes, three parallel connections
    Per connection the ESP32 accepts at most CONFIG_LWIP_TCP_WND_DEFAULT
    (5760 bytes) per round trip, so a single upload tops out at roughly
    200 kB/s regardless of parser or SD speed. The page now uploads up to
    three files at once, each on its own connection with its own temp file
    (/temp_<n>), which multiplies the aggregate throughput for albums.
    The file is sent as raw request body (name in the query string) and
    taken by a body handler instead of the byte-wise multipart parser, and
    written to the SD card from a 16 kB buffer per connection instead of
    once per TCP chunk. An existing track of the same name is overwritten
    i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
2026-09-06 fix parallel uploads: SD writer task and longer receive timeout
    With several uploads in flight the AsyncTCP task wrote every full
    buffer to the SD card itself and was blocked for tens of milliseconds
    each time. Packets of the other connections queued up behind it, so
    ESPAsyncWebServer's 3 s receive timeout fired and closed them, which
    the browser reported as ERR_CONNECTION_RESET. The fail-and-restart
    churn also fragmented the heap (buffers fell back to 8 and 4 kB).
    Upload data now goes through a pool of four 16 kB buffers to a
    dedicated writer task pinned to core 1, which is the only code writing
    upload data to the card; the network task never blocks on SD I/O and
    SD writes overlap with rec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
    [management-server.h]
2026-09-06 style scrollbars like macOS
    Thin, rounded, semi-transparent grey thumb on an invisible track for
    the file list in the upload dialog, the dialog itself and the page,
    via scrollbar-width/scrollbar-color plus the ::-webkit-scrollbar
    fallback. Colours come from the theme tokens, so both themes match.
    Safari on Apple devices keeps its native overlay scrollbars.
2026-09-06 add link diagnostics: power-save log and /speedtest download
    Uploads plateau around 260 kB/s no matter how many connections run,
    while the SD card is busy only 12 % of the time, so the limit is either
    the radio link or the receive path. On connecting, the box now logs
    whether modem sleep is really off and which PHY modes the access point
    offers, and GET /speedtest streams 4 MB of filler so the download
    direction (unaffected by the small TCP receive window) can be measured
    with curl.
2026-09-06 throttle battery ADC sampling and yield in the management loop
    loop() read the battery ADC on every iteration, several thousand times
    a second, and spun without ever yielding. Each analogRead() toggles
    the SAR ADC power domain the WiFi PHY shares, and a core that runs
    flash-resident code non-stop competes with the WiFi and lwIP tasks for
    the flash cache (the Arduino build has the WiFi IRAM optimisations
    off). With the box next to the router (RSSI -16 dBm) the ping floor
    still sat at 8 ms and throughput at ~250 kB/s, so the radio link is
    not the limit.
    The battery is now sampled every 10 ms with a ~0.5 s filter, and the
    management states sleep 1 ms per iteration; nothing there needs more.
2026-09-07 free heap so pages keep loading: lazy copy worker, smaller upload buffers
    Serving a page needs a contiguous block of up to 5.8 kB for the TCP
    send buffer on every ack. The copy worker's 8 kB stack plus the 32 kB
    upload pool pushed the free heap below that in hotspot mode, so
    /app.js died with "_ack(): Failed to allocate" and every page was left
    without its script, which is why the Wi-Fi page never listed a network.
    The copy worker is now created on the first copy job instead of at
    startup and uses a 6 kB stack, and the upload pool is 4 x 4 kB instead
    of 4 x 8 kB, which together leave about 24 kB more heap. The startup
    log reports the largest free block next to the total.
    [box-sync.h, management-server.h]
2026-09-07 show copy progress in a dialog like the upload
    The copy page only had a thin bar in the card. It now opens the same
    kind of modal dialog the upload uses: overall bar, "File 3 of 12 ·
    48 MB of 112 MB · 43 %", transfer rate and remaining time from a
    sliding window over the polled byte count, and the file list moved
    into the dialog with a per-file percentage for the track in flight.
    Unlike the upload the transfer runs on the box, so the dialog says so
    and can be closed at any time; the card then offers "Show progress" to
    reopen it, and reopening the page while a copy runs shows the dialog
    again. When it ends the dialog switches to Done or Copy incomplete
    with Retry, Show files and Close.
2026-09-07 pulse the LED on the box that is handing tracks over
    Nothing on the serving box showed that it was busy: its web UI is not
    the one being watched, and its LED sat still. It now breathes the
    state colour (orange on the hotspot, cyan on the home network) between
    25 % and 100 % over about 1.2 s while tracks are going out, and
    returns to a steady light afterwards.
    The serving handlers count the transfers in flight and stamp the time
    of the last chunk; the tail of half a second keeps the LED pulsing
    across the gap between two files instead of blinking off. The low
    battery red still wins, since the pulse scales whatever colour the
    state would show.
2026-09-07 fix the copy page: fmt() was out of scope, so every render threw
    Hoisting the byte and time formatters next to esc() went wrong: the
    insertion was removed again instead of the copy inside the upload
    block, so fmt() ended up private to the upload page. The copy page
    threw ReferenceError on its first render, the promise chain swallowed
    it in the retry catch, and the page polled the status once a second
    forever while showing nothing: no file list, no Copy button, no
    progress. Uploads were unaffected, which is why this only showed up
    now.
    The formatters are back at the top level. While testing every state
    against a mock DOM, three more things came out: the Copy button
    ignored the live station f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
    [web-ui.h]
2026-09-07 copy: stop the temp file error and write the card in full blocks
    SD.remove() logs an error when the file is not there, and the copy
    removed /temp_sync unconditionally before every track, so each file
    produced a "does not exists" line. Both removes are guarded now.
    The download also wrote to the card once per read, and a read returns
    about one TCP segment, so the writes were ~1.4 kB and the card was
    busy 31 % of the time against the upload path's 12 %. Reads now fill
    the whole 4 kB buffer before it goes to the card, with the tail
    flushed at the end.
    [box-sync.h]
2026-09-07 read ahead when serving a track
    Measured against a box: 296 kB/s streaming filler from flash, 213 kB/s
    streaming a track from the SD card, so a quarter of the throughput
    went into the card. The response filler is asked for about one TCP
    segment at a time, so it did a 1.4 kB read per call, the same mistake
    the download side had.
    The serving side now refills a 4 kB buffer in one read and hands out
    segments from it. The buffer is borrowed from the upload pool, which
    is idle unless an upload runs at the same time; without one the filler
    falls back to reading per segment.
    [box-sync.h]
2026-09-07 copy two tracks at once
    Measured against a box: one connection pulls 200 kB/s, two pull about
    272 kB/s while both run, so a second stream is worth roughly a third
    more throughput.
    The worker now keeps SYNC_PARALLEL (2) transfers in flight from a
    single task: each slot has its own connection, temp file and buffer,
    and the task polls the sockets in turn. One task rather than two keeps
    the SD writes serialised and costs no second stack. Buffers still come
    from the upload pool, and however many are free is how many files are
    fetched at once, down to a single stream on a small static buffer.
    The status now carries the bytes per file instead of one "current"
    index, so both rows in the dialog sho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
2026-10-19 knock: sample the piezos at 2 kHz and detect a press by its hump
    During playback the main loop only comes round about 116 times a second, so
    the gaps between the half waves of a loud tone fell between two samples and
    trombone notes skipped tracks. An esp_timer now samples both sensors at 2 kHz
    on core 0. A press is one uninterrupted hump that lasts long enough or
    integrates to enough area; music is a train of short humps with gaps at zero.
    The levels are tunable per box in platformio.ini, `knockdebug:1/2` prints
    statistics and a raw trace.
    [knock.cpp, main.ino]
2026-10-19 upload: log why a file fails
    Every failure in the upload pipeline now says where it happened (temp file,
    write, move, no free buffer), with errno, free heap and the state of the
    buffer pool, and the browser gets that reason instead of one generic message.
    Upload start also prints how many pool buffers are free.
    [management-server.h]
2026-10-19 pages: build responses in 1 kB blocks
    AsyncResponseStream keeps the whole body in one buffer and reallocates and
    copies it on every write past its initial size. After a long upload the heap
    was too fragmented for that: opening the file list called new[] on a 10 kB
    largest block and the failed allocation aborted the box. Pages and list
    responses now go into 1 kB blocks that a filler hands out.
    The filler also serves one TCP segment per call. Asked for a whole send
    buffer, lwIP needs several segments of heap at once; on a fragmented heap
    tcp_write() then failed silently, the first 5.7 kB including the HTTP head
    were lost and the browser showed the page as text.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
    [box-sync.h, management-server.h, web-ui.h, wifi-setup.h]
2026-10-19 delete a whole album from the web UI
    A card on the upload page removes every track and the folder itself, after a
    confirmation that names the track count and the folder. The token gets a
    fresh, unnamed folder so it can be filled again right away. Refused while a
    box-to-box copy is running.
2026-10-19 say "shutting down" only once
    On USB power the supply stays on and the callers keep calling shutdownBox()
    on every loop iteration, which buried the console under the message.
2026-10-19 podcast spike: download into a file that plays while it grows
    Groundwork for podcast albums, driven from the serial console for now:
    - In player mode the Bluetooth memory goes back to the heap. The A2DP library
    links btStart(), so the core kept ~55 kB reserved at boot although Bluetooth
    only ever runs after a restart into Bluetooth mode.
    - gated-fs.h: a read-only file system for the audio library. The downloader
    does every SD access under a mutex, the player only tries it and returns
    0 bytes while the card is busy, so the decoder keeps playing from its buffer.
    The episode that is downloading reports its final size, serves only flushed
    data and reopens the real file when FATFS's s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
2026-10-19 player: write index files with more than 255 tracks
    The loop counter was a uint8_t, so an album with 256 or more tracks never
    finished writing index.txt and the watchdog restarted the box. The log line
    added the track count to a string pointer instead of printing it.
2026-10-19 player: survive a missing track and a track that fails to start
    A track listed in index.txt but gone from the card made playFile() reload the
    folder on top of the stale playlist and call itself again with the same entry
    until the stack overflowed. It now rebuilds the playlist from scratch and
    starts at the first track, or stops if the folder is empty.
    connecttoFS() also fails when the MP3 decoder cannot get its ~23 kB, and that
    set sdConnected = false, which reboots the box from loop(). Now only a card
    that no longer answers counts as an SD failure. The click and the alert go
    through the same path.
    [playerI2S.h]
2026-10-19 player: the click and the alert no longer move the playlist on
    audio_eof_mp3() also fires for tap.mp3 and alert.mp3, inside the wait loops
    of playClick() and playAlert(). For the 157 ms click that could start the
    next track on top of the knock's own next()/previous(); at low battery the
    alert's end called checkBattery() again, which played the alert again.
    [main.ino]
2026-10-19 player: continue a track where it was left, also after switching off
    last_played.txt gets a second line with the byte position to continue from,
    5 s before the spot that was heard last (computed from the bitrate, never
    inside the ID3 tag). It is written when the token is taken off, every minute
    while playing (only if the card is free right now, as a podcast download may
    be writing) and before the box switches off at the end of an album, which
    saves the start track without a position so the next round begins at the top.
    Placing the token continues the last track at that position. Files without the
    second line, from older firmware or from "Play next" in the web UI, start
    the track from the be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
2026-10-19 podcast: streaming RSS reader, episode file names, host tests
    podcast-feed.h, plain C++ so it also compiles on the host:
    - FeedParser reads RSS 2.0 as it arrives, in chunks of any size, with bounded
    memory: tags, attributes, entities, CDATA and comments, items and the few
    channel fields needed. The newest episode is the one with the latest pubDate,
    not the first one; trailers and video are skipped. It stops after five
    items unless the dates so far ascend (oldest first), then it reads on.
    - RFC 822 and ISO 8601 dates, including German month names some feeds use.
    - Episode files are named 2026-10-19_0400_<title>_<id>.mp3: chronological,
    4 hex digits from the guid keep them unique and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
    [podcast-feed.h, podcast.h]
2026-10-19 podcast albums: check the feed on insert and play the newest episode
    An album whose folder holds a podcast.txt (line 1: the feed URL, optionally
    keep=N) is a podcast. Placing its token starts the podcast task on core 0 and
    the box waits in the new state podcastLoading, the LED breathing green:
    - old episodes beyond keep (default 30) are removed while nothing plays;
    - Wi-Fi with the saved home network, then the feed over HTTP(S), read only as
    far as needed, the TLS session closed again before anything plays;
    - the newest episode complete on the card: it plays from there, no download;
    partly there: the rest is fetched with a Range request while the part plays;
    missing: it downloads and s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
    [gated-fs.h, main.ino, player.cpp, podcast.h]
2026-10-19 docs: podcast albums and continuing where a track was left
2026-10-19 knock: a gap in the samples starts the hump over
    While Wi-Fi is busy (a podcast download) or the flash is written, the timer
    task can miss samples. The gaps between the half waves of a tone may fall
    into such a blind spot, and the hump would look like one long press. A hump
    now starts over after more than 2 ms without samples, and late timer events
    are skipped instead of firing back to back. knockdebug:1 counts these as
    "blind".
    [knock.cpp]
2026-10-19 tools: a podcast server for testing downloads on the box
    Serves the MP3 files of a directory as a feed, with switches for what real
    servers do: no Range support, no Content-Length, chunked transfer, a rate
    limit, redirect chains (alternating absolute and relative Locations), a
    transfer that drops once per file, a big ID3 tag in front of every file, and
    oldest-first ordering.
2026-10-19 podcast: name the episode id hash so it does not overload web-ui's fnv1a
    The two overloads made the Arduino build warn about mismatching attributes.
2026-10-19 podcast: findings from the first runs on Julius
    Measured on the box (WROOM, no PSRAM):
    - Releasing the Bluetooth memory frees 48.8 kB (149868 -> 198656 at boot).
    - Idle in player mode 157 kB free; Wi-Fi up costs ~63 kB, a TLS session
    another ~60 kB. With TLS up only 31 kB were left and the MP3 decoder
    could not get its buffers, and with an episode playing the TLS handshake
    itself failed. So an episode plays next to a plain HTTP download only;
    6 of 8 test hosts serve the file over http, Anchor/Spotify and Podigee
    do not.
    - HTTP download while playing: 100-115 kB/s, 56-66 kB heap free.
    Fixes:
    - HttpStream::close() stops its clients itself. HTTPClient::end() only stops
    a client it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
    [main.ino, playerI2S.h, podcast.h]
2026-10-19 web UI: a Podcast tab of its own, before Wi-Fi
    The podcast settings move from the upload page to /podcast: a status card
    (on/off, podcast title, newest episode, how much of it is on the card, last
    check) and a Feed card with the directory search, the feed address, how many
    episodes to keep, Save and Remove. Saving returns to the Podcast page.
    Also on the box: the probe asks plain http first (saves a TLS handshake,
    ~3 s before the first sound; only a real 206 range answer counts), a log line
    when playback stops without a track end or a pause, and the serial test
    commands playat:<byte> and restart.
2026-10-19 gated-fs: a read error no longer stops playback for good
    After a read error the reader reopened the file only while it was still
    downloading. For a complete episode it reported size 0 from then on and
    never read again: the track hung at "0 of 0". The audio library has no
    end-of-file check before it has decoded the header, so retrying is the
    only way out. The reader now keeps the size it last saw, tries the open
    again every 200 ms and logs the errno.
    The growing file's path buffer takes 260 bytes, as the library allows
    paths up to 255.
    [gated-fs.h]
2026-10-19 podcast: the downloader writes through FATFS, not the VFS
    A track change during a download hit the downloader's file. Its write
    failed with EBADF at the moment the player closed one file and opened
    the next, and the player's first read on the new file failed with
    EACCES, a handle without read access. Both tasks went through the VFS
    and newlib stdio. The download task now uses FATFS directly with FIL
    objects of its own: episode, state file, podcast.txt, folder listing,
    delete and rename. FATFS locks the volume itself; sdGate stays.
    The VFS needs 5 open files again instead of 8. Each slot holds a 4 kB
    sector buffer, so the box has 12 kB more free heap all the time.
    The SD driver fails a writ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
    [player.cpp, podcast.h]
2026-10-19 podcast: small fixes in the main loop and the web UI
    - No "playback stopped by itself" message when the box shuts down.
    - The serial command podcasturl takes the number of episodes to keep:
    podcasturl:<url> <keep>.
    - The podcast card says "Feed last read": the time is the server's.
    [main.ino, management-server.h]
2026-10-20 gated-fs: the reader survives a restarted download and its own reopens
    The audio library checks its File before every read and gives up on it
    for good once it reports false. GatedFile reported the state of its
    inner handle, so whenever it closed that handle to reopen it (after a
    read error, or when a reopen failed) playback stopped at "0 of 0". The
    fix in 91e94c6 did not help with that. The file now reports open until
    the library closes it.
    When a download has to start over (a server without Range requests,
    after a dropped connection), the writer truncates the episode while it
    plays. A reader holding its old handle would follow freed clusters. The
    writer now counts up a generation together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
    [gated-fs.h, podcast.h]
2026-10-20 management: the box stays reachable when .local lookups fail
    Uploads to Timon's box failed from the third file on, and only a restart
    helped. The uploads themselves were fine: the browser could no longer
    look up timon-box.local. On this network the box never receives the
    multicast queries that resolve .local names. A query sent to it by
    unicast was answered 6 of 6 times, a multicast one 0 of 6. Its own
    announcements do reach the computers, so after a restart the name
    worked until their cached answer expired, about two minutes later.
    - In management mode the box announces its name again every minute,
    by setting its HTTP service's port anew. With that the name resolved
    in every check for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
    [management-server.h, web-ui.h, wifi-setup.h]
2026-10-20 docs: CLAUDE.md and doc/architecture.md for picking the project up again
    CLAUDE.md is loaded at the start of every Claude Code session: rules
    (branches, explicit staging, languages, both envs, flashing the right
    box), the test workflow, a file map and the pitfalls that cost time.
    doc/architecture.md describes each part in detail: states and timeouts,
    the single translation unit and what knock.cpp/player.cpp may include,
    the SD card layout and the rules for concurrent access, the audio
    library's quirks, the podcast pipeline and the growing file, management
    mode with network, routes, upload and web UI conventions, box-to-box
    copy, Bluetooth, the knock sensors, tasks and measured heap, testing,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
2026-10-20 podcast: continue where it was left, uploads after the episodes
    A podcast token used to start the newest episode on every new start
    (after the Bluetooth token, after switching off), and continued at the
    remembered spot only when that newest one was the track heard last.
    Listening to an older episode, the place was lost although nothing new
    had come.
    Now a new episode has priority only when the podcast task has just
    started downloading it, that is when it was not on the card at all.
    Otherwise the box continues the track heard last at its spot, whichever
    it is, as with albums. With nothing remembered it starts at the newest.
    Podcast folders now play in one order: episodes newest first, then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
2026-10-20 web UI: size and duration for every track
    The file list, the copy list, the podcast episodes and the upload
    selection show each track's size and duration.
    The duration comes from the start of the file, without decoding:
    mp3-info.h reads the first frame header and, where there is one, the
    Xing/Info or VBRI header with the frame count (exact for VBR and for
    LAME's CBR files), else size and bitrate. On the box mp3DurationMs()
    reads the ID3 header, seeks past the tag (WDR covers are 0.8 MB) and
    reads 4 kB. Checked against two real episodes: 24:51 and 26:10, as
    their feeds say.
    - Files: ten tracks a page, so a header read each.
    - Copy: /peer-album sends "<size>,<ms>\t<name>"; older firmware rea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
2026-10-20 web UI: durations cut off to the second, as feeds and players show them
2026-10-20 web UI: favicon as a transparent token in copper (Timon) and petrol (Julius)
    The rounded square showed as a frame around the white disc. Now the
    token itself is the coloured disc with a white play sign, transparent
    around it, which looks the same on light and dark tab bars.
2026-10-20 web UI: the Podcast page says when the hotspot has no internet
    In the box's own hotspot the device has no internet: the search (run by
    the browser) and Show episodes (run by the box) cannot work, and that
    only showed after trying. The page now opens with the same "Home
    network needed" notice the Copy page has, and greys out the search and
    Show episodes. Saving a feed address still works; the box loads the
    episodes in normal mode over the saved home network.
2026-10-25 doc: hardware guide with KiCad projects, gerbers and wiring tables
    doc/hardware.md describes how to rebuild a box: parts, both boards, how the
    power latch switches, the 7-pin cable with its wire colours, all other wiring,
    the two fixes the main board layout needs (notched XH socket, shortened SD
    module) and bring-up. It replaces the outdated diagram and photo dump in the
    README and doc/wiring.drawio.
    hardware/ holds the KiCad 8 projects of the main board and Power Latch V2,
    their schematics as PDF and gerbers. The main board's ground zone is refilled:
    the saved fill touched SD_MOSI. C2 is 1 uF in the schematic too, as fitted.
    sdcard/ holds tap.mp3 and alert.mp3, which the firmware plays fro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
    [power-latch-v2.kicad_pcb, power-latch-v2.kicad_sch, timon-box.kicad_pcb, timon-box.kicad_sch]
2026-10-25 doc: wiring diagram of the power side, made with WireViz
    hardware/wiring/power-side.yml describes the 7-pin cable with its wire
    colours and every wire on the power side: latch, boost converter, token
    switch, both 2N7000, USB-C, TP4056 and the cell. WireViz renders it to
    power-side.svg, which doc/hardware.md shows above the wiring tables.
2026-10-30 add model and assembly docs
    [box.step]
2026-10-31 update docs
    [pcb_spacer.step]
2026-11-01 add stls
    [timon-box_back.stl, timon-box_bambu-studio.3mf, timon-box_bumper-tpu.stl, timon-box_door.stl, timon-box_frame.stl, timon-box_front.stl, timon-box_next-button.stl, timon-box_pcb-spacer.stl]
2026-11-01 add english assembly document
